nockieboy/gpu/docs/MAX3421E USB HOST INTERFACE.pptx

## MAX3421E USB HOST INTERFACE

Initial setup

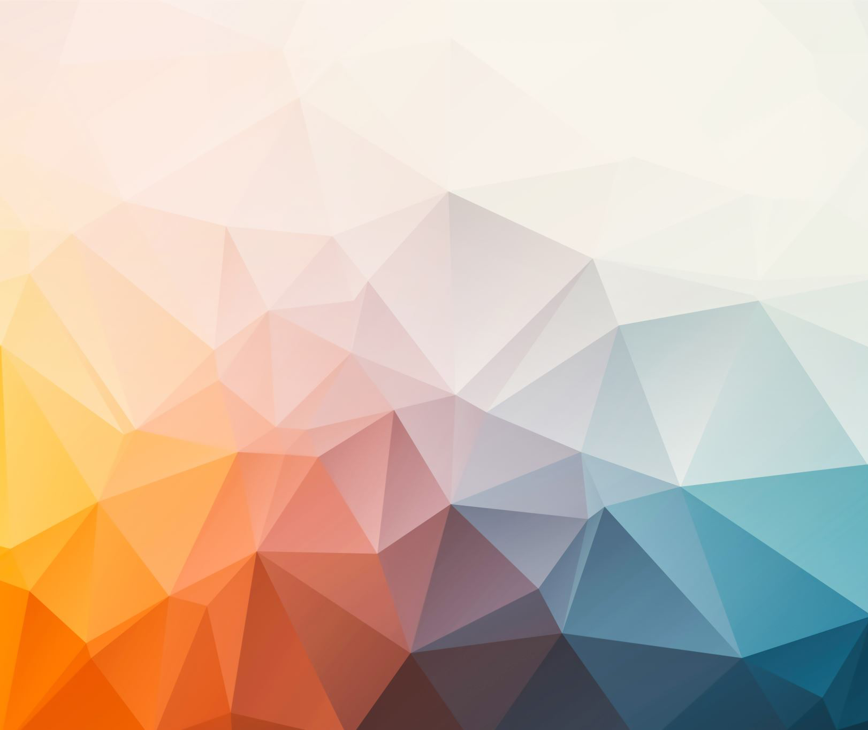
[picture p1: figure]

GPX-OK Initialisation
Set PINCTL:FDUPSPI, POSINT
MAX_reset()
Set IOPINS1:bit 0 off to turn off VBUS
Delay 200ms
Set IOPINS1:bit 1 on to turn on VBUS

Detect Device
Set MODE:DPPULLDN,DMPULLDN,HOST
Set HIRQ:CONDETIRQ
Set HCTL:SAMPLEBUS
Get HRSL & loop until HRSL[7:6] != 0

Set USB Speed
If HRSL[7] then set high speed MODE
SOFKAENAB
If HRSL[6] then set low speed MODE
SPEED, SOFKAENAB

MAX_reset()
Set USBIEN:OSCOKIE
Set USBCTL:CHIPRES
Set USBCTL:0
Delay 100ms
Read USBIRQ
Is OSCOKIRQ set?
Delay 50ms
Return

CTL_Read(value)
Bytes_to_read = value[6] + 256*value[7]
Wrbytes(SUDFIFO,8,value)
Result=Send_Packet(tokSETUP,0)
If (Result) return
Set HCTL:bmRCVTOG1
Result=IN_transfer(0,bytes_to_read)
If (Result) return
IN_nak_count = nak_count
Result=Send_Packet(tokOUTHS,0)
If (Result) return
Return

NO

Pause
Waitframes(200)
(Some devices require this)

waitframes(value)
Set HIRQ:FRAMEIRQ (clear any pending)
Get HIRQ:FRAMEIRQ
Loop until FRAMEIRQ is set
Increment counter
Does counter = value?
Return

Enumerate Device
BUS RESET
GET DEVICE DESCRIPTOR
BUS RESET
SET ADDRESS TO 7(?)
GET DEVICE DESCRIPTOR AT ASSIGNED ADDRESS

NO

## Device enumeration

- BUS RESET SET HCTL:BUSRST, then wait until HCTL:BUSRST goes LOW WaitFrames(200) to allow the device to recover from the bus reset
- GET DEVICE DESCRIPTOR maxPacketSize = 8 SET PERADDR:0 // first request to address 0 Get_Descriptor_Device[6]=8 // wLengthL Get_Descriptor_Device[7]=0 // wLengthH HR = CTLRead(Get_Descriptor_Device) // get device descriptor info into XfrData[] If (4-bit HRSL > 0) return // if HRSL bits report error maxPacketSize = XfrData[7]
- BUS RESET (as top)
- SET ADDRESS TO 7 HR = CTL_Write_ND(Set_Address_to_7) // CTL-Write, no data stage If (4-bit HRSL > 0) return // if HRSL bits report error WaitFrames(30) // Device gets 2 msec recovery time SET PERADDR:7 // Now all transfers go to addr 7
