nockieboy/gpu/docs/SD/SD_Interface.pptx

HOST COMMUNICATION WITH SD INTERFACE
Process/requirements:
- Set DMA memory location
- Write data to DMA memory location / clear DMA memory for RD
- Set sector address in SD interface
- Send command for RD/WR
- Loop if necessary
(Above relates primarily to lines 1346-1395 in CBIOS.ASM)
Interface requirements:
- Ability to send 32-bit commands to SD interface – 1 I/O port
- Ability to send 32-bit data to SD interface – 1 I/O port
If a fixed DMA address is used in DDR3 RAM, the second I/O port is not needed.

## Slide 2

ALL REGISTERS ARE 32-bit:
0x00 – ARGUMENT REGISTER (write to this to trigger command transaction)
0x01 – COMMAND REGISTER (low 16 bits):
15 14 13 12 11 10 9 8 7 6 5 4 3 2 1 0
Writing to the SD interface involves setting the COMMAND REGISTER first, then writing data (to be written, or I guess zeros if a read) to the ARGUMENT REGISTER.

COMMMAND INDEX

XFER SPEC

Chk response
for correct
command
index

Check
response
CRC

Chk response
for busy signal
after command
transaction

CHK CFG

## Slide 3

SD Interface – REGISTER read/writes
COMMAND’s upper two bytes will be zeros, the lower two bytes set by two I/O ports used for the upper and lower 8-bits. Reading these I/O ports will return current values for upper & lower 8-bits.
BRIDGETTE will assemble ARGUMENT as a 32-bit word from a pipelined set of I/O writes to one I/O port, incrementing to next byte in the 32-bit word with each write, from low to high significance.
Reading this I/O port will indicate which byte of the word is to be filled next (current byte pointer). Upon the 3rd (0-based) value being written, BRIDGETTE will construct two 32-bit transactions for the SD interface and transmit them over the Wishbone interface.
Total I/O ports required: 3.
This is only for access to the SD interface’s registers. SD card read/write operations will use the SD buffer in GPU RAM and just have the read/write transaction initiated through writing to the interface registers as outlined above.
