nockieboy/gpu/docs/USB HID Interface.docx

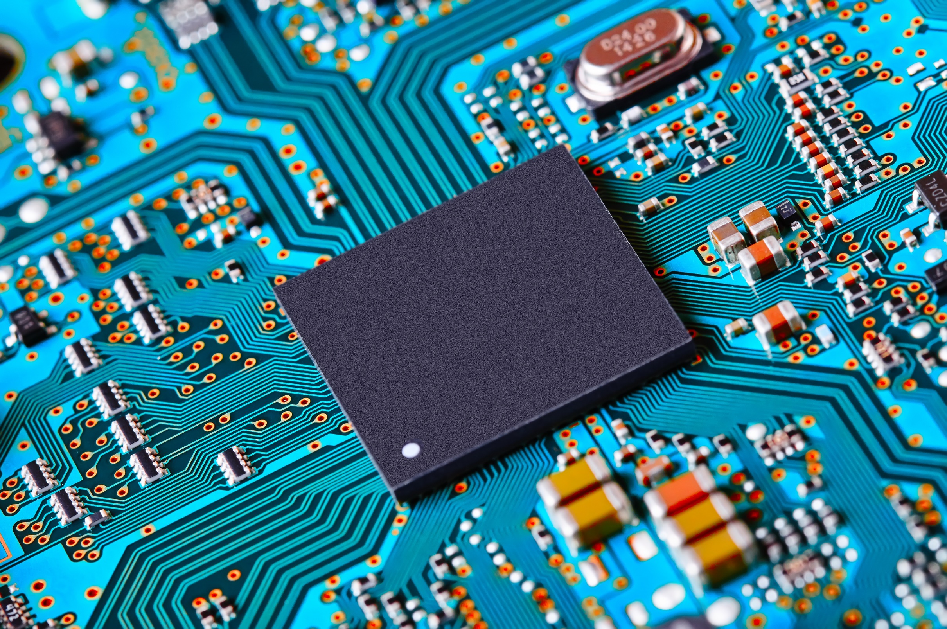
[picture p10: figure]
IT Infrastructure & Electronics Executive Search & Headhunters | Odgers Berndtson

# USB KEYBOARD INTERFACE

USB hid interface for the ucom

10103

Authored by: Jonathan Nock

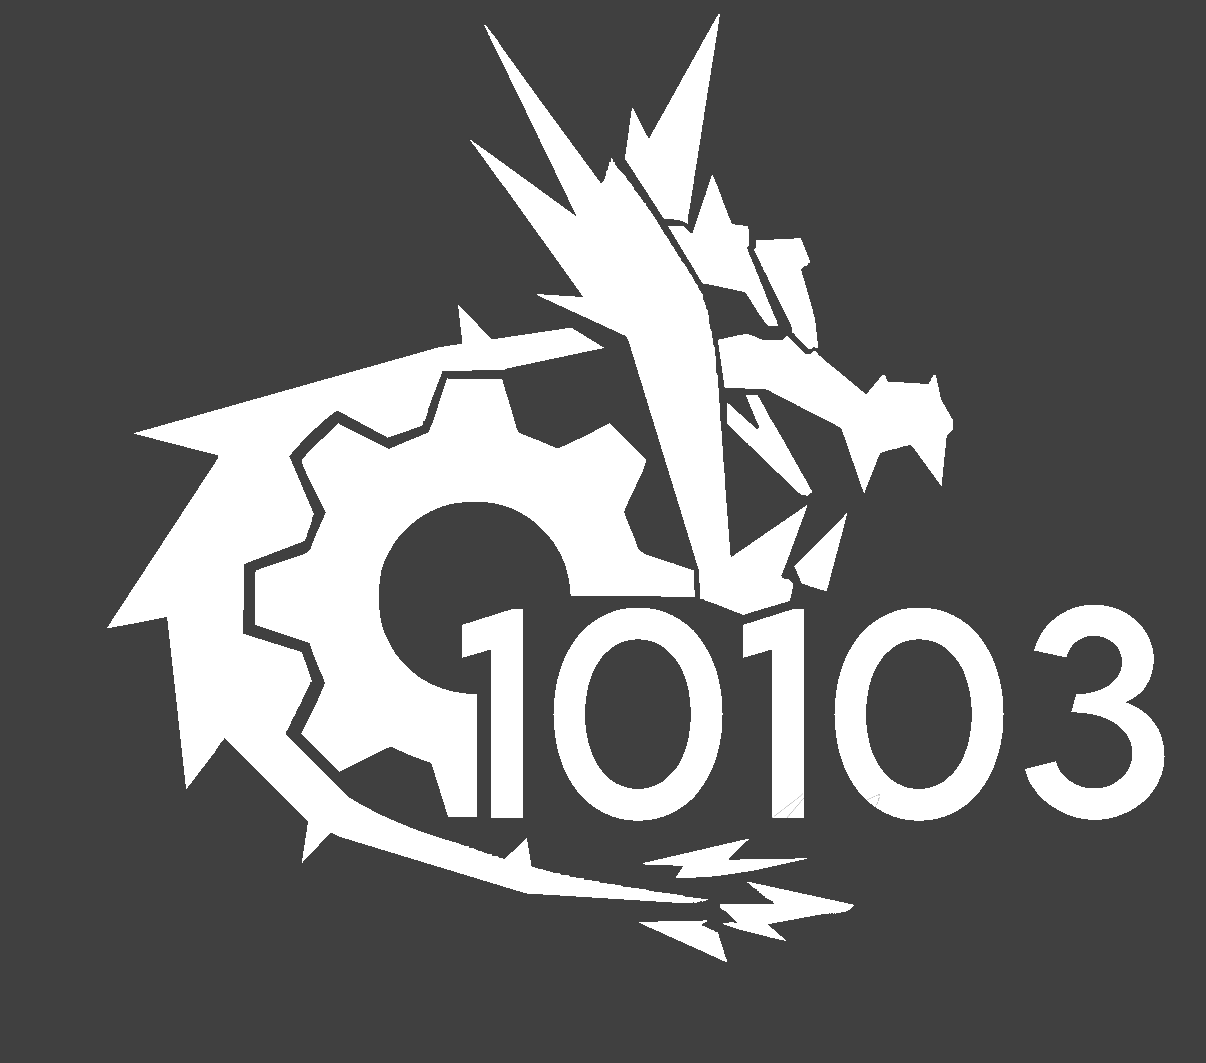
[picture p11: figure]

Notes:
