nockieboy/gpu/docs/GPU_Resolutions.pptx

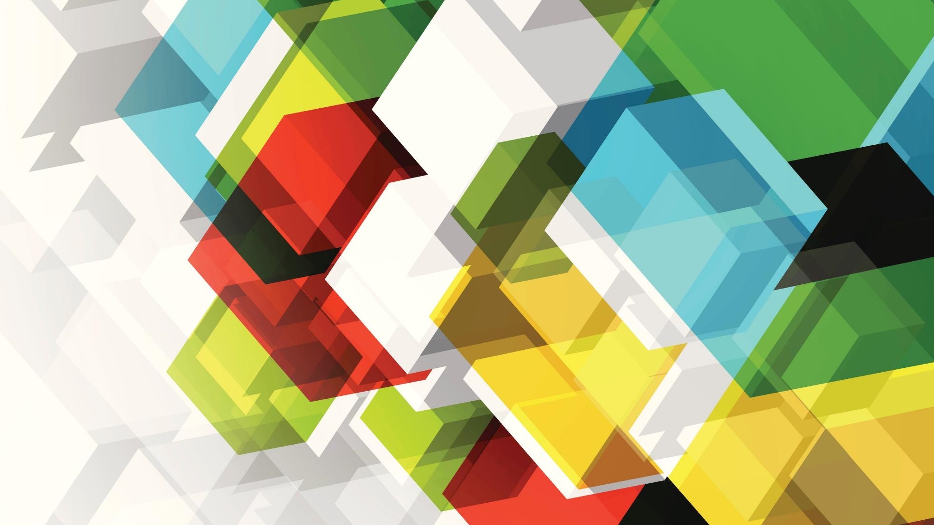
[picture p12: figure]
abstract image

GPU – Resolutions & Memory Requirements

Resolution | Pixels | Bitplanes | Colours | RAM (Kbytes)
320x240 | 76.8K | 1 | 2 | 9.6
320x240 | 76.8K | 2 | 4 | 19.2
320x240 | 76.8K | 4 | 16 | 38.4
320x240 | 76.8K | 8 | 64 | 76.8
320x240 | 76.8K | 16 | 4,096 | 153.6
640x480 | 307.2K | 1 | 2 | 38.4
640x480 | 307.2K | 2 | 4 | 76.8
640x480 | 307.2K | 4 | 16 | 153.6
640x480 | 307.2K | 8 | 256 | 307.2K
640x480 | 307.2K | 16 | 4,096 | 614.4K

Resolution | Mode | Pixels | Bitplanes | Colours | RAM (Kbytes)
320x200 | 0 | 64K | 4 | 16 | 32
320x240 | 1 | 76.8K | 2 | 4 | 19.2
640x400 | 2 | 256K | 1 | 2 | 32

Sit Dolor Amet
