nockieboy/gpu/docs/2D_Functions.pptx

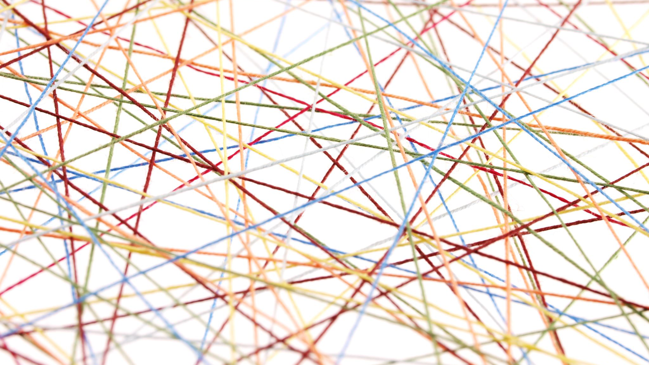
[picture p16: figure]

BRESENHAM LINE DRAWING ALGORITHM

color_val

is_done?
END

INPUTS

x0,y0

Set sign for loop
dx = x1 – x0
dy = y1 – y0
dx < 0 ? sx = -1
else sx = 1
dy > 0 ? sy = 1
else sy = -1
Make dx +ve
Make dy -ve

x0,y0

Init loop vars
magic = 0
errd = dx + dy
x = x0
y = y0
is_done = FALSE

x1,y1

x0,y0,
magic,
errd,
x,
y,
is_done

PLOT x,y,color_val

is_done = (x1 = x1 & y = y1)

dx,dy

If (magic < dx) then
errd += dx
y += sy

If (magic > dy) then
errd += dy
x += sx

x1,y1

magic = errd << 1
