nockieboy/gpu/GPU_TEST_AUDIO/logisim-evolution/boards_model/MAX_V_Console/Assignation_Pin.xlsx

Console | EPM_25_25_C | EPM_25pin Con | Max_V_C
L0 | PIN_36 | FPGAPin_0 | PIN_R13
L1 | PIN_34 | FPGAPin_1 | PIN_T12
L2 | PIN_31 | FPGAPin_2 | PIN_P12
L3 | PIN_29 | FPGAPin_3 | PIN_T11
L4 | PIN_27 | FPGAPin_4 | PIN_P11
L5 | PIN_24 | FPGAPin_5 | PIN_R10
L6 | PIN_21 | FPGAPin_6 | PIN_T9
L7 | PIN_18 | FPGAPin_7 | PIN_P9
S0 | PIN_16 | FPGAPin_8 | PIN_T8
S1 | PIN_12 | FPGAPin_9 | PIN_P8
S2 | PIN_10 | FPGAPin_10 | PIN_T7
S3 | PIN_8 | FPGAPin_11 | PIN_P7
S4 | PIN_5 | FPGAPin_12 | PIN_R6
S5 | PIN_35 | FPGAPin_13 | PIN_P13
S6 | PIN_33 | FPGAPin_14 | PIN_R12
S7 | PIN_30 | FPGAPin_15 | PIN_N12
HEX_0a | PIN_28 | FPGAPin_16 | PIN_R11
HEX_0b | PIN_25 | FPGAPin_17 | PIN_T10
HEX_0c | PIN_22 | FPGAPin_18 | PIN_P10
HEX_0d | PIN_20 | FPGAPin_19 | PIN_R9
HEX_1a | PIN_17 | FPGAPin_20 | PIN_J2
HEX_1b | PIN_15 | FPGAPin_21 | PIN_R8
HEX_1c | PIN_11 | FPGAPin_22 | PIN_B1
HEX_1d | PIN_9 | FPGAPin_23 | PIN_R7
nClk | PIN_4 | FPGAPin_24 | PIN_T6
