nockieboy/gpu/(list of files, cad)

Other CAD files:
GPU_DECA_DDR3_beta_v15/SignalTap.stp
GPU_DECA_DDR3_new/SignalTap.stp
GPU_DECA_DDR3_version_16/z80_analysis.stp
GPU_DECA_DDR3_version_16_bak/yt49_analysis.stp
GPU_DECA_DDR3_version_16_bak/z80_analysis.stp
GPU_DECA_DDR3_version_16_bak/jt49_analysis.stp
GPU_DECA_DDR3_version_16_bak/ym2149_analysis.stp
GPU_DECA_DDR3_version_16_bak/SDI.stp
GPU_DECA_DDR3_version_16_bak/sd_analysis.stp
GPU_DECA_DDR3_version_16_bak/wb_analysis.stp
GPU_DECA_DDR3_version_15/SignalTap.stp
