nockieboy/gpu/docs/uCOM GPU v16 Manual.docx

# µCOM GPU v16 MANUAL

A hardware and software guide to using the µCOM GPU

10103

Authored by: J.Nock

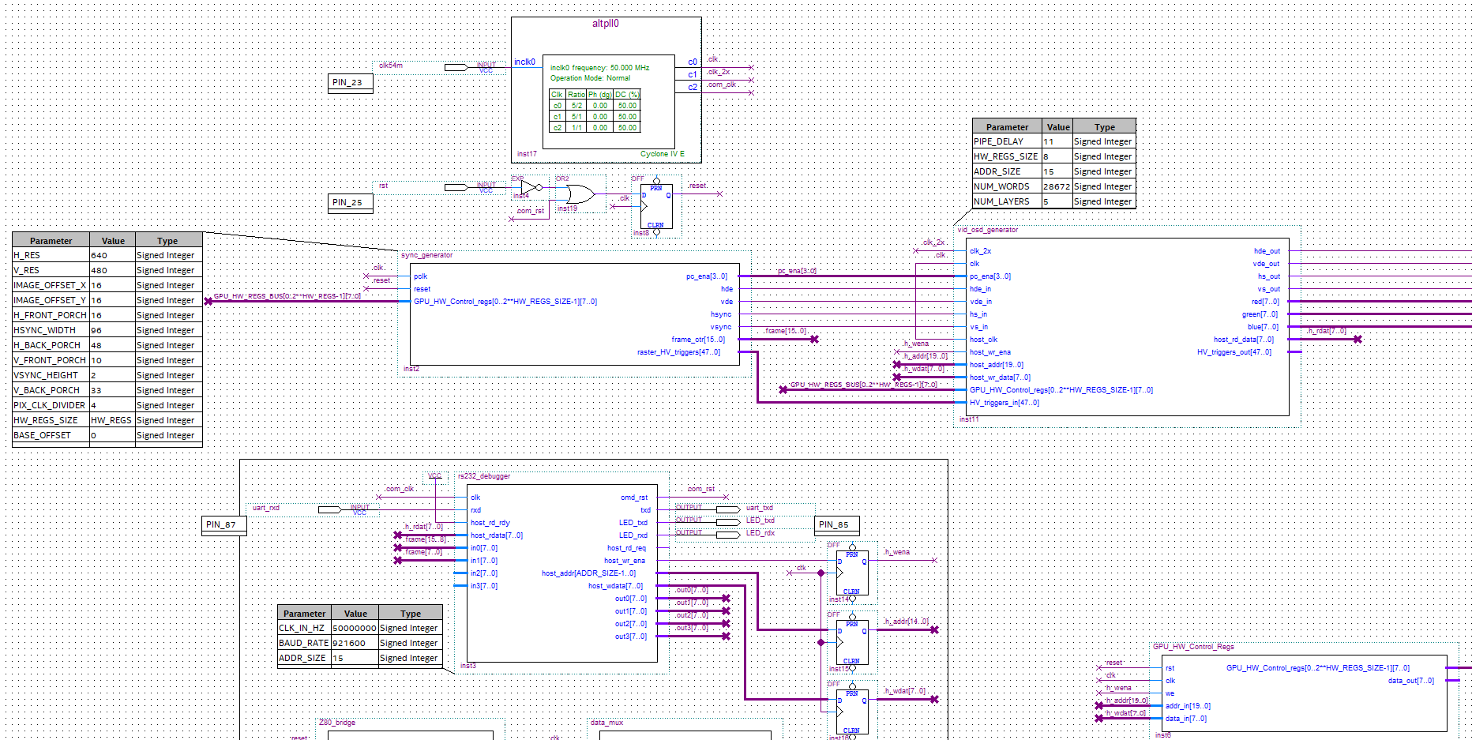
[picture p18: figure]

## Technical Specifications

Depending on the FPGA used in the uCOM GPU card, the following features will be available in varying capacities. Listed below are minimum specifications based on an Intel

Cyclone V 5CEBA2 FPGA (2nd-generation video card):

- 170KB FPGA graphics RAM, plus 1 KB for palettes
- 16MB scratchpad RAM
- Up to 20 graphics layers
- 24-bit audio
- 720x480 resolution in 256 colours at 60 fps (DVI-D/HDMI)
- Full HDMI resolution at 60fps
- 24-bit true-colour output

IMPORTANT NOTE: This is a living document. It is by no means finalised as the FPGA development is still ongoing, so details and information in this document are liable to change without notice.

## Host Memory Map & Registers

The uCOM GPU uses a vacant 512KB slot in the host system’s memory space – see the uCOM’s manual for more information on this. This 512KB window is filled with the GPU’s own RAM – if the GPU has less than 512KB of RAM, accessing memory above the GPU’s upper memory limit will return FF values and be read-only (writes will be ignored).

Only the last 16 bytes of the last page of the (first) 512KB will return anything other than FF, and this will be the BANK_ID as per the uCOM’s memory specifications. This is a pseudo-ROM location, with a value returned from a hardwired value in the HDL of the FPGA.

If the GPU has more than 512KB of RAM, it will be made available to the host using two internal MMU registers which will map any 512KB bank of the GPU’s RAM to the host’s GPU memory ‘window’.

For GPUs with access to scratchpad RAM, this will be presented as paged-RAM within the uCOM’s 512KB memory window, controlled via IO writes/reads to the GPU Memory Controller.

## Memory map for DECA development FPGA

| | | GPU MEMORY MAP
ADDRESS | BANK GPU / HOST | FUNCTION | | NOTES
00F0h | 0 / 40h | HWREG LSWAP Values | | 16 bytes.
0100h | 0 / 40h | HWREG Base Address | | See page 7 for details.
1000h | 0 / 40h | Layer 0 Palette Address | | RGBA palette, 400h / 1,024 bytes long.
1400h | 0 / 40h | Layer 1 PBA | | RGBA palette, 400h / 1,024 bytes long.
1800h | 0 / 40h | Layer 2 PBA | | RGBA palette, 400h / 1,024 bytes long.
1C00h | 0 / 40h | Layer 3 PBA | | RGBA palette, 400h / 1,024 bytes long.
… | 0 / 40h | Layer x PBA | | RGBA palette, 400h / 1,024 bytes long.
4000h | 0 / 41h | Tile Base Address | | Start of font table.
5000h | 0 / 41h | SD card buffer | | Read/Write buffer for SD card interface.
5200h | 0 / 41h | Free space | | 3,584 bytes free.
6000h | 0 / 41h | Start of video memory | | Variable size, mode dependent – see below:
5 A600h | 0 / 56h | Start of free GPU RAM | | For 720x480x8 (480p) Mode 0.
1C 8000h | 3 / 52h | Start of free GPU RAM | | For 1280x720x8 (720p) Mode 1.
20 0400h | 4 / 40h | Start of free GPU RAM | | For 1920x1080x8 (Full HD) Mode 2.

# Hardware Registers (HW_REGS) Map

HWREG_BASE_ADDRESS +
Off | Bits | Value
00 | 32 | Base address for screen memory.
04 | 8 | Screen enable & bpp. Bit 7 = Enable. Bits 2-0 = bpp.
05 | 8 | Alpha adjust = 100% Opaque *8-bit SIGNED value (+127 to -128)
06 | 16 | Bitmap width. In tile mode, # tiles wide. Align to every 4 bytes.
08 | 16 | Bitmap X offset.
0A | 16 | Bitmap Y offset.
0C | 16 | Window X position.
0E | 16 | Window Y position.
10 | 16 | Window width.
12 | 16 | Window height.
14 | 8 | Scale width.
15 | 8 | Scale height.
16 | 16 | Tile/font base address
18 | 8 | Tile Mode – bit 7 = Enable, Bits 2-0 = Tile bpp.
19 | 8 | Tile Width x Height. Bits 5-4 = width, bits 1-0 = height (0,1,2,3 = 4,8,16,32 pixels)
1A | 8 | Global system 24-bit background colour - RED
1B | 8 | Global system 24-bit background colour - GREEN
1C | 8 | Global system 24-bit background colour - BLUE
1F | 8 | Bits 6-4 = VIDEO_MODE, bits 2-0 = CLK_DIVIDER

Window Layer Address Offsets
Window | HWREG_BASE_ADDRESS + offset | Palette Address Offset (PALETTE+)
0 | 000 | 0000h
1 | 020 | 0400h
2 | 040 | 0800h
3 | 060 | 0C00h
4 | 080 | 1000h
5 | 0A0 | 1400h
6 | 0C0 | 1800h
7 | 0E0 | 1C00h
8 | 100 | 2000h
9 | 120 | 2400h
10 | 140 | 2800h
11 | 160 | 2C00h
12 | 180 | 3000h
13 | 1A0 | 3400h
14 | 1C0 | 3800h
15 | 1E0 | 3C00h

HWREG_BASE_ADDR_LSWAP +
Off | Bits | Value
00 | 8 | On PDI_layer 0 output, do not swap the sequential order of the SDI_layers
01 | 8 | On PDI_layer 1 output, do not swap the sequential order of the SDI_layers
02 | 8 | On PDI_layer 2 output, do not swap the sequential order of the SDI_layers
03 | 8 | On PDI_layer 3 output, do not swap the sequential order of the SDI_layers
04 | 8 | On PDI_layer 4 output, do not swap the sequential order of the SDI_layers
05 | 8 | On PDI_layer 5 output, do not swap the sequential order of the SDI_layers
06 | 8 | On PDI_layer 6 output, do not swap the sequential order of the SDI_layers
07 | 8 | On PDI_layer 7 output, do not swap the sequential order of the SDI_layers
08 | 8 | During SDI_layer phase 0, do not swap around any of the PDI_layers
09 | 8 | During SDI_layer phase 1, do not swap around any of the PDI_layers
0A | 8 | During SDI_layer phase 2, do not swap around any of the PDI_layers
0B | 8 | During SDI_layer phase 3, do not swap around any of the PDI_layers
0C | 8 | During SDI_layer phase 4, do not swap around any of the PDI_layers
0D | 8 | During SDI_layer phase 5, do not swap around any of the PDI_layers
0E | 8 | During SDI_layer phase 6, do not swap around any of the PDI_layers
0F | 8 | During SDI_layer phase 7, do not swap around any of the PDI_layers

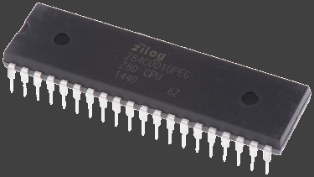
[picture p19: figure]

# GPU IO ports

Bridgette in the GPU exposes some specific IO addresses to the host to facilitate extra hardware functions, listed below. The IO addresses are separate from the GPU RAM address space and are easily customizable in Quartus via the parameter settings in the Z80_bridge module.

IO Addr | Read/Write | Function | Page
222 / DE | Read/Write | FPU Input A – 32-bit value in I/O ports 222-226.
227 / E3 | Read/Write | FPU Input B – 32-bit value in I/O ports 227-231.
232 / E8 | Read/Write | FPU Output Q – 32-bit value in I/O ports 232-236.
237/ ED | Read/Write | FPU Format Switch
238 / EE | Read/Write | PSG LATCH | 10
239 / EF | Write-only | PSG_WRITE | 10
240 / F0 | Read-only | SD_STATUS | 12
241 / F1 | Read/Write | SD_SECTOR | 12
242 / F2 | Write-only | SD_MODE | 12
243 / F3 | Read/Write | SD_ARG_PTR | 12
244 / F4 | Write-only | VIDEO OUTPUT ENABLE (0 = off, >0 = on)
245 / F5 | Read/Write | RNG
246 / F6 | Write-only | GPU GEOFF LBR – Low-Byte Register (0-255) | 16
247 / F7 | Write-only | GPU GEOFF HBR – High-Byte Register (0-255) | 16
248 / F8 | Read-only | GPU FIFO Status (FIFO_Full on bit 0)
249/ F9 | Read/Write | GPU_MMU Low Byte
250 / FA | Read/Write | GPU_MMU High Byte

# PSG MODULE

The GPU also includes a pair of HDL YM2149 (AY-3-891x compatible) cores, written and tuned to provide authentic, highly accurate sound reproduction through the HDMI output to your TV and via line-out to an audio system of your choice.

The PSG cores provide full compatibility with the original YM2149 and AY-3-891x-series 8-bit programmable sound generator chips used in countless arcade games and 8-bit computers of the 1980’s, but with some modern enhancements. Two YM2149s are synthesized on the FPGA, both accessible via the same two IO ports as listed, by addressing their relevant registers.

The PSG module exposes to IO ports – PSG LATCH and PSG WRITE. These IO ports provide access to both of the YM2149 cores by writing to PSG LATCH to select a PSG Register to read/write – the PSG Registers are listed on the next page. Once this is done, a READ to PSG LATCH will read the current value of the selected register. A write to PSG WRITE will write new data to the selected register.

This interface method echoes the AY-3-8912 PSG chip interface on the Amstrad CPC range of computers and provides compatibility with legacy programs designed to play sound/music on those systems.

## PSG Registers

PSG Module Register | | Register Size | PSG A Address | | PSG B Address
Channel A Tone Period | Fine Tune A | 8-bit | 0 | | 16
| Course Tune A | 4-bit | 1 | | 17
Channel B Tone Period | Fine Tune B | 8-bit | 2 | | 18
| Course Tune B | 4-bit | 3 | | 19
Channel C Tone Period | Fine Tune C | 8-bit | 4 | | 20
| Course Tune C | 4-bit | 5 | | 21
Noise Period | Period Control | 5-bit | 6 | | 22
Enable | See datasheet | 8-bit | 7 | | 23
Channel A Amplitude | See datasheet | 5-bit | 8 | | 24
Channel B Amplitude | See datasheet | 5-bit | 9 | | 25
Channel C Amplitude | See datasheet | 5-bit | 10 | | 26
Envelope Period | Fine Tune | 8-bit | 11 | | 27
| Coarse Tune | 8-bit | 12 | | 28
Env Shape/Cycle | Cont/Att/Alt/Hold | 4-bit | 13 | | 29
IO Port A | Unused | -- | 14 | | 30
IO Port B | Unused | -- | 15 | | 31
Left/Mono Channel Mixer Controls | Channel A Volume | 8-bit | 128 | | 131
| Channel B Volume | 8-bit | 129 | | 132
| Channel C Volume | 8-bit | 130 | | 133
| Master Volume | 8-bit | 134
| Invert | 8-bit | 135
| Bass | 8-bit | 136
| Treble | 8-bit | 137
Right/Stereo Channel Mixer Controls | Channel A Volume | 8-bit | 144 | 147
| Channel B Volume | 8-bit | 145 | 148
| Channel C Volume | 8-bit | 146 | 149
| Master Volume | 8-bit | 150
| Invert | 8-bit | 151
| Bass | 8-bit | 152
| Treble | 8-bit | 153

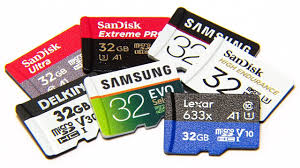
[picture p20: figure]
Explaining SD Cards: 2020 Update - YouTube

# SD CARD INTERFACE

An SD card interface is part of the GPU card, providing a removable permanent storage solution instead of legacy CompactFlash cards or other storage solutions. It is not hot-swappable.

It is accessed via four I/O ports as listed on page 9. The interface uses a 32-bit register for the sector address, fully accessible to 8-bit hosts via four sequential writes to the SD_SECTOR port; each write automatically increments the SD_SECTOR_PTR pointer to the next byte in the SD_SECTOR word. The SD_SECTOR_PTR determines which byte of the 32-bit SD-SECTOR word is immediately accessible via the SD_SECTOR IO address, and should be zeroed before each write to ensure no erroneous sector addresses are passed to the SD interface due to misaligned data. A 2-bit CMD port and 8-bit STATUS register complete the interface.

Reading the SD_STATUS I/O port returns a byte with a number of flags and values as laid out in the table below:

Bit | 7 | 6 | 5 | 4 | 3 | 2 | 1 | 0
Value | RD_RDY | SD Card Type | | WR_Busy | WR_OK | CRC_OK | Timeout | Busy

# GRAPHICS PROCESSING UNIT

The GPU is a powerful hardware module in the FPGA that performs basic graphics functions on behalf of the host system – including:

1. Pixel plotting (X[0], Y[0])
2. Line drawing (X[0], Y[0] to X[1], Y[1])
3. Filled/unfilled rectangle (X[0], Y[0] to X[1], Y[1])
4. Filled/unfilled triangle (X/Y[0], X/Y[1], X/Y[2])
5. Filled/unfilled quadrilaterals (X/Y points [0] to [3])
6. Blitter copy/paste with rotation & scaling

As well as the primary drawing functions, there are several support functions:

- Set 24-bit destination screen memory pointer
- Set 24-bit source screen memory pointer
- Set byte-width for destination raster (in x[n], y[n]) (n = 2 to 3)
- Set byte-width for source raster (in x[n], y[n]) (n = 2 to 3)
- Set maximum bitmap width & height to x[n], y[n] (n = 0 to 3)
- Clear pixel collision counter
- Clear blitter copy pixel collision counter

## PALETTES

The palettes are held in GPU RAM at a location specified in the HDL, defaulting to 0x1000 – which equates to Bank 0x40, offset +0x1000. The palettes are 8-bit RBGA, so four bytes for each palette colour entry (with each channel – red, green, blue and alpha – having values from 0-255).

Each palette is 256x4 bytes/1KB/0x400 bytes in size and there are 16 in total, one for each Layer.

PDI Layer | Offset (Hex) | Address
0 | +0000 | 1000
1 | +0400 | 1400
2 | +0800 | 1800
3 | +0C00 | 1C00
4 | +1000 | 2000
5 | +1400 | 2400
6 | +1800 | 2800
7 | +1C00 | 2C00
8 | +2000 | 3000
9 | +2400 | 3400
10 | +2800 | 3800
11 | +2C00 | 3C00
12 | +3000 | 4000
13 | +3400 | 4400
14 | +3800 | 4800
15 | +3C00 | 4C00

## FONTS

A default font is held in the GPU; however, a system font is also held in the host system’s ROM and is copied to the GPU’s RAM at startup, allowing custom fonts to be used. The font table can reside within a limited area of the GPU’s RAM (it is actually stored in the FPGA’s block RAM, not the DDR3 RAM), with software specifying its location.

## TILE MODE / TILE-ENABLED PDI LAYER

This is a specific screen mode that uses tokens to represent characters, or tiles, on the screen. A token can be a single byte or more depending on the CMD_vid_bpp mode, representing from 255-1,024 possible tiles.

As each token represents a tile that can be 8x8 up to 32x32 pixels, it represents a more efficient use of screen memory than a pure graphics mode.

The token’s value is used as an offset into the tile memory, calculated based on the width/height value set for the tiles, and this is done automatically by the GPU – it is essential that the HW_REGs are set correctly however, otherwise you’ll get graphical artefacts.

## CMD_vid_bpp modes

MODE | TOKEN/BYTE FORMAT | | | | | | | | NOTES
8 bpp | 8’h00 | | | | | | | | 8 bits / 255 possible tiles
| BGC | FGC | | Char/Tile | | | | | BGC & FGC are x16 in this mode
16a bpp | { 4’h0, | 4’h0, | | 8’h00 } | | | | | 16 bits / 256 possible tiles
| FLIP | MIR | | FGC | | Char/Tile | | | FGC is x16 in this mode.
16b bpp | { 1’b0, | 1’b0, | | 4’h0, | | 10’h000 } | | | 16 bits / 1024 possible tiles
| BGC | FGC | FLIP | | MIR | | N/A | Char
32 bpp | { 8’h00, | 8’h00, | 1’b0, | | 1’b0, | | 4’h00, | 10’h000 } | 32 bits / 1024 possible tiles

The contents of a tile set can be 1/2/4/8/16a/32/16b bpp, whilst the tile set itself must be one of the above modes. The tile set can only be as large as the reserved fixed available FPGA block RAM. It is possible to have multiple tile layers when using the 'SDI_LAYERS' feature where each layer may share or have different tile sets so long as there is enough room in the single reserved FPGA block RAM.

## Understanding Layer Order, priority, and swapping control logic.

For now, layer 0 is on top and each higher layer number progressively is below / lower priority. Don't forget that if the bottom layer has transparent pixels right through the top layer, then the BGC set will become the displayed colour.

With 16 layers, parameters are:

PDI_LAYERS = 4

SDI_LAYERS = 4

This means that the layers 0 through 15:

PDI layer 0 -> SDI 0,1,2,3 = Layer 0,1,2,3

PDI layer 1 -> SDI 0,1,2,3 = Layer 4,5,6,7

PDI layer 2 -> SDI 0,1,2,3 = Layer 8,9,10,11

PDI layer 3 -> SDI 0,1,2,3 = Layer 12,13,14,15

Note that to save on Block RAM resources, the TILE/FONT mode & memory is only available for PDI_LAYER 0. This means the tile/font mode is only functional on layers 0, 1, 2 & 3. The available RAM for the font is set to 65536 bytes. This means a 256-character 16x16 pixel font with 8 bpp, i.e., 256 colours per pixel font is possible.

The 'CLK_DIVIDER' must be at least 3 to have all SDI layers 0, 1, 2 & 3 functional.

## TILE/FONT RESERVED MEMORY IN THE FPGA

Two parameters in the HDL determine the amount of memory (and its location) reserved for tile sets. These are TILE_BYTES and TILE_BASE_ADDR. By default, 64KB is reserved at an offset of 0x4000.

This means that when the host or any peripheral writes to 0x4000-0x13FFF, they are actually writing to tile block memory from 0x0000-0xFFFF.

Writing a font beginning at 32’h00004000 means its tile block RAM address begins at 20’h00000. A font beginning at 32’h00005000 actually starts at 20’h01000.

Tile/font sets must start on a 16-byte boundary, as the CMD_win_tile_base address is multiplied by 16, to allow addressing higher than 64KB in block RAM.

## COMMAND/DATA WRITE ORDER

The GPU has a 16-bit interface, driven by dual 8-bit IO writes from the host in little-endian format – the LOW byte is always written first to the GPU_LBR IO port, then the HIGH byte is written to the GPU_HBR IO port, which causes the GPU to act on the received 16-bit data/command. Exact port values may vary from one GPU HDL version and host hardware implementation to another, but more information on specific IO port values can be obtained on page 9.

Data/commands must be written in 16-bit pairs – even if a value of zero is required for a command, the low byte should have zero written to it before writing to the High-Byte Register. This ensures the Low-Byte Register does not insert garbage values into the GPU’s video/geometry engines.

## HARDWARE COMMANDS

### X & Y registers – (80-B0 for X[0-3], C0-F0 for Y[0-3])

There are four 12-bit X and Y registers, X[0-3], Y[0-3]. Their contents are set using the 8-bit Low-Byte Register (LBR) and High-Byte Register (HBR) which combine to create a 16-bit input. As with all data sent to the GPU, the low byte must be written first to the LBR at port 246, followed by the high byte to the HBR at port 247.

NOTE: The command bytes (sent to the High-Byte Register) may also include data in their lower nybble to allow passing 12-bit values with one command.

HIGH BYTE (HBR) | | | | | | | | LOW BYTE (LBR)
High Nybble | | | | Low Nybble | | | | High Nybble | | | | Low Nybble
7 | 6 | 5 | 4 | 3 | 2 | 1 | 0 | 7 | 6 | 5 | 4 | 3 | 2 | 1 | 0
1 | R | n | n | ? | ? | ? | ? | ? | ? | ? | ? | ? | ? | ? | ?

R – HBR bit 6 (register bit 14) – Register Select

This bit determines which register – X or Y – is being written to. 0 = X, 1 = Y.

nn – HBR bits 5 & 4 (register bits 13 & 12)

These bits specify which of the four X/Y registers to write to.

? – bits 0-11 are 12 data bits to be written to the specified register. Room for three nybbles (or three hex digits). Note that 4 bits in the HBR (green boxes) can also be used to include data, e.g., when setting a base memory address.

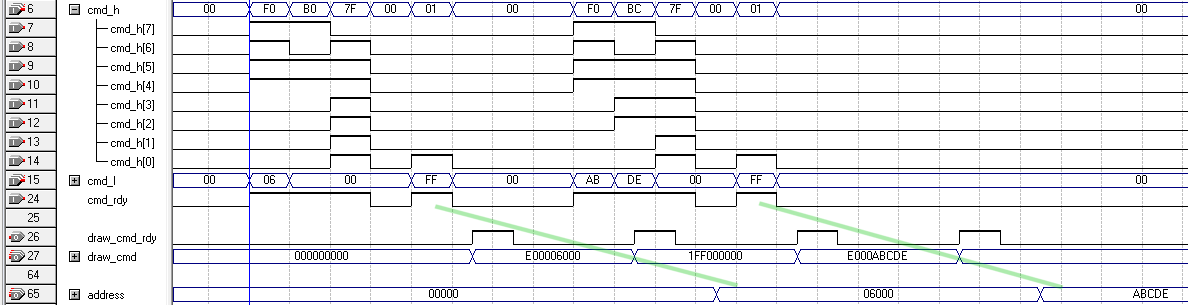
[picture p21: figure]

In the example below, a base address of ABCDE is set by writing 0x0AB to Y[3] with the F0AB command word, and 0xCDE to X[3] with the BCDE command word.

### Set destination screen memory pointer (7C-7F)

The following command sets the destination screen memory pointer to the data in the indicated 12-bit registers. LBR value is ignored.

HIGH BYTE | | | | | | | | LOW BYTE
7 | 6 | 5 | 4 | 3 | 2 | 1 | 0 | 7 | 6 | 5 | 4 | 3 | 2 | 1 | 0
0 | 1 | 1 | 1 | 1 | 1 | n | n | x | x | x | x | x | x | x | x

- nn – specify which of the four X/Y registers to use the data from
- x – don’t care – these bits are ignored

### Set source screen memory pointer (78-7B)

The following command sets the source screen memory pointer to the data in the indicated 12-bit registers. LBR value is ignored.

HIGH BYTE | | | | | | | | LOW BYTE
7 | 6 | 5 | 4 | 3 | 2 | 1 | 0 | 7 | 6 | 5 | 4 | 3 | 2 | 1 | 0
0 | 1 | 1 | 1 | 1 | 0 | n | n | x | x | x | x | x | x | x | x

- nn – specify which of the four X/Y registers to use the data from
- x – don’t care – these bits are ignored

### Set destination raster width – X[2] (73)

Sets the destination raster’s bytes-per-horizontal line to the data in the X[2] register. Y register is ignored. Low byte bits 2-0 specify bits-per-pixel.

HIGH BYTE | | | | | | | | LOW BYTE
7 | 6 | 5 | 4 | 3 | 2 | 1 | 0 | 7 | 6 | 5 | 4 | 3 | 2 | 1 | 0
0 | 1 | 1 | 1 | 0 | 0 | 1 | 1 | x | x | x | x | x | bpp

- x – don’t care – these bits are ignored
- bpp – bits per pixel

### Set source raster width – X[2] (72)

Sets the source raster’s pixels-per-horizontal line to the data in the X[2] register. Y register is ignored. Low byte bits 2-0 specify bits-per-pixel.

HIGH BYTE | | | | | | | | LOW BYTE
7 | 6 | 5 | 4 | 3 | 2 | 1 | 0 | 7 | 6 | 5 | 4 | 3 | 2 | 1 | 0
0 | 1 | 1 | 1 | 0 | 0 | 1 | 0 | x | x | x | x | x | bpp

- x – don’t care – these bits are ignored
- bpp – bits per pixel

### Set destination raster width – X[3] (71)

Sets the source raster’s pixels-per-horizontal line to the data in the X[3] register. Y register is ignored. Low byte bits 2-0 specify bits-per-pixel.

HIGH BYTE | | | | | | | | LOW BYTE
7 | 6 | 5 | 4 | 3 | 2 | 1 | 0 | 7 | 6 | 5 | 4 | 3 | 2 | 1 | 0
0 | 1 | 1 | 1 | 0 | 0 | 0 | 1 | x | x | x | x | x | bpp

- x – don’t care – these bits are ignored
- bpp – bits per pixel

### Set source raster width – Y[3] (70)

Sets the source raster’s bytes-per-horizontal line to the data in the Y[3] register. X register is ignored. Low byte bits 2-0 specify bits-per-pixel.

HIGH BYTE | | | | | | | | LOW BYTE
7 | 6 | 5 | 4 | 3 | 2 | 1 | 0 | 7 | 6 | 5 | 4 | 3 | 2 | 1 | 0
0 | 1 | 1 | 1 | 0 | 0 | 0 | 0 | x | x | x | x | x | bpp

- x – don’t care – these bits are ignored
- bpp – bits per pixel

### Set max width & height of screen – X[0]/Y[0] (5F)

Sets the bitmap dimensions to the data in the 0-index registers (X[0], Y[0]). LBR value is ignored.

HIGH BYTE | | | | | | | | LOW BYTE
7 | 6 | 5 | 4 | 3 | 2 | 1 | 0 | 7 | 6 | 5 | 4 | 3 | 2 | 1 | 0
0 | 1 | 0 | 1 | 1 | 1 | 1 | 1 | x | x | x | x | x | x | x | x

x – don’t care – these bits are ignored.

### Set max width & height of screen – X[1]/Y[1] (5E)

Sets the bitmap dimensions to the data in the 1-index registers (X[1], Y[1]). LBR value is ignored.

HIGH BYTE | | | | | | | | LOW BYTE
7 | 6 | 5 | 4 | 3 | 2 | 1 | 0 | 7 | 6 | 5 | 4 | 3 | 2 | 1 | 0
0 | 1 | 0 | 1 | 1 | 1 | 1 | 0 | x | x | x | x | x | x | x | x

x – don’t care – these bits are ignored.

### Set max width & height of screen – X[2]/Y[2] (5D)

Sets the bitmap dimensions to the data in the 0-index registers (X[0], Y[0]). LBR value is ignored.

HIGH BYTE | | | | | | | | LOW BYTE
7 | 6 | 5 | 4 | 3 | 2 | 1 | 0 | 7 | 6 | 5 | 4 | 3 | 2 | 1 | 0
0 | 1 | 0 | 1 | 1 | 1 | 0 | 1 | x | x | x | x | x | x | x | x

x – don’t care – these bits are ignored.

### Set max width & height of screen – X[3]/Y[3] (5C)

Sets the bitmap dimensions to the data in the 3-index registers (X[3], Y[3]). LBR value is ignored.

HIGH BYTE | | | | | | | | LOW BYTE
7 | 6 | 5 | 4 | 3 | 2 | 1 | 0 | 7 | 6 | 5 | 4 | 3 | 2 | 1 | 0
0 | 1 | 0 | 1 | 1 | 1 | 0 | 0 | x | x | x | x | x | x | x | x

x – don’t care – these bits are ignored.

### Clear pixel collision counter (5B)

Clears the pixel collision counter and sets all three transparent mask colours to one 8-bit colour in the source function data.

HIGH BYTE | | | | | | | | LOW BYTE
7 | 6 | 5 | 4 | 3 | 2 | 1 | 0 | 7 | 6 | 5 | 4 | 3 | 2 | 1 | 0
0 | 1 | 0 | 1 | 1 | 0 | 1 | 1 | ? | ? | ? | ? | ? | ? | ? | ?

? – sets the mask colour.

### Clear blitter copy pixel collision counter (5A)

Clears the blitter copy pixel collision counter and sets all three transparent mask colours to one 8-bit colour in the source function data.

HIGH BYTE | | | | | | | | LOW BYTE
7 | 6 | 5 | 4 | 3 | 2 | 1 | 0 | 7 | 6 | 5 | 4 | 3 | 2 | 1 | 0
0 | 1 | 0 | 1 | 1 | 0 | 1 | 1 | ? | ? | ? | ? | ? | ? | ? | ?

? – sets the mask colour.

# Graphics Commands

Following is a summary of the graphics commands that can be sent to the GPU using the hardware commands listed previously via IO calls, or whatever interface your system uses. All commands are 16-bit, with the low byte sent first.

# | Command | High Byte | Low Byte | Notes

1 | Draw Pixel | 01 | Colour | Draws a pixel at X/Y[0].
2 | Draw Line | 02 | Colour | Draws a line from X/Y[0] to X/Y[1].
3 | Draw Triangle | 03 | Colour | Draws a triangle with points X/Y[0], [1] and [2].
4 | Draw Rectangle | 04 | Colour | Draws a rectangle, top-left corner at X/Y[0], bottom-right corner at X/Y[1].
5 | Draw Quad | 05 | Colour | Draws a quad, corners specified using all four X/Y registers.
6 | Draw Arc | 06 | Colour | Draws an arc (quarter of an ellipse based on quadrant # set in next command). Uses X/Y[0] for centre, X/Y[1] to set X & Y radii. To draw a complete ellipse or circle, this must be executed four times, once for each quadrant.
7 | Quadrant Select | 07 | 0x00-0x03 | Set the ellipse quadrant to draw. This must be set before Draw Arc is executed. To draw a complete ellipse or circle, this must be executed four times, once for each quadrant.
7 | VWAIT | 07 | 0x8#-0xB# (# = 1-F) | 0x8# .. 0x8# => Wait for hw_position*1 to pass by # frames. 0x9# .. 0x9# => Wait for hw_position*2 to pass by # frames. 0xA# .. 0xA# => Wait for hw_position*4 to pass by # frames. 0xB# .. 0xB# => Wait for hw_position*8 to pass by # frames.
…
11 | Filled Triangle | 0B | Colour | Draws filled triangle, points at X/Y[0], [1] and [2].
12 | Filled Rectangle | 0C | Colour | Draws filled rectangle, top-left corner at X/Y[0], bottom-right corner at X/Y[1].
13 | Filled Quad¹ | 0B 0D | Colour Colour | Drawing a quad utilises the Filled Triangle command and the alternative Filled Triangle command that uses points from registers 0, 2 and 3. Point order must be clockwise.
14 | Filled Arc | 0E | Colour | As Draw Arc, except filled.
15 | Set hw_position | 0F | hw_position | Used with VWAIT. Default 0.

1 – This hybrid command requires two sets of 16-bit commands to be sent to the IO port

## VWAIT – 0x07

HIGH BYTE | | | | | | | | LOW BYTE
7 | 6 | 5 | 4 | 3 | 2 | 1 | 0 | 7 | 6 | 5 | 4 | 3 | 2 | 1 | 0
0 | 0 | 0 | 0 | 0 | 1 | 1 | 1 | 1 | 0 | Multiplier | | Multiplicand

The VWAIT command tells the GPU to wait a specified time (using a multiple of the hw_position value) before executing the next instruction. VWAIT shares the same command High Byte as Quadrant Select; Low Byte values 0x00-0x03 are strictly reserved for Quadrant Select, valid range for VWAIT’s Low Byte is 0x81-0xBF.

The multiplier is set by bits 5 and 4 in the Low Byte of the command to x1, x2, x4 or x8 – with the multiplicand being the least-significant nybble (valid range: 0x01-0x0F).

Multiplier | Multiplicand
0x8 | 0x81-0x8F | Wait for (hw_position x 1) to pass by # frames.
0x9 | 0x91-0x9F | Wait for (hw_position x 2) to pass by # frames.
0xA | 0xA1-0xAF | Wait for (hw_position x 4) to pass by # frames.
0xB | 0xB1-0xBF | Wait for (hw_position x 8) to pass by # frames.

## SET HW_POSITION – 0x0F

HIGH BYTE | | | | | | | | LOW BYTE
7 | 6 | 5 | 4 | 3 | 2 | 1 | 0 | 7 | 6 | 5 | 4 | 3 | 2 | 1 | 0
1 | 1 | 1 | 1 | 1 | 1 | 1 | 1 | hw_position

Sets the hw_position value used with the VWAIT command.

hw_position defaults to zero, unless set to another value using this command. A value of zero means the vertical wait position is one line after the display frame has ended, giving the maximum time before the next frame begins to draw.

To request a delay before executing the next command, the multiplicand set with the VWAIT command needs to be 1 or higher to wait multiple frames. A hw_position of 100 and using VWAIT with a Low Byte value of 0xA1 means the pause position will be located 400 line/h-syncs after the end of the display frame.

Values of hw_position larger than the available lines in the frame will cause VWAIT to abort after a 2-frame pause.

# Blitter

The GPU has a fully functional blitter to massively speed up sprite operations (block copy & paste). All draw commands will blit. If you use command '0x01' (plot pixel), the paste will begin at coordinates X/Y[0], or be center-shifted depending on set width & height when ‘Center Paste’ is enabled (see page 29). If you use the line command '0x02', the blitter will paste a new copy of the source image for every single pixel in the source line coordinates X/Y[0] - X/Y[1], using the source image like a brush.

### Blitter Copy Width & Height – X[2]/Y[2] & X[3]/Y[3] (74-75)

Sets the bitmap dimensions to copy – width is set by the X register contents, height by Y. Bit 0 in the High Byte specifies which register set to use (2/3). Each dimension has 1 added (e.g. X[2] = 0 would give a width of 1). Low byte is ignored.

HIGH BYTE | | | | | | | | LOW BYTE
7 | 6 | 5 | 4 | 3 | 2 | 1 | 0 | 7 | 6 | 5 | 4 | 3 | 2 | 1 | 0
0 | 1 | 1 | 1 | 0 | 1 | 0 | n | x | x | x | x | x | x | x | x

- n – specifies which register set (low = X/Y[2], high = X/Y[3])
- x – don’t care – these bits are ignored

### Blitter Source Image Offset – X[2]/Y[2] & X[3]/Y[3] (76-77)

Sets the source image (copy/read) offset. Bit 0 in the High Byte specifies which register set to use (2/3). Low byte is ignored.

HIGH BYTE | | | | | | | | LOW BYTE
7 | 6 | 5 | 4 | 3 | 2 | 1 | 0 | 7 | 6 | 5 | 4 | 3 | 2 | 1 | 0
0 | 1 | 1 | 1 | 0 | 1 | 1 | n | x | x | x | x | x | x | x | x

- n – specifies which register set (low = X/Y[2], high = X/Y[3])
- x – don’t care – these bits are ignored

### Blitter Copy Source Pointer – X/Y[0-3] (78-7B)

Sets the blitter memory source pointer – using the 12-bit Y (MSW) and X (LSW) register contents. Bits 0-1 in the High Byte specifies which register set to use (0-3). Low byte in the command word specifies the source screen mode, or bits per pixel.

HIGH BYTE | | | | | | | | LOW BYTE
7 | 6 | 5 | 4 | 3 | 2 | 1 | 0 | 7 | 6 | 5 | 4 | 3 | 2 | 1 | 0
0 | 1 | 1 | 1 | 0 | 1 | n | n | Screen_mode (bpp) x x x x x x x

- nn – specifies which register set (X/Y[0-3])

### Blitter Copy Destination Pointer – X/Y[0-3] (7C-7F)

Sets the blitter memory destination pointer – using the 12-bit Y (MSW) and X (LSW) register contents. Bits 0-1 in the High Byte specifies which register set to use (0-3). Low byte in the command word specifies the destination screen mode, or bits per pixel.

HIGH BYTE | | | | | | | | LOW BYTE
7 | 6 | 5 | 4 | 3 | 2 | 1 | 0 | 7 | 6 | 5 | 4 | 3 | 2 | 1 | 0
0 | 1 | 1 | 1 | 0 | 1 | n | n | Screen_mode (bpp) x x x x x x x

- nn – specifies which register set (X/Y[0-3])

### Source/Destination X/Y Scaling (09)

Sets the blitter’s scaling function, enabling up- and down-scaling of bitmaps during copy/pasting or disabling scaling altogether.

HIGH BYTE | | | | | | | | LOW BYTE
7 | 6 | 5 | 4 | 3 | 2 | 1 | 0 | 7 | 6 | 5 | 4 | 3 | 2 | 1 | 0
0 | 0 | 0 | 0 | 1 | 0 | 0 | 1 | x | x | x | x | x | x | f | f

- f – specifies scaling option (see table below)
- x – don’t care – these bits are ignored

Bits 0 & 1 of the Low Byte specify the scaling features as per the table below:

Bit | Function | Details
0 | Up-scaling | HIGH – Enables blitter up-scaling of the source image, specified by registers X[0] and Y[0] for width & height accordingly.
1 | Down-scaling | HIGH – Enables blitter down-scaling of the pasted image, specified by registers X[1] and Y[1] for width & height accordingly.

How to calculate a zoom

Valid scale factor settings range from 1-4096. Values outside this range will default the setting back to 4096.

To enlarge the source bitmap, set the down-scaling to 4096 (1:1, or no down-scaling) in the appropriate X/Y[1] registers. Then set the source up-scaling using this ratio: 4096:(set X/Y[0])

For example, if you want your image to be 1:1, then use a down-scale setting of 4096 and an up- scale setting of 4096. If you want your image to be double size, 2:1, then use an up- scale setting of 2048. If you want your image to be 2.32992:1, then use an up- scale setting of 879.

To shrink the destination bitmap, set the up-scale value to 4096. Then set the down- scale value using this ratio: (set X/Y[1]): 4096

If you want your pasted bitmap to be 1:1, then set the down-scale setting to 4096.
If you want your image to be half size, e.g., 1:2, then use a down-scale setting of 2048.
If you want your image to be 0.707:1, or, 1:1.41421, then use a down sample setting of 2896 (this value is relevant to 45-degree rotations on blitted bitmaps).

You may mix different X&Y scale figures including a zoom on one axis and a shrink on the other. Note that the H&V center paste will not work properly with any zoom setting other than 1:1. This is because to obtain the proper center offset based on the source width and height, we need to calculate the reciprocal of the source scale setting to determine the size of the final image which can give us the center offset of that image. A reciprocal is long division and there is no more space in the current FPGA.

### Copy Colour Transform (08)

Sets a colour transformation on the blitter copy command. This causes the blitter to XOR read pixels with the Low Byte of this command.

HIGH BYTE | | | | | | | | LOW BYTE
7 | 6 | 5 | 4 | 3 | 2 | 1 | 0 | 7 | 6 | 5 | 4 | 3 | 2 | 1 | 0
0 | 0 | 0 | 0 | 1 | 0 | 0 | 0 | m | m | m | m | m | m | m | m

- m – 8-bit colour mask value

INPUT | | OUTPUT
A | B | A XOR B
0 | 0 | 0
0 | 1 | 1
1 | 0 | 1
1 | 1 | 0

When using the mask feature the transparent colour is '0x00'. XORing the read pixels with a custom number here other than '0x00' will change the read colour which will simultaneously change what colour will become transparent when a paste/write pixel is done with mask enable.

The chosen drawing colour, in the Low Byte when the drawing command is sent to the GPU, will perform a second XORing of the first XORed pixel copy, then allow you to change the colour once again before the pixel is written.

So, if the source image is monochrome 1-bit color and the destination screen is 4-bit 16 colours, using a number like 0x04 to XOR the read values, will make the output colour 0x04 and 0x05 instead of 0x00 and 0x01.

Be careful not to choose a XOR number larger than the available colours on the destination screen, otherwise garbage will bleed into adjacent pixels.

### Blitter Function – (00)

Enables the blitter and sets its function according to bits 0-2 of the Low Byte (values 0-7):

HIGH BYTE | | | | | | | | LOW BYTE
7 | 6 | 5 | 4 | 3 | 2 | 1 | 0 | 7 | 6 | 5 | 4 | 3 | 2 | 1 | 0
0 | 0 | 0 | 0 | 0 | 0 | 0 | 0 | x | x | x | x | x | f | f | f

- f – sets required function – see table below
- x – don’t care – these bits are ignored

Bit | Function | Details
0 | Blitter | HIGH – Enables blitter, copying source to output coordinates. LOW – Blitter disabled, normal pixel write commands.
1 | Paste Mask | HIGH – Pastes pixels with transparency mask. LOW – Paste pixels even if the source has the selected transparent colour.
2 | Centre Paste | HIGH – Offset the paste up and to the left by half of blit_width/height LOW – Use the paste coordinates as the top-left.

# Appendix A – Character Codepage

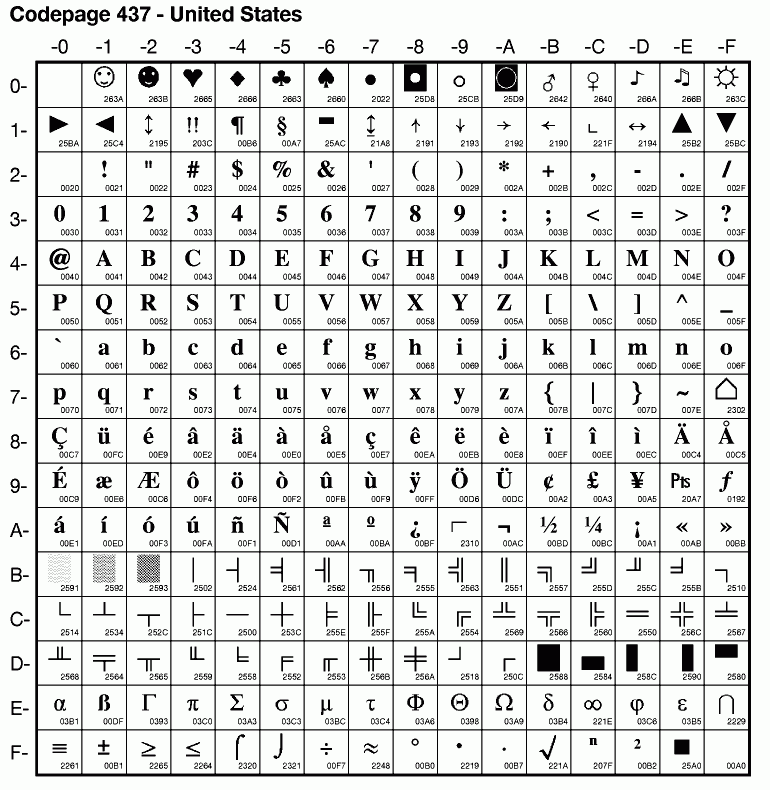
[picture p22: figure]
