nockieboy/gpu/GPU_TEST_AUDIO/logisim-evolution/src/main/resources/doc/de/img-guide/feature-1-label.png

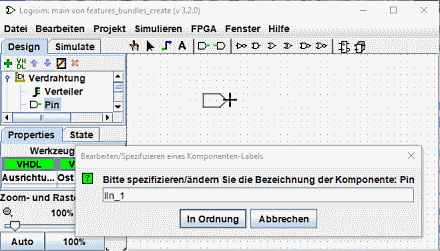
GPU_TEST_AUDIO/logisim-evolution/src/main/resources/doc/de/img-guide/feature-1-label.png
