nockieboy/gpu/GPU_TEST_AUDIO/logisim-evolution/src/main/resources/doc/de/img-guide/feature-2-bundles-create.png

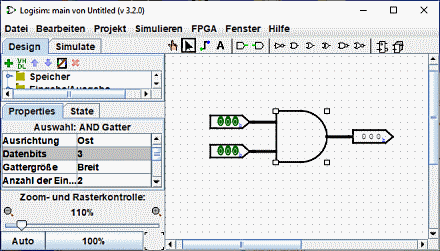
GPU_TEST_AUDIO/logisim-evolution/src/main/resources/doc/de/img-guide/feature-2-bundles-create.png
