nockieboy/gpu/GPU_TEST_AUDIO/logisim-evolution/src/main/resources/doc/de/img-guide/gui-4-and-narrow.png

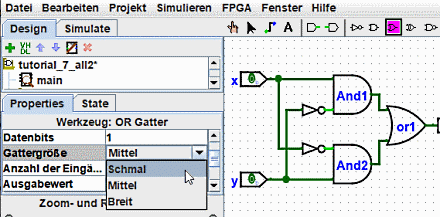
GPU_TEST_AUDIO/logisim-evolution/src/main/resources/doc/de/img-guide/gui-4-and-narrow.png
