nockieboy/gpu/GPU_TEST_AUDIO/logisim-evolution/src/main/resources/doc/de/img-guide/opts-simulate.png

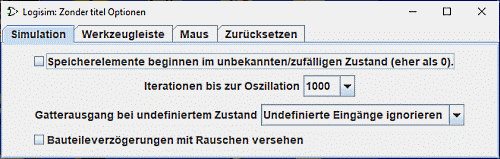
GPU_TEST_AUDIO/logisim-evolution/src/main/resources/doc/de/img-guide/opts-simulate.png
