nockieboy/gpu/GPU_TEST_AUDIO/logisim-evolution/src/main/resources/doc/de/img-guide/prop-oscillate-error.png

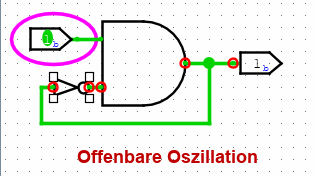
GPU_TEST_AUDIO/logisim-evolution/src/main/resources/doc/de/img-guide/prop-oscillate-error.png
