nockieboy/gpu/GPU_TEST_AUDIO/logisim-evolution/src/main/resources/doc/el/img-guide/gui-4-and-narrow.png

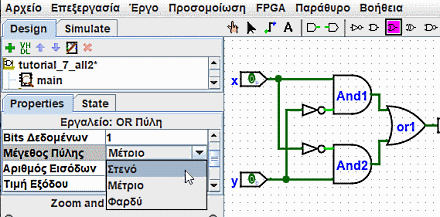
GPU_TEST_AUDIO/logisim-evolution/src/main/resources/doc/el/img-guide/gui-4-and-narrow.png
