nockieboy/gpu/GPU_TEST_AUDIO/logisim-evolution/src/main/resources/doc/el/img-guide/hdl-ip-questa.png

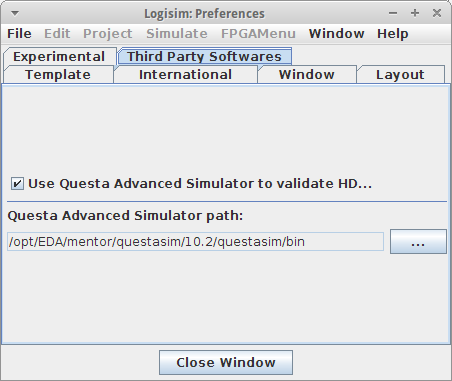
GPU_TEST_AUDIO/logisim-evolution/src/main/resources/doc/el/img-guide/hdl-ip-questa.png
