nockieboy/gpu/GPU_TEST_AUDIO/logisim-evolution/src/main/resources/doc/el/img-guide/prefs-intl.png

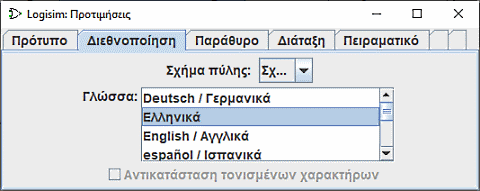
GPU_TEST_AUDIO/logisim-evolution/src/main/resources/doc/el/img-guide/prefs-intl.png
