nockieboy/gpu/GPU_TEST_AUDIO/logisim-evolution/src/main/resources/doc/el/img-guide/subcirc-2-done.png

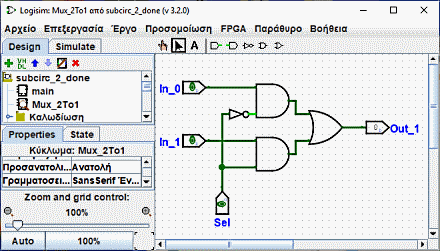
GPU_TEST_AUDIO/logisim-evolution/src/main/resources/doc/el/img-guide/subcirc-2-done.png
