nockieboy/gpu/GPU_TEST_AUDIO/logisim-evolution/src/main/resources/doc/el/img-guide/subcirc-3-add.png

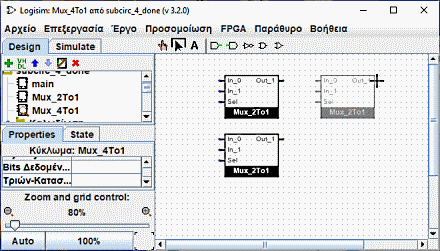
GPU_TEST_AUDIO/logisim-evolution/src/main/resources/doc/el/img-guide/subcirc-3-add.png
