nockieboy/gpu/GPU_TEST_AUDIO/logisim-evolution/src/main/resources/doc/el/img-guide/subcirc-7-custom-layout.png

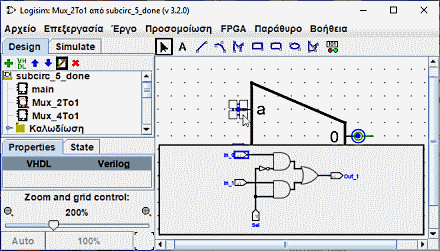
GPU_TEST_AUDIO/logisim-evolution/src/main/resources/doc/el/img-guide/subcirc-7-custom-layout.png
