nockieboy/gpu/GPU_TEST_AUDIO/logisim-evolution/src/main/resources/doc/el/img-guide/tutorial-3-comps.png

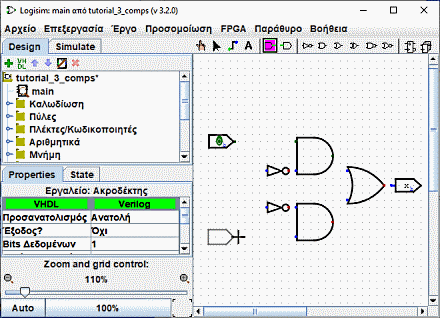
GPU_TEST_AUDIO/logisim-evolution/src/main/resources/doc/el/img-guide/tutorial-3-comps.png
