nockieboy/gpu/GPU_TEST_AUDIO/logisim-evolution/src/main/resources/doc/el/img-guide/tutorial-7-all2.png

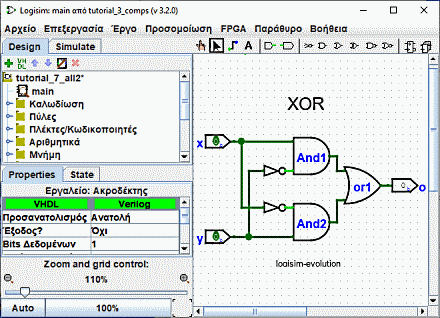
GPU_TEST_AUDIO/logisim-evolution/src/main/resources/doc/el/img-guide/tutorial-7-all2.png
