nockieboy/gpu/GPU_TEST_AUDIO/logisim-evolution/src/main/resources/doc/en/img-guide/analyze-minimized.png

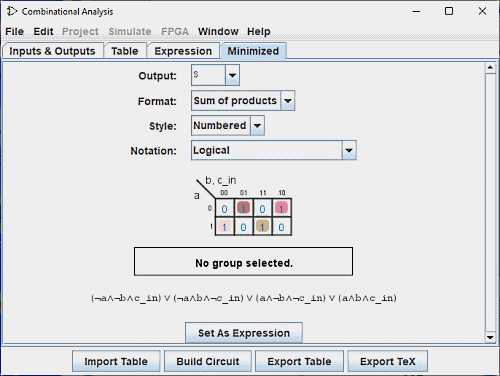
GPU_TEST_AUDIO/logisim-evolution/src/main/resources/doc/en/img-guide/analyze-minimized.png
