nockieboy/gpu/GPU_TEST_AUDIO/logisim-evolution/src/main/resources/doc/en/img-guide/hdl-ip-sim-log.png

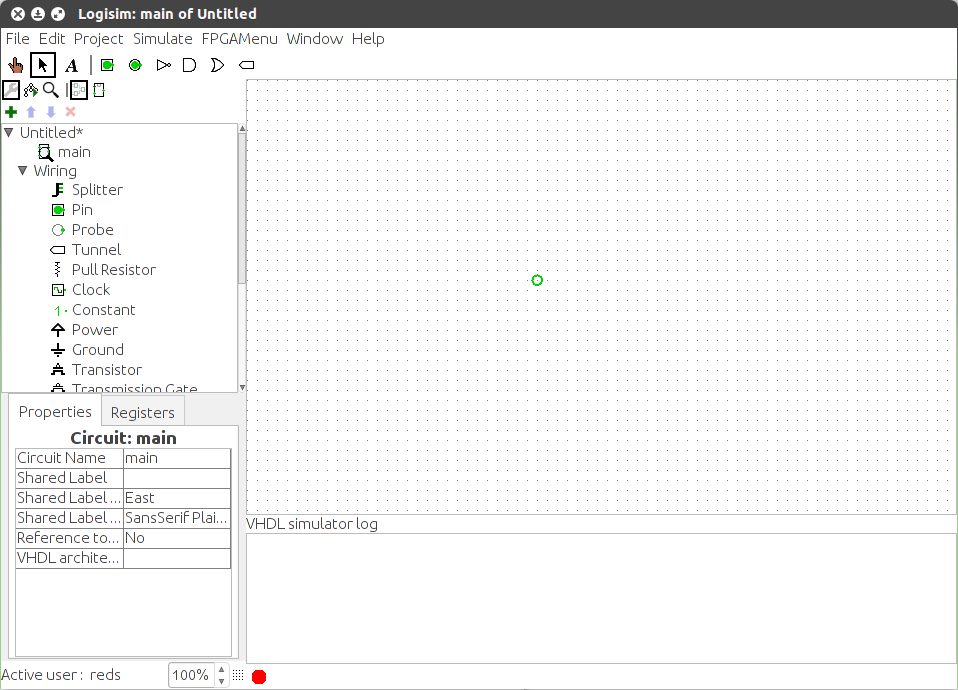
GPU_TEST_AUDIO/logisim-evolution/src/main/resources/doc/en/img-guide/hdl-ip-sim-log.png
