nockieboy/gpu/GPU_TEST_AUDIO/logisim-evolution/src/main/resources/doc/en/img-guide/menu-3-exporttab.png

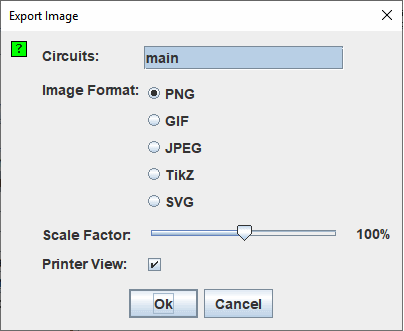
GPU_TEST_AUDIO/logisim-evolution/src/main/resources/doc/en/img-guide/menu-3-exporttab.png
