nockieboy/gpu/GPU_TEST_AUDIO/logisim-evolution/src/main/resources/doc/en/img-guide/opts-toolbar.png

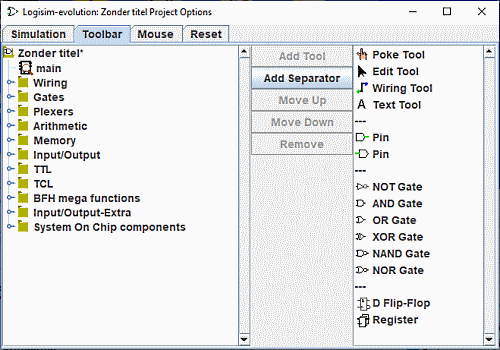
GPU_TEST_AUDIO/logisim-evolution/src/main/resources/doc/en/img-guide/opts-toolbar.png
