nockieboy/gpu/GPU_TEST_AUDIO/logisim-evolution/src/main/resources/doc/en/img-guide/prefs-layout.png

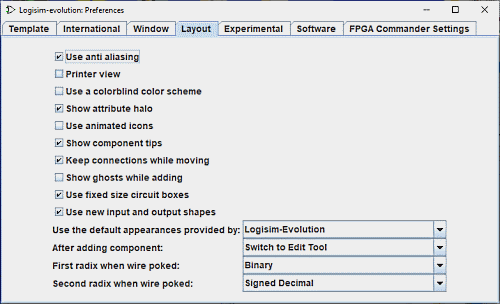
GPU_TEST_AUDIO/logisim-evolution/src/main/resources/doc/en/img-guide/prefs-layout.png
