nockieboy/gpu/GPU_TEST_AUDIO/logisim-evolution/src/main/resources/doc/en/img-guide/prop-oscillate-error.png

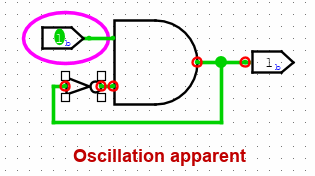
GPU_TEST_AUDIO/logisim-evolution/src/main/resources/doc/en/img-guide/prop-oscillate-error.png
