nockieboy/gpu/GPU_TEST_AUDIO/logisim-evolution/src/main/resources/doc/en/img-guide/subcirc-6-custom-layout.png

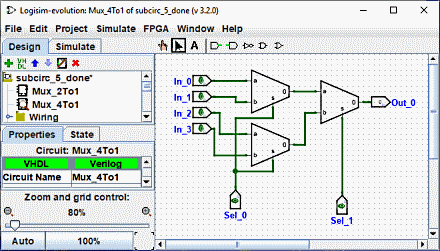
GPU_TEST_AUDIO/logisim-evolution/src/main/resources/doc/en/img-guide/subcirc-6-custom-layout.png
