nockieboy/gpu/GPU_TEST_AUDIO/logisim-evolution/src/main/resources/doc/en/img-guide/tutorial-1-ands.png

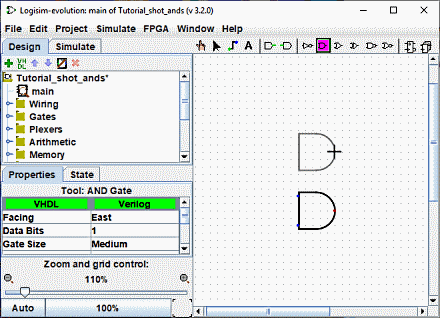
GPU_TEST_AUDIO/logisim-evolution/src/main/resources/doc/en/img-guide/tutorial-1-ands.png
