nockieboy/gpu/GPU_TEST_AUDIO/logisim-evolution/src/main/resources/doc/en/img-guide/tutorial-4-wires.png

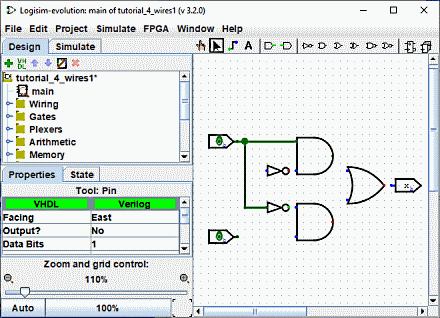
GPU_TEST_AUDIO/logisim-evolution/src/main/resources/doc/en/img-guide/tutorial-4-wires.png
