nockieboy/gpu/GPU_TEST_AUDIO/logisim-evolution/src/main/resources/doc/en/img-guide/tutorial-6-all.png

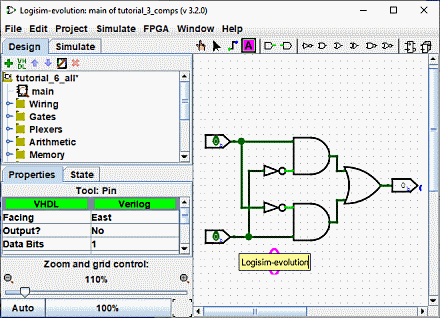
GPU_TEST_AUDIO/logisim-evolution/src/main/resources/doc/en/img-guide/tutorial-6-all.png
