nockieboy/gpu/GPU_TEST_AUDIO/logisim-evolution/src/main/resources/doc/en/img-guide/tutorial-shot-labeled.png

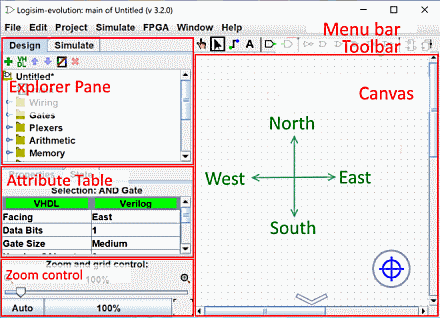
GPU_TEST_AUDIO/logisim-evolution/src/main/resources/doc/en/img-guide/tutorial-shot-labeled.png
