nockieboy/gpu/GPU_TEST_AUDIO/logisim-evolution/src/main/resources/doc/es/img-guide/gui-3-pin-attrib.png

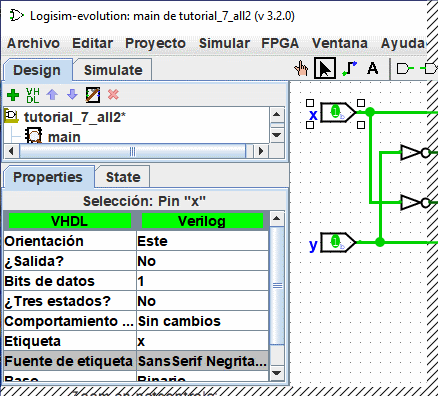
GPU_TEST_AUDIO/logisim-evolution/src/main/resources/doc/es/img-guide/gui-3-pin-attrib.png
