nockieboy/gpu/GPU_TEST_AUDIO/logisim-evolution/src/main/resources/doc/es/img-guide/opts-mouse.png

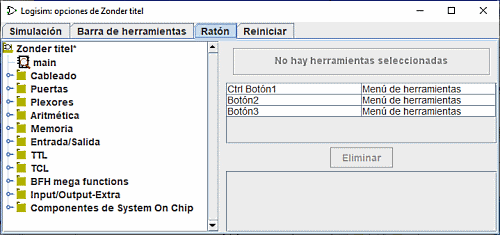
GPU_TEST_AUDIO/logisim-evolution/src/main/resources/doc/es/img-guide/opts-mouse.png
