nockieboy/gpu/GPU_TEST_AUDIO/logisim-evolution/src/main/resources/doc/es/img-guide/prop-oscillate-before.png

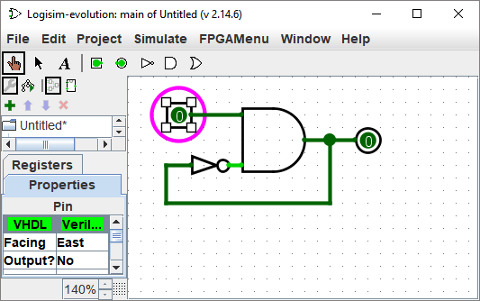
GPU_TEST_AUDIO/logisim-evolution/src/main/resources/doc/es/img-guide/prop-oscillate-before.png
