nockieboy/gpu/GPU_TEST_AUDIO/logisim-evolution/src/main/resources/doc/es/img-guide/subcirc-8-delve.png

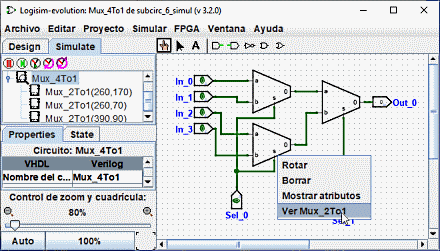
GPU_TEST_AUDIO/logisim-evolution/src/main/resources/doc/es/img-guide/subcirc-8-delve.png
