nockieboy/gpu/GPU_TEST_AUDIO/logisim-evolution/src/main/resources/doc/fr/img-guide/analyze-inout.png

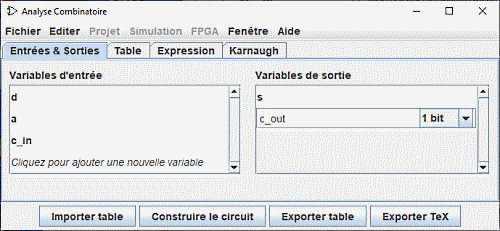
GPU_TEST_AUDIO/logisim-evolution/src/main/resources/doc/fr/img-guide/analyze-inout.png
