nockieboy/gpu/GPU_TEST_AUDIO/logisim-evolution/src/main/resources/doc/fr/img-guide/gui-1-nand-select.png

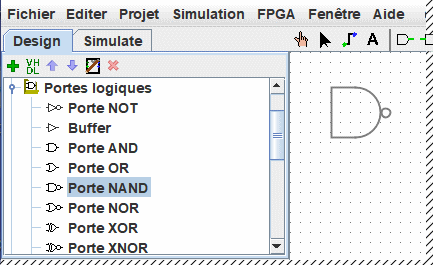
GPU_TEST_AUDIO/logisim-evolution/src/main/resources/doc/fr/img-guide/gui-1-nand-select.png
