nockieboy/gpu/GPU_TEST_AUDIO/logisim-evolution/src/main/resources/doc/fr/img-guide/gui-3-pin-attrib.png

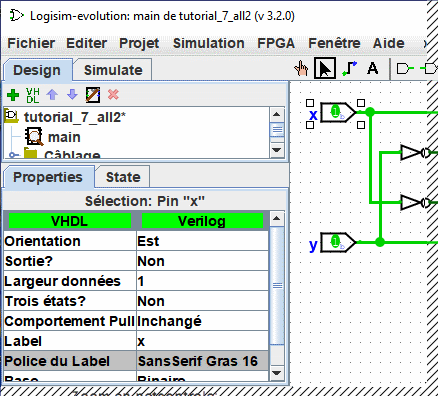
GPU_TEST_AUDIO/logisim-evolution/src/main/resources/doc/fr/img-guide/gui-3-pin-attrib.png
