nockieboy/gpu/GPU_TEST_AUDIO/logisim-evolution/src/main/resources/doc/fr/img-guide/hdl-ip-editor.png

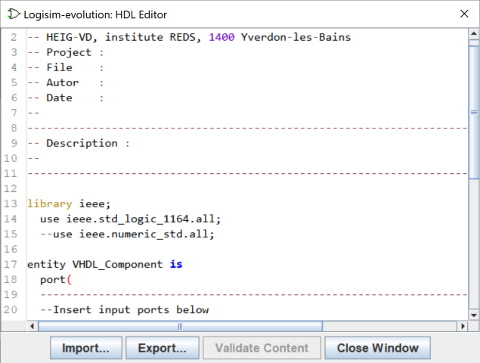
GPU_TEST_AUDIO/logisim-evolution/src/main/resources/doc/fr/img-guide/hdl-ip-editor.png
