nockieboy/gpu/GPU_TEST_AUDIO/logisim-evolution/src/main/resources/doc/fr/img-guide/mem-filepanel.png

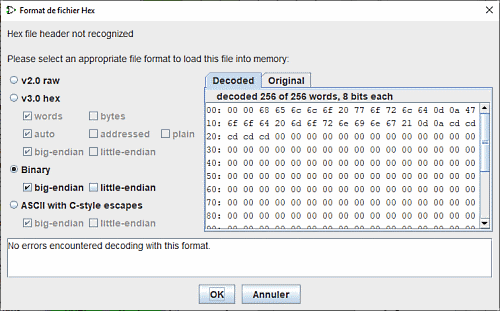
GPU_TEST_AUDIO/logisim-evolution/src/main/resources/doc/fr/img-guide/mem-filepanel.png
