nockieboy/gpu/GPU_TEST_AUDIO/logisim-evolution/src/main/resources/doc/fr/img-guide/opts-simulate.png

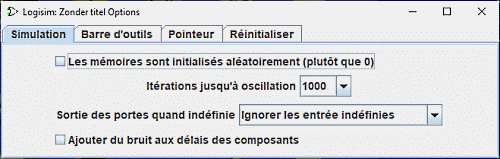
GPU_TEST_AUDIO/logisim-evolution/src/main/resources/doc/fr/img-guide/opts-simulate.png
