nockieboy/gpu/GPU_TEST_AUDIO/logisim-evolution/src/main/resources/doc/fr/img-guide/project-stat.png

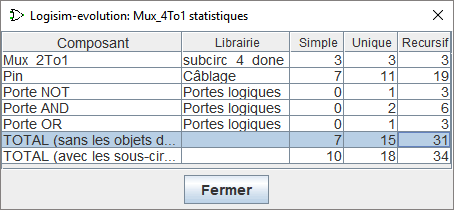
GPU_TEST_AUDIO/logisim-evolution/src/main/resources/doc/fr/img-guide/project-stat.png
