nockieboy/gpu/GPU_TEST_AUDIO/logisim-evolution/src/main/resources/doc/fr/img-guide/subcirc-1-add.png

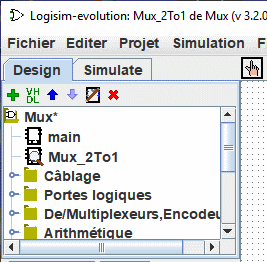
GPU_TEST_AUDIO/logisim-evolution/src/main/resources/doc/fr/img-guide/subcirc-1-add.png
