nockieboy/gpu/GPU_TEST_AUDIO/logisim-evolution/src/main/resources/doc/fr/img-guide/subcirc-5-custom-appear.png

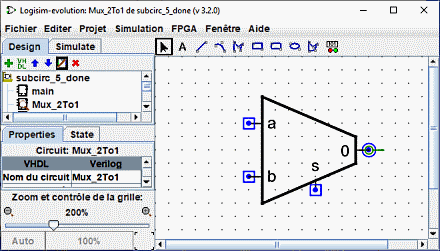
GPU_TEST_AUDIO/logisim-evolution/src/main/resources/doc/fr/img-guide/subcirc-5-custom-appear.png
