nockieboy/gpu/GPU_TEST_AUDIO/logisim-evolution/src/main/resources/doc/fr/img-guide/tutorial-1-ands.png

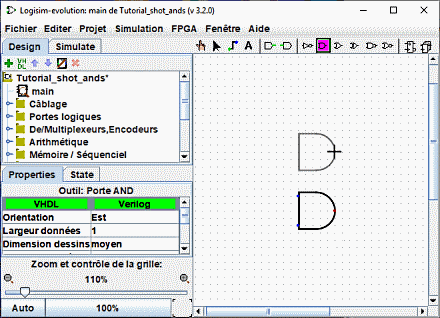
GPU_TEST_AUDIO/logisim-evolution/src/main/resources/doc/fr/img-guide/tutorial-1-ands.png
