nockieboy/gpu/GPU_TEST_AUDIO/logisim-evolution/src/main/resources/doc/fr/img-guide/tutorial-xor-circ.png

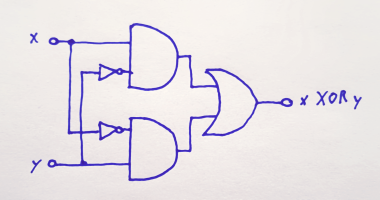
GPU_TEST_AUDIO/logisim-evolution/src/main/resources/doc/fr/img-guide/tutorial-xor-circ.png
