nockieboy/gpu/GPU_TEST_AUDIO/logisim-evolution/src/main/resources/doc/img-guide/analyze-numline2.png

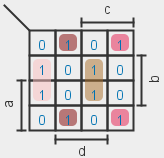
GPU_TEST_AUDIO/logisim-evolution/src/main/resources/doc/img-guide/analyze-numline2.png
