nockieboy/gpu/GPU_TEST_AUDIO/logisim-evolution/src/main/resources/doc/img-guide/bundles-splitter-circ.png

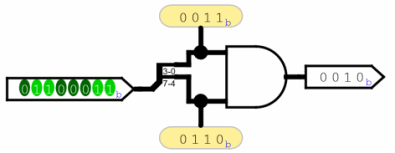
GPU_TEST_AUDIO/logisim-evolution/src/main/resources/doc/img-guide/bundles-splitter-circ.png
