nockieboy/gpu/GPU_TEST_AUDIO/logisim-evolution/src/main/resources/doc/img-guide/cables.png

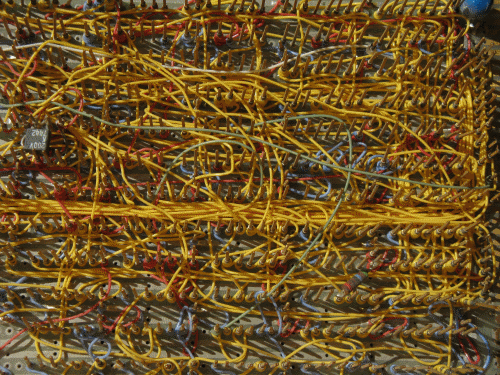
GPU_TEST_AUDIO/logisim-evolution/src/main/resources/doc/img-guide/cables.png
