nockieboy/gpu/GPU_TEST_AUDIO/logisim-evolution/src/main/resources/doc/img-guide/hdl-ip-tb.png

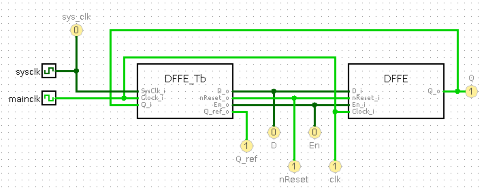
GPU_TEST_AUDIO/logisim-evolution/src/main/resources/doc/img-guide/hdl-ip-tb.png
