nockieboy/gpu/GPU_TEST_AUDIO/logisim-evolution/src/main/resources/doc/img-guide/membyteplainbe.png

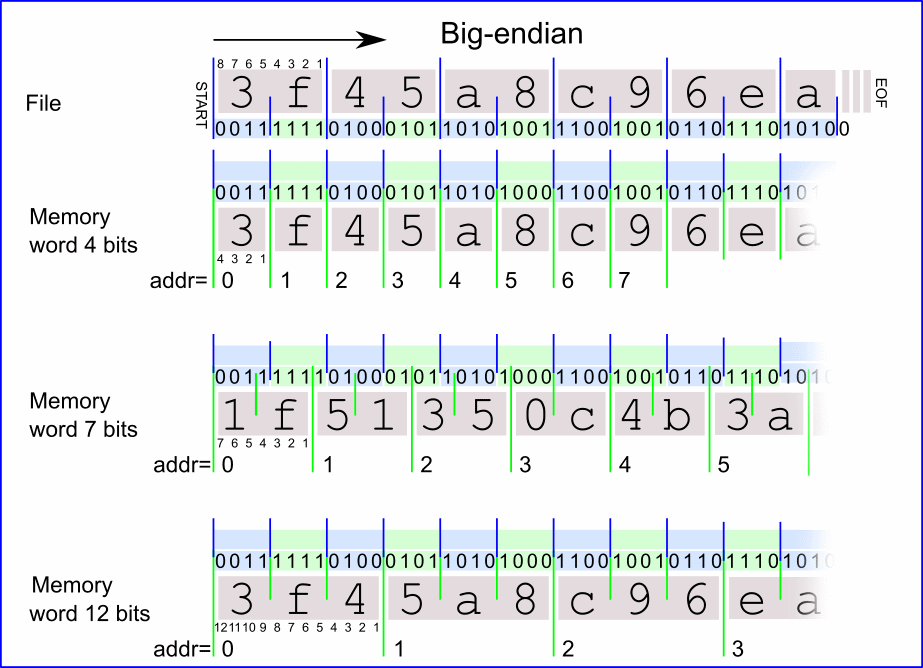
GPU_TEST_AUDIO/logisim-evolution/src/main/resources/doc/img-guide/membyteplainbe.png
