nockieboy/gpu/GPU_TEST_AUDIO/logisim-evolution/src/main/resources/doc/img-guide/memory.png

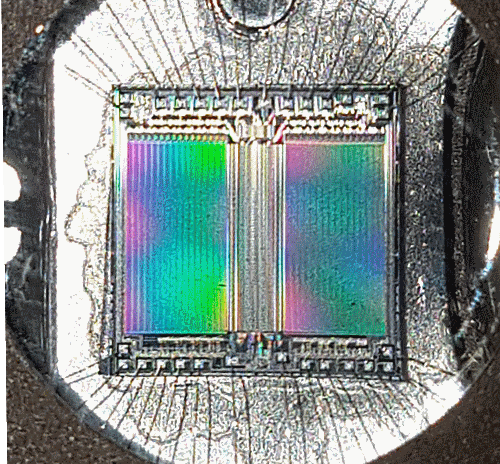
GPU_TEST_AUDIO/logisim-evolution/src/main/resources/doc/img-guide/memory.png
