nockieboy/gpu/GPU_TEST_AUDIO/logisim-evolution/src/main/resources/doc/img-guide/memraw1.png

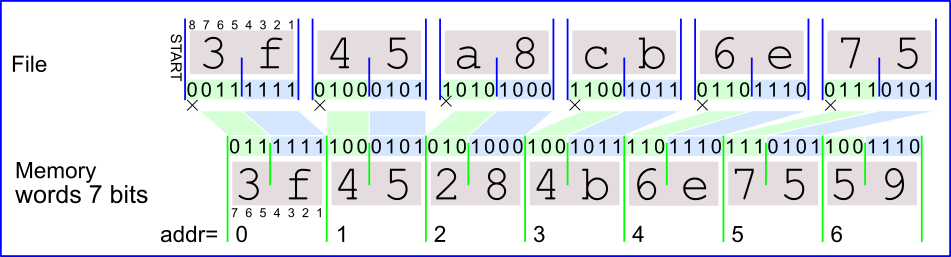
GPU_TEST_AUDIO/logisim-evolution/src/main/resources/doc/img-guide/memraw1.png
