nockieboy/gpu/GPU_TEST_AUDIO/logisim-evolution/src/main/resources/doc/img-guide/pokememadr.png

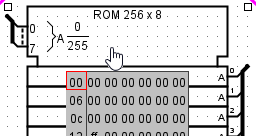
GPU_TEST_AUDIO/logisim-evolution/src/main/resources/doc/img-guide/pokememadr.png
