nockieboy/gpu/GPU_TEST_AUDIO/logisim-evolution/src/main/resources/doc/img-guide/subcirc-delve.png

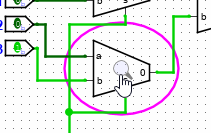
GPU_TEST_AUDIO/logisim-evolution/src/main/resources/doc/img-guide/subcirc-delve.png
