nockieboy/gpu/GPU_TEST_AUDIO/logisim-evolution/src/main/resources/doc/img-guide/subcirc-hierarchy.png

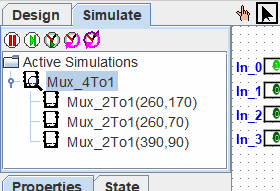
GPU_TEST_AUDIO/logisim-evolution/src/main/resources/doc/img-guide/subcirc-hierarchy.png
