nockieboy/gpu/GPU_TEST_AUDIO/logisim-evolution/src/main/resources/doc/img-guide/subcirc.png

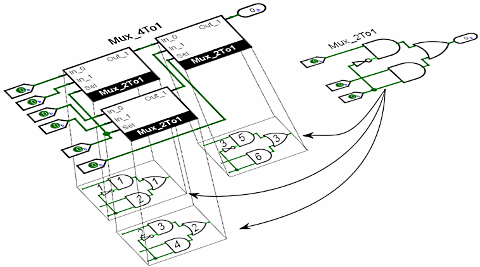
GPU_TEST_AUDIO/logisim-evolution/src/main/resources/doc/img-guide/subcirc.png
