nockieboy/gpu/GPU_TEST_AUDIO/logisim-evolution/src/main/resources/doc/img-guide/tutorial-step3.gif

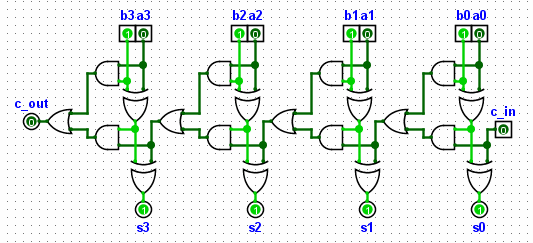
GPU_TEST_AUDIO/logisim-evolution/src/main/resources/doc/img-guide/tutorial-step3.gif
