nockieboy/gpu/GPU_TEST_AUDIO/logisim-evolution/src/main/resources/doc/it/img-guide/analyze-inout.png

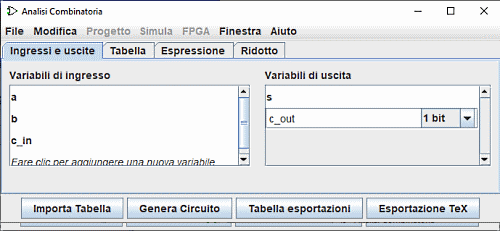
GPU_TEST_AUDIO/logisim-evolution/src/main/resources/doc/it/img-guide/analyze-inout.png
