nockieboy/gpu/GPU_TEST_AUDIO/logisim-evolution/src/main/resources/doc/it/img-guide/gui-2-remlib.png

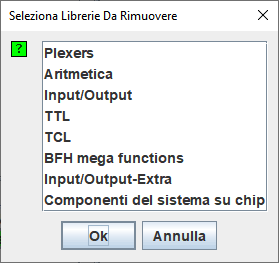
GPU_TEST_AUDIO/logisim-evolution/src/main/resources/doc/it/img-guide/gui-2-remlib.png
