nockieboy/gpu/GPU_TEST_AUDIO/logisim-evolution/src/main/resources/doc/it/img-guide/tutorial-5-wires2.png

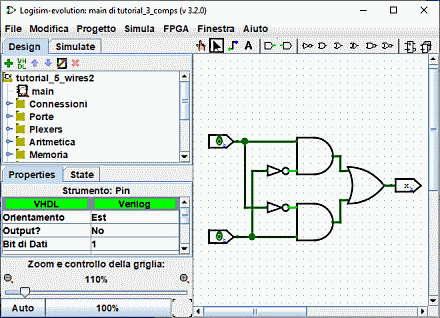
GPU_TEST_AUDIO/logisim-evolution/src/main/resources/doc/it/img-guide/tutorial-5-wires2.png
