nockieboy/gpu/GPU_TEST_AUDIO/logisim-evolution/src/main/resources/doc/nl/img-guide/analyze-inout.png

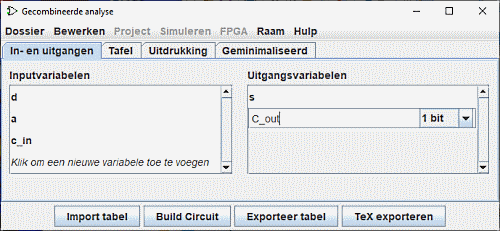
GPU_TEST_AUDIO/logisim-evolution/src/main/resources/doc/nl/img-guide/analyze-inout.png
