nockieboy/gpu/GPU_TEST_AUDIO/logisim-evolution/src/main/resources/doc/nl/img-guide/feature-3-bundles-error.png

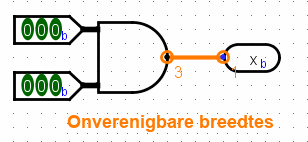
GPU_TEST_AUDIO/logisim-evolution/src/main/resources/doc/nl/img-guide/feature-3-bundles-error.png
