nockieboy/gpu/GPU_TEST_AUDIO/logisim-evolution/src/main/resources/doc/nl/img-guide/gui-5-and-replace.png

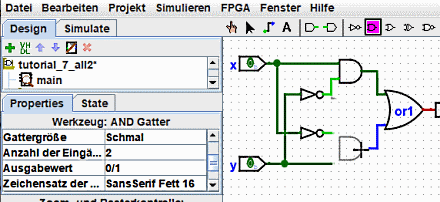
GPU_TEST_AUDIO/logisim-evolution/src/main/resources/doc/nl/img-guide/gui-5-and-replace.png
