nockieboy/gpu/GPU_TEST_AUDIO/logisim-evolution/src/main/resources/doc/nl/img-guide/prop-oscillate-error.png

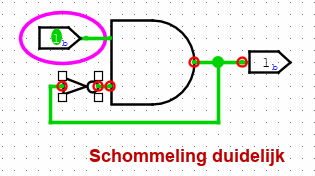
GPU_TEST_AUDIO/logisim-evolution/src/main/resources/doc/nl/img-guide/prop-oscillate-error.png
