nockieboy/gpu/GPU_TEST_AUDIO/logisim-evolution/src/main/resources/doc/nl/img-guide/subcirc-4-done.png

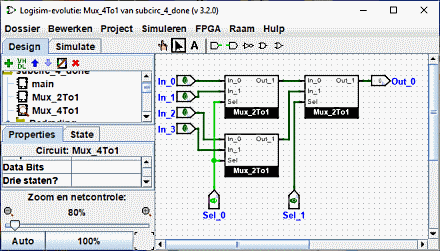
GPU_TEST_AUDIO/logisim-evolution/src/main/resources/doc/nl/img-guide/subcirc-4-done.png
