nockieboy/gpu/GPU_TEST_AUDIO/logisim-evolution/src/main/resources/doc/nl/img-guide/tutorial-shot-labeled.png

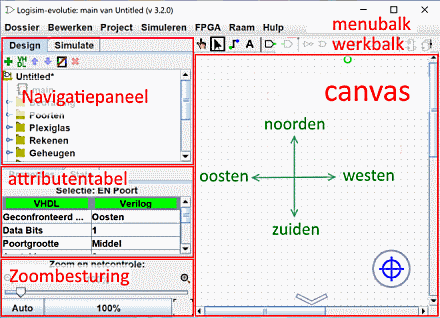
GPU_TEST_AUDIO/logisim-evolution/src/main/resources/doc/nl/img-guide/tutorial-shot-labeled.png
