nockieboy/gpu/GPU_TEST_AUDIO/logisim-evolution/src/main/resources/doc/pt/img-guide/mem-hex.png

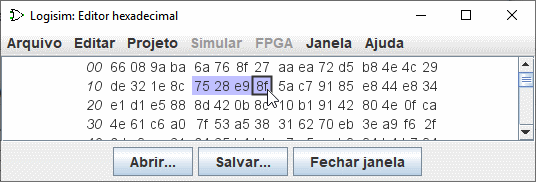
GPU_TEST_AUDIO/logisim-evolution/src/main/resources/doc/pt/img-guide/mem-hex.png
