nockieboy/gpu/GPU_TEST_AUDIO/logisim-evolution/src/main/resources/doc/pt/img-guide/menu-4-printertab.png

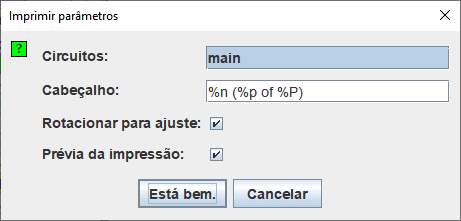
GPU_TEST_AUDIO/logisim-evolution/src/main/resources/doc/pt/img-guide/menu-4-printertab.png
