nockieboy/gpu/GPU_TEST_AUDIO/logisim-evolution/src/main/resources/doc/pt/img-guide/tutorial-2-gates.png

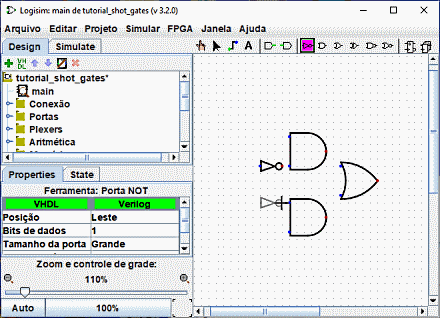
GPU_TEST_AUDIO/logisim-evolution/src/main/resources/doc/pt/img-guide/tutorial-2-gates.png
