nockieboy/gpu/GPU_TEST_AUDIO/logisim-evolution/src/main/resources/doc/ru/img-guide/analyze-build.png

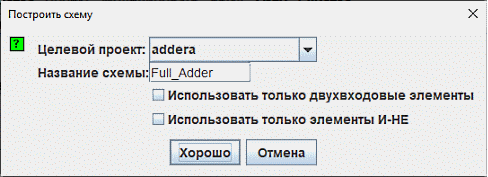
GPU_TEST_AUDIO/logisim-evolution/src/main/resources/doc/ru/img-guide/analyze-build.png
