nockieboy/gpu/GPU_TEST_AUDIO/logisim-evolution/src/main/resources/doc/ru/img-guide/subcirc-1-add.png

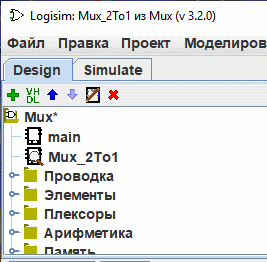
GPU_TEST_AUDIO/logisim-evolution/src/main/resources/doc/ru/img-guide/subcirc-1-add.png
