nockieboy/gpu/GPU_TEST_AUDIO/logisim-evolution/src/main/resources/doc/ru/img-guide/subcirc-5-custom-appear.png

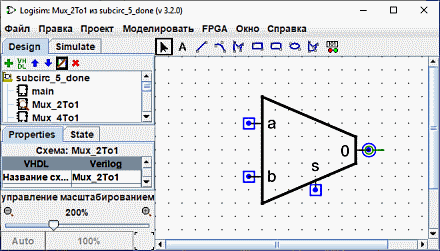
GPU_TEST_AUDIO/logisim-evolution/src/main/resources/doc/ru/img-guide/subcirc-5-custom-appear.png
