nockieboy/gpu/GPU_TEST_AUDIO/logisim-evolution/src/main/resources/doc/ru/img-guide/tutorial-0-blank.png

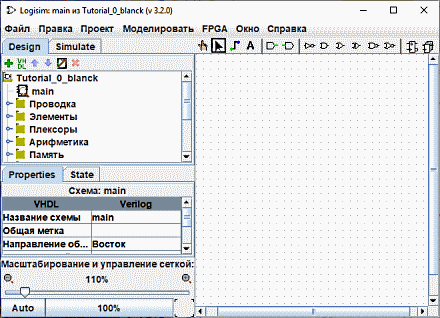
GPU_TEST_AUDIO/logisim-evolution/src/main/resources/doc/ru/img-guide/tutorial-0-blank.png
