nockieboy/gpu/test/HDMI_MAX10_DEMO/HDMI_TX.htm

# DECA MAX10 Board Configuration

## Pin Assignments:

- CLOCK
- KEY
- LED
- CapSense Button
- Audio
- Flash
- G-Sensor
- HDMI-TX
- Light Sensor
- Ethernet
- Power Monitor
- Humidity and Temperature Sensor
- MicroSD Card
- SW
- Board Temperature Sensor
- USB

## Pin Assignment Table:

CLOCK
Name | Location | Direction | Standard
ADC_CLK_10 | M9 | input | 2.5 V
MAX10_CLK1_50 | M8 | input | 2.5 V
MAX10_CLK2_50 | P11 | input | 3.3-V LVTTL

KEY
Name | Location | Direction | Standard
KEY[0] | H21 | input | 1.5 V Schmitt Trigger
KEY[1] | H22 | input | 1.5 V Schmitt Trigger

LED
Name | Location | Direction | Standard
LED[0] | C7 | output | 1.2 V
LED[1] | C8 | output | 1.2 V
LED[2] | A6 | output | 1.2 V
LED[3] | B7 | output | 1.2 V
LED[4] | C4 | output | 1.2 V
LED[5] | A5 | output | 1.2 V
LED[6] | B4 | output | 1.2 V
LED[7] | C5 | output | 1.2 V

CapSense Button
Name | Location | Direction | Standard
CAP_SENSE_I2C_SCL | AB2 | inout | 3.3-V LVTTL
CAP_SENSE_I2C_SDA | AB3 | inout | 3.3-V LVTTL

Audio
Name | Location | Direction | Standard
AUDIO_BCLK | R14 | inout | 1.5 V
AUDIO_DIN_MFP1 | P15 | output | 1.5 V
AUDIO_DOUT_MFP2 | P18 | input | 1.5 V
AUDIO_GPIO_MFP5 | M22 | inout | 1.5 V
AUDIO_MCLK | P14 | output | 1.5 V
AUDIO_MISO_MFP4 | N21 | input | 1.5 V
AUDIO_RESET_n | M21 | inout | 1.5 V
AUDIO_SCLK_MFP3 | P19 | output | 1.5 V
AUDIO_SCL_SS_n | P20 | output | 1.5 V
AUDIO_SDA_MOSI | P21 | output | 1.5 V
AUDIO_SPI_SELECT | N22 | output | 1.5 V
AUDIO_WCLK | R15 | inout | 1.5 V

Flash
Name | Location | Direction | Standard
FLASH_DATA[0] | P12 | inout | 3.3-V LVTTL
FLASH_DATA[1] | V4 | inout | 3.3-V LVTTL
FLASH_DATA[2] | V5 | inout | 3.3-V LVTTL
FLASH_DATA[3] | P10 | inout | 3.3-V LVTTL
FLASH_DCLK | R12 | output | 3.3-V LVTTL
FLASH_NCSO | R10 | output | 3.3-V LVTTL
FLASH_RESET_n | W10 | output | 3.3-V LVTTL

G-Sensor
Name | Location | Direction | Standard
GSENSOR_PD | AB5 | output | 3.3-V LVTTL
GSENSOR_ST | AA5 | output | 3.3-V LVTTL

HDMI-TX
Name | Location | Direction | Standard
HDMI_I2C_SCL | C10 | inout | 1.8 V
HDMI_I2C_SDA | B15 | inout | 1.8 V
HDMI_I2S[0] | A9 | inout | 1.8 V
HDMI_I2S[1] | A11 | inout | 1.8 V
HDMI_I2S[2] | A8 | inout | 1.8 V
HDMI_I2S[3] | B8 | inout | 1.8 V
HDMI_LRCLK | A10 | inout | 1.8 V
HDMI_MCLK | A7 | inout | 1.8 V
HDMI_SCLK | D12 | inout | 1.8 V
HDMI_TX_CLK | D6 | output | 1.2 V
HDMI_TX_D[0] | C18 | output | 1.8 V
HDMI_TX_D[1] | D17 | output | 1.8 V
HDMI_TX_D[2] | C17 | output | 1.8 V
HDMI_TX_D[3] | C19 | output | 1.8 V
HDMI_TX_D[4] | D14 | output | 1.8 V
HDMI_TX_D[5] | B19 | output | 1.8 V
HDMI_TX_D[6] | D13 | output | 1.8 V
HDMI_TX_D[7] | A19 | output | 1.8 V
HDMI_TX_D[8] | C14 | output | 1.8 V
HDMI_TX_D[9] | A17 | output | 1.8 V
HDMI_TX_D[10] | B16 | output | 1.8 V
HDMI_TX_D[11] | C15 | output | 1.8 V
HDMI_TX_D[12] | A14 | output | 1.8 V
HDMI_TX_D[13] | A15 | output | 1.8 V
HDMI_TX_D[14] | A12 | output | 1.8 V
HDMI_TX_D[15] | A16 | output | 1.8 V
HDMI_TX_D[16] | A13 | output | 1.8 V
HDMI_TX_D[17] | C16 | output | 1.8 V
HDMI_TX_D[18] | C12 | output | 1.8 V
HDMI_TX_D[19] | B17 | output | 1.8 V
HDMI_TX_D[20] | B12 | output | 1.8 V
HDMI_TX_D[21] | B14 | output | 1.8 V
HDMI_TX_D[22] | A18 | output | 1.8 V
HDMI_TX_D[23] | C13 | output | 1.8 V
HDMI_TX_DE | C9 | output | 1.8 V
HDMI_TX_HS | B11 | output | 1.8 V
HDMI_TX_INT | B10 | input | 1.8 V
HDMI_TX_VS | C11 | output | 1.8 V

Light Sensor
Name | Location | Direction | Standard
LIGHT_I2C_SCL | Y8 | output | 3.3-V LVTTL
LIGHT_I2C_SDA | AA8 | inout | 3.3-V LVTTL
LIGHT_INT | AA9 | inout | 3.3-V LVTTL

Ethernet
Name | Location | Direction | Standard
NET_COL | R4 | input | 2.5 V
NET_CRS | P5 | input | 2.5 V
NET_MDC | R5 | output | 2.5 V
NET_MDIO | N8 | inout | 2.5 V
NET_PCF_EN | V9 | output | 3.3-V LVTTL
NET_RESET_n | R3 | output | 2.5 V
NET_RXD[0] | P8 | input | 2.5 V
NET_RXD[1] | R7 | input | 2.5 V
NET_RXD[2] | U4 | input | 2.5 V
NET_RXD[3] | U5 | input | 2.5 V
NET_RX_CLK | T6 | output | 2.5 V
NET_RX_DV | P4 | input | 2.5 V
NET_RX_ER | V1 | input | 2.5 V
NET_TXD[0] | U2 | output | 2.5 V
NET_TXD[1] | W1 | output | 2.5 V
NET_TXD[2] | N9 | output | 2.5 V
NET_TXD[3] | W2 | output | 2.5 V
NET_TX_CLK | T5 | input | 2.5 V
NET_TX_EN | P3 | output | 2.5 V

Power Monitor
Name | Location | Direction | Standard
PMONITOR_ALERT | Y4 | input | 3.3-V LVTTL
PMONITOR_I2C_SCL | Y3 | output | 3.3-V LVTTL
PMONITOR_I2C_SDA | Y1 | inout | 3.3-V LVTTL

Humidity and Temperature Sensor
Name | Location | Direction | Standard
RH_TEMP_DRDY_n | AB9 | input | 3.3-V LVTTL
RH_TEMP_I2C_SCL | Y10 | output | 3.3-V LVTTL
RH_TEMP_I2C_SDA | AA10 | inout | 3.3-V LVTTL

MicroSD Card
Name | Location | Direction | Standard
SD_CLK | T20 | output | 1.5 V
SD_CMD | T21 | inout | 1.5 V
SD_CMD_DIR | U22 | output | 1.5 V
SD_D0_DIR | T22 | output | 1.5 V
SD_D123_DIR | U21 | inout | 1.5 V
SD_DAT[0] | R18 | inout | 1.5 V
SD_DAT[1] | T18 | inout | 1.5 V
SD_DAT[2] | T19 | inout | 1.5 V
SD_DAT[3] | R20 | inout | 1.5 V
SD_FB_CLK | R22 | input | 1.5 V
SD_SEL | P13 | output | 3.3-V LVTTL

SW
Name | Location | Direction | Standard
SW[0] | J21 | input | 1.5 V Schmitt Trigger
SW[1] | J22 | input | 1.5 V Schmitt Trigger

Board Temperature Sensor
Name | Location | Direction | Standard
TEMP_CS_n | AB4 | output | 3.3-V LVTTL
TEMP_SC | AA1 | output | 3.3-V LVTTL
TEMP_SIO | Y2 | inout | 3.3-V LVTTL

USB
Name | Location | Direction | Standard
USB_CLKIN | H11 | input | 1.2 V
USB_CS | J11 | output | 1.8 V
USB_DATA[0] | E12 | inout | 1.8 V
USB_DATA[1] | E13 | inout | 1.8 V
USB_DATA[2] | H13 | inout | 1.8 V
USB_DATA[3] | E14 | inout | 1.8 V
USB_DATA[4] | H14 | inout | 1.8 V
USB_DATA[5] | D15 | inout | 1.8 V
USB_DATA[6] | E15 | inout | 1.8 V
USB_DATA[7] | F15 | inout | 1.8 V
USB_DIR | J13 | input | 1.8 V
USB_FAULT_n | D8 | input | 1.2 V
USB_NXT | H12 | input | 1.8 V
USB_RESET_n | E16 | output | 1.8 V
USB_STP | J12 | output | 1.8 V
