nockieboy/gpu/test/Data_mux_geo/lpm_ram_dp0_waveforms.html

## Sample behavioral waveforms for design file "lpm_ram_dp0.tdf"

The following waveforms show the behavior of altsyncram megafunction for the chosen set of parameters in design "lpm_ram_dp0.tdf". For the purpose of this simulation, the contents of the memory at the start of the sample waveforms is assumed to be ( FFF0, FFF1, FFF2, FFF3, ...). The design "lpm_ram_dp0.tdf" has

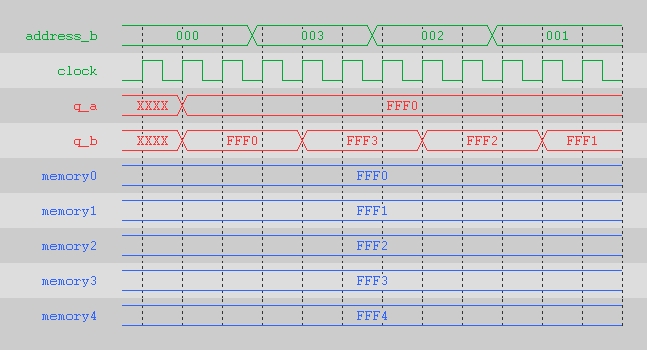
[picture p187: test/Data_mux_geo/lpm_ram_dp0_wave0.jpg]


Fig. 1 : Wave showing read operation.

The above waveform shows the behavior of the design under normal read conditions. The read happens at the rising edge of the enabled clock cycle. The output from the RAM is undefined until after the first rising edge of the read clock. The clock enable on the output registers are disabled.
