nockieboy/gpu/test/GPU_GEOMETRY_Testbench/GEO_tb_command_results.txt

Log file requested in 'GEO_tb_Blitter.txt' at line#  85.

Line#  86, Wait Idle ON. .
Line#  89, Clear GEOFF bitmap to color   0.
Line#  92, Sending a reset to the entire system.
Line#  93, PIXIE Enabled. .
Line# 101, LOAD_GPU_RAM font_vga_8x16.bin.
Line# 102, SET_PAGET Srce addr(h00000000) width(    8) depth( 1)
           TX CMD > $e000  =  (224) - (  0) = (11100000 00000000).
           TX CMD > $a000  =  (160) - (  0) = (10100000 00000000).
           TX CMD > $f000  =  (240) - (  0) = (11110000 00000000).
           TX CMD > $b008  =  (176) - (  8) = (10110000 00001000).
           TX CMD > $7a00  =  (122) - (  0) = (01111010 00000000).
           TX CMD > $7000  =  (112) - (  0) = (01110000 00000000).

Line# 105, SET_PAGET Dest addr(h00005000) width(  680) depth( 8)
           TX CMD > $e000  =  (224) - (  0) = (11100000 00000000).
           TX CMD > $a050  =  (160) - ( 80) = (10100000 01010000).
           TX CMD > $f000  =  (240) - (  0) = (11110000 00000000).
           TX CMD > $b2a8  =  (178) - (168) = (10110010 10101000).
           TX CMD > $7e07  =  (126) - (  7) = (01111110 00000111).
           TX CMD > $7107  =  (113) - (  7) = (01110001 00000111).

Line# 106, Max(  680,  460).
           TX CMD > $b2a8  =  (178) - (168) = (10110010 10101000).
           TX CMD > $f1cc  =  (241) - (204) = (11110001 11001100).
           TX CMD > $5c00  =  ( 92) - (  0) = (01011100 00000000).

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

Line# 147, BLIT config ena 1,msk 0,hc 0,mir 0,vc 0,flp 0,r90 0,r45 0.
           TX CMD > $0001  =  (  0) - (  1) = (00000000 00000001).

Line# 148, BLIT t-color   0.
           TX CMD > $0800  =  (  8) - (  0) = (00001000 00000000).

Line# 150, BLIT source pos(   0,  16), size( 680, 444).
           TX CMD > $a000  =  (160) - (  0) = (10100000 00000000).
           TX CMD > $e010  =  (224) - ( 16) = (11100000 00010000).
           TX CMD > $b2a8  =  (178) - (168) = (10110010 10101000).
           TX CMD > $f1bc  =  (241) - (188) = (11110001 10111100).
           TX CMD > $7600  =  (118) - (  0) = (01110110 00000000).
           TX CMD > $7500  =  (117) - (  0) = (01110101 00000000).

Line# 151, Draw Pixel    (    0,    0),   0.
           TX CMD > $8000  =  (128) - (  0) = (10000000 00000000).
           TX CMD > $c000  =  (192) - (  0) = (11000000 00000000).
           TX CMD > $0100  =  (  1) - (  0) = (00000001 00000000).

Line# 154, Save_PIXIE_BMP dest ( 680, 460), Color.
Line# 157, BLIT config ena 0,msk 0,hc 0,mir 0,vc 0,flp 0,r90 0,r45 0.
           TX CMD > $0000  =  (  0) - (  0) = (00000000 00000000).

Line# 158, Draw Box      (    0,  444)-(  679,  459),   0, filled. 
           TX CMD > $8000  =  (128) - (  0) = (10000000 00000000).
           TX CMD > $c1bc  =  (193) - (188) = (11000001 10111100).
           TX CMD > $92a7  =  (146) - (167) = (10010010 10100111).
           TX CMD > $d1cb  =  (209) - (203) = (11010001 11001011).
           TX CMD > $0c00  =  ( 12) - (  0) = (00001100 00000000).

Line# 161, Save_PIXIE_BMP dest ( 680, 460), Color.
Line# 165, @END command at line number  165.

End of command source ASCII file 'GEO_tb_Blitter.txt'.
 165 lines processed.
