nockieboy/gpu/test/Ellipse_Generator_Testbench_V2/ellipse_generated_results.txt

Log file requested in 'ellipse_commands_in.txt' at line#  39.

Line#  42, Clearing bitmap to color   0.
Line#  45, Sending a reset to the ellipse module.
Line#  48, Run ellipse filled(0), Quadrant(0), POSITION(    0,    0), RADIUS(   15,   15), color(255).
(    0,   15) = 255.
(    1,   15) = 255.
(    2,   15) = 255.
(    3,   15) = 255.
(    4,   14) = 255.
(    5,   14) = 255.
(    6,   14) = 255.
(    7,   13) = 255.
(    8,   13) = 255.
(    9,   12) = 255.
(   10,   11) = 255.
(   15,    0) = 255.
(   15,    1) = 255.
(   15,    2) = 255.
(   15,    3) = 255.
(   14,    4) = 255.
(   14,    5) = 255.
(   14,    6) = 255.
(   13,    7) = 255.
(   13,    8) = 255.
(   12,    9) = 255.
(   11,   10) = 255.

Line#  49, Run ellipse filled(0), Quadrant(0), POSITION(    0,    0), RADIUS(   25,   25), color(127).
(    0,   25) = 127.
(    1,   25) = 127.
(    2,   25) = 127.
(    3,   25) = 127.
(    4,   25) = 127.
(    5,   24) = 127.
(    6,   24) = 127.
(    7,   24) = 127.
(    8,   24) = 127.
(    9,   23) = 127.
(   10,   23) = 127.
(   11,   22) = 127.
(   12,   22) = 127.
(   13,   21) = 127.
(   14,   21) = 127.
(   15,   20) = 127.
(   16,   19) = 127.
(   17,   18) = 127.
(   25,    0) = 127.
(   25,    1) = 127.
(   25,    2) = 127.
(   25,    3) = 127.
(   25,    4) = 127.
(   24,    5) = 127.
(   24,    6) = 127.
(   24,    7) = 127.
(   24,    8) = 127.
(   23,    9) = 127.
(   23,   10) = 127.
(   22,   11) = 127.
(   22,   12) = 127.
(   21,   13) = 127.
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
(  576,  775) = 220.
(  577,  775) = 220.
(  578,  775) = 220.
(  579,  774) = 220.
(  580,  774) = 220.
(  581,  774) = 220.
(  582,  774) = 220.
(  583,  774) = 220.
(  584,  774) = 220.
(  585,  774) = 220.
(  586,  774) = 220.
(  587,  774) = 220.
(  588,  774) = 220.
(  589,  774) = 220.
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

Run ellipse filled(0), Quadrant(1), POSITION(  550,  550), RADIUS(  425,  225), color(220).
(  550,  775) = 220.
(  549,  775) = 220.
(  548,  775) = 220.
(  547,  775) = 220.
(  546,  775) = 220.
(  545,  775) = 220.
(  544,  775) = 220.
(  543,  775) = 220.
(  542,  775) = 220.
(  541,  775) = 220.
(  540,  775) = 220.
(  539,  775) = 220.
(  538,  775) = 220.
(  537,  775) = 220.
(  536,  775) = 220.
(  535,  775) = 220.
(  534,  775) = 220.
(  533,  775) = 220.
(  532,  775) = 220.
(  531,  775) = 220.
(  530,  775) = 220.
(  529,  775) = 220.
(  528,  775) = 220.
(  527,  775) = 220.
(  526,  775) = 220.
(  525,  775) = 220.
(  524,  775) = 220.
(  523,  775) = 220.
(  522,  775) = 220.
(  521,  774) = 220.
(  520,  774) = 220.
(  519,  774) = 220.
(  518,  774) = 220.
(  517,  774) = 220.
(  516,  774) = 220.
(  515,  774) = 220.
(  514,  774) = 220.
(  513,  774) = 220.
(  512,  774) = 220.
(  511,  774) = 220.
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
