nockieboy/gpu/test/Geo_ellipse/ellipse_generated_results.txt

Generating Ellipse, filled> 0, Quadrant> 0, Center>(    0,    0), Radius(   15,   15).
    0,   15
    1,   15
    2,   15
    3,   15
    4,   14
    5,   14
    6,   14
    7,   13
    8,   13
    9,   12
   10,   11
   15,    0
   15,    1
   15,    2
   15,    3
   14,    4
   14,    5
   14,    6
   13,    7
   13,    8
   12,    9
   11,   10
Generating Ellipse, filled> 0, Quadrant> 0, Center>(    0,    0), Radius(   25,   25).
    0,   25
    1,   25
    2,   25
    3,   25
    4,   25
    5,   24
    6,   24
    7,   24
    8,   24
    9,   23
   10,   23
   11,   22
   12,   22
   13,   21
   14,   21
   15,   20
   16,   19
   17,   18
   25,    0
   25,    1
   25,    2
   25,    3
   25,    4
   24,    5
   24,    6
   24,    7
   24,    8
   23,    9
   23,   10
   22,   11
   22,   12
   21,   13
   21,   14
   20,   15
   19,   16
   18,   17
Generating Ellipse, filled> 1, Quadrant> 1, Center>(    0,    0), Radius(   10,   10).
    0,   10
   -1,   10
   -2,   10
   -3,   10
   -2,   10
   -1,   10
    0,   10
    0,   10
   -4,    9
   -5,    9
   -4,    9
   -3,    9
   -2,    9
   -1,    9
    0,    9
    0,    9
   -6,    8
   -5,    8
   -4,    8
   -3,    8
   -2,    8
   -1,    8
    0,    8
    0,    8
   -7,    7
   -6,    7
   -5,    7
   -4,    7
   -3,    7
   -2,    7
   -1,    7
    0,    7
    0,    7
  -10,    0
   -9,    0
   -8,    0
   -7,    0
   -6,    0
   -5,    0
   -4,    0
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
Finished.
