nockieboy/gpu/GPU_TEST_AUDIO/logisim-evolution/boards_model/MAX_V/80P_FPGA_PINS.ods

Sheet: 80P
connecteur | FPGA | xml pin | Exemple : FPGAPin_2="PIN_A4" | FPGAPin_ | § | $
1 | x
2 | A4 | 0 | FPGAPin_0§A4$
3 | B4 | 1 | FPGAPin_1§B4$
4 | A5 | 2 | FPGAPin_2§A5$
5 | B5 | 3 | FPGAPin_3§B5$
6 | A6 | 4 | FPGAPin_4§A6$
7 | B6 | 5 | FPGAPin_5§B6$
8 | C7 | 6 | FPGAPin_6§C7$
9 | A8 | 7 | FPGAPin_7§A8$
10 | A9 | 8 | FPGAPin_8§A9$
11 | B9 | 9 | FPGAPin_9§B9$
12 | B10 | 10 | FPGAPin_10§B10$
13 | C10 | 11 | FPGAPin_11§C10$
14 | C11 | 12 | FPGAPin_12§C11$
15 | D11 | 13 | FPGAPin_13§D11$
16 | C12 | 14 | FPGAPin_14§C12$
17 | D12 | 15 | FPGAPin_15§D12$
18 | C13 | 16 | FPGAPin_16§C13$
19 | B14 | 17 | FPGAPin_17§B14$
20 | C15 | 18 | FPGAPin_18§C15$
21 | B16 | 19 | FPGAPin_19§B16$
22 | D14 | 20 | FPGAPin_20§D14$
23 | D13 | 21 | FPGAPin_21§D13$
24 | E14 | 22 | FPGAPin_22§E14$
25 | E13 | 23 | FPGAPin_23§E13$
26 | F14 | 24 | FPGAPin_24§F14$
27 | F13 | 25 | FPGAPin_25§F13$
28 | G14 | 26 | FPGAPin_26§G14$
29 | H16 | 27 | FPGAPin_27§H16$
30 | H12 | 28 | FPGAPin_28§H12$
31 | J16 | 29 | FPGAPin_29§J16$
32 | J12 | 30 | FPGAPin_30§J12$
33 | K16 | 31 | FPGAPin_31§K16$
34 | L16 | 32 | FPGAPin_32§L16$
35 | L15 | 33 | FPGAPin_33§L15$
36 | M16 | 34 | FPGAPin_34§M16$
37 | M15 | 35 | FPGAPin_35§M15$
38 | N16 | 36 | FPGAPin_36§N16$
39 | N15 | 37 | FPGAPin_37§N15$
40 | N13 | 38 | FPGAPin_38§N13$
41 | A2 | 39 | FPGAPin_39§A2$
42 | B3 | 40 | FPGAPin_40§B3$
43 | C4 | 41 | FPGAPin_41§C4$
44 | D4 | 42 | FPGAPin_42§D4$
45 | C5 | 43 | FPGAPin_43§C5$
46 | D5 | 44 | FPGAPin_44§D5$
47 | C6 | 45 | FPGAPin_45§C6$
48 | A7 | 46 | FPGAPin_46§A7$
49 | B8 | 47 | FPGAPin_47§B8$
50 | C8 | 48 | FPGAPin_48§C8$
51 | C9 | 49 | FPGAPin_49§C9$
52 | A10 | 50 | FPGAPin_50§A10$
53 | A11 | 51 | FPGAPin_51§A11$
54 | B11 | 52 | FPGAPin_52§B11$
55 | A12 | 53 | FPGAPin_53§A12$
56 | B12 | 54 | FPGAPin_54§B12$
57 | A13 | 55 | FPGAPin_55§A13$
58 | B13 | 56 | FPGAPin_56§B13$
59 | C14 | 57 | FPGAPin_57§C14$
60 | A15 | 58 | FPGAPin_58§A15$
61 | D16 | 59 | FPGAPin_59§D16$
62 | D15 | 60 | FPGAPin_60§D15$
63 | E16 | 61 | FPGAPin_61§E16$
64 | E15 | 62 | FPGAPin_62§E15$
65 | F16 | 63 | FPGAPin_63§F16$
66 | F15 | 64 | FPGAPin_64§F15$
67 | G16 | 65 | FPGAPin_65§G16$
68 | G15 | 66 | FPGAPin_66§G15$
69 | H15 | 67 | FPGAPin_67§H15$
70 | H14 | 68 | FPGAPin_68§H14$
71 | J15 | 69 | FPGAPin_69§J15$
72 | J14 | 70 | FPGAPin_70§J14$
73 | K15 | 71 | FPGAPin_71§K15$
74 | K14 | 72 | FPGAPin_72§K14$
75 | L14 | 73 | FPGAPin_73§L14$
76 | L13 | 74 | FPGAPin_74§L13$
77 | M14 | 75 | FPGAPin_75§M14$
78 | M13 | 76 | FPGAPin_76§M13$
79 | N14 | 77 | FPGAPin_77§N14$
80 | x

Sheet: mezz
fpga pin | mezz2
PIN_P6 | [11]
PIN_T2 | [12]
PIN_T5 | [13]
PIN_R3 | [14]
PIN_R5 | [15]
PIN_P4 | [16]
PIN_P5 | [17]
PIN_R4 | [18]
PIN_N5 | [19]
PIN_T4 | [20]
fpga pin | mezz1
PIN_P15 | [5]
PIN_T13 | [6]
PIN_R16 | [7]
PIN_P14 | [8]
PIN_T15 | [9]
PIN_R14 | [10]

Sheet: 25P
subd 25 pin | fpga pin
1 | PIN_R13
2 | PIN_T12
3 | PIN_P12
4 | PIN_T11
5 | PIN_P11
6 | PIN_R10
7 | PIN_T9
8 | PIN_P9
9 | PIN_T8
10 | PIN_P8
11 | PIN_T7
12 | PIN_P7
13 | PIN_R6
14 | PIN_P13
15 | PIN_R12
16 | PIN_N12
17 | PIN_R11
18 | PIN_T10
19 | PIN_P10
20 | PIN_R9
21 | PIN_J2
22 | PIN_R8
23 | PIN_B1
24 | PIN_R7
25 | PIN_T6
