nockieboy/gpu/GPU_TEST_AUDIO/logisim-evolution/boards_model/Reptar_SP6/port80p.ods

pin port80 | pin FPGA | xml pin | Exemple : FPGAPin_2="PIN_A4" | FPGAPin_ | § | $
1
2 | Y21 | 0 | FPGAPin_0§Y21$
3 | AB21 | 1 | FPGAPin_1§AB21$
4 | AA14 | 2 | FPGAPin_2§AA14$
5 | AG25 | 3 | FPGAPin_3§AG25$
6 | AF23 | 4 | FPGAPin_4§AF23$
7 | AF21 | 5 | FPGAPin_5§AF21$
8 | AC16 | 6 | FPGAPin_6§AC16$
9 | AD18 | 7 | FPGAPin_7§AD18$
10 | AA17 | 8 | FPGAPin_8§AA17$
11 | AB19 | 9 | FPGAPin_9§AB19$
12 | AB16 | 10 | FPGAPin_10§AB16$
13 | AF13 | 11 | FPGAPin_11§AF13$
14 | AE12 | 12 | FPGAPin_12§AE12$
15 | AC12 | 13 | FPGAPin_13§AC12$
16 | AB17 | 14 | FPGAPin_14§AB17$
17 | W19 | 15 | FPGAPin_15§W19$
18 | Y19 | 16 | FPGAPin_16§Y19$
19 | AE10 | 17 | FPGAPin_17§AE10$
20 | AC22 | 18 | FPGAPin_18§AC22$
21 | AC14 | 19 | FPGAPin_19§AC14$
22 | AF25 | 20 | FPGAPin_20§AF25$
23 | AE23 | 21 | FPGAPin_21§AE23$
24 | AE21 | 22 | FPGAPin_22§AE21$
25 | AE19 | 23 | FPGAPin_23§AE19$
26 | AE17 | 24 | FPGAPin_24§AE17$
27 | AA15 | 25 | FPGAPin_25§AA15$
28 | AB14 | 26 | FPGAPin_26§AB14$
29 | AD15 | 27 | FPGAPin_27§AD15$
30 | AE13 | 28 | FPGAPin_28§AE13$
31 | AD11 | 29 | FPGAPin_29§AD11$
32 | AF9 | 30 | FPGAPin_30§AF9$
33 | AH8 | 31 | FPGAPin_31§AH8$
34 | AG7 | 32 | FPGAPin_32§AG7$
35 | AE8 | 33 | FPGAPin_33§AE8$
36 | Y12 | 34 | FPGAPin_34§Y12$
37 | W12 | 35 | FPGAPin_35§W12$
38 | W14 | 36 | FPGAPin_36§W14$
39 | Y14 | 37 | FPGAPin_37§Y14$
40 | Y15 | 38 | FPGAPin_38§Y15$
41 | Y16 | 39 | FPGAPin_39§Y16$
42 | Y20 | 40 | FPGAPin_40§Y20$
43 | AA21 | 41 | FPGAPin_41§AA21$
44 | Y13 | 42 | FPGAPin_42§Y13$
45 | AA19 | 43 | FPGAPin_43§AA19$
46 | AF24 | 44 | FPGAPin_44§AF24$
47 | AD22 | 45 | FPGAPin_45§AD22$
48 | AD20 | 46 | FPGAPin_46§AD20$
49 | AF19 | 47 | FPGAPin_47§AF19$
50 | AD17 | 48 | FPGAPin_48§AD17$
51 | AK17 | 49 | FPGAPin_49§AK17$
52 | AJ17 | 50 | FPGAPin_50§AJ17$
53 | AK15 | 51 | FPGAPin_51§AK15$
54 | AF15 | 52 | FPGAPin_52§AF15$
55 | AJ15 | 53 | FPGAPin_53§AJ15$
56 | AD16 | 54 | FPGAPin_54§AD16$
57 | AC15 | 55 | FPGAPin_55§AC15$
58 | W20 | 56 | FPGAPin_56§W20$
59 | AA22 | 57 | FPGAPin_57§AA22$
60 | AC21 | 58 | FPGAPin_58§AC21$
61 | AC24 | 59 | FPGAPin_59§AC24$
62 | AD24 | 60 | FPGAPin_60§AD24$
63 | AE24 | 61 | FPGAPin_61§AE24$
64 | AE22 | 62 | FPGAPin_62§AE22$
65 | AE20 | 63 | FPGAPin_63§AE20$
66 | AE18 | 64 | FPGAPin_64§AE18$
67 | AF17 | 65 | FPGAPin_65§AF17$
68 | AB11 | 66 | FPGAPin_66§AB11$
69 | AB12 | 67 | FPGAPin_67§AB12$
70 | AE15 | 68 | FPGAPin_68§AE15$
71 | AD12 | 69 | FPGAPin_69§AD12$
72 | AD10 | 70 | FPGAPin_70§AD10$
73 | AE9 | 71 | FPGAPin_71§AE9$
74 | AG8 | 72 | FPGAPin_72§AG8$
75 | AF7 | 73 | FPGAPin_73§AF7$
76 | AD8 | 74 | FPGAPin_74§AD8$
77 | AC11 | 75 | FPGAPin_75§AC11$
78 | AB10 | 76 | FPGAPin_76§AB10$
79 | AB9 | 77 | FPGAPin_77§AB9$
80
