nockieboy/gpu/GPU_TEST_AUDIO/logisim-evolution/src/main/resources/doc/el/img-guide/vector-result.png

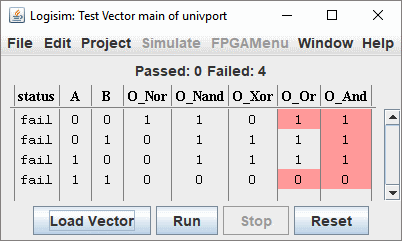
GPU_TEST_AUDIO/logisim-evolution/src/main/resources/doc/el/img-guide/vector-result.png
