nockieboy/gpu/GPU_TEST_AUDIO/logisim-evolution/src/main/resources/doc/en/testhtml/test600.png

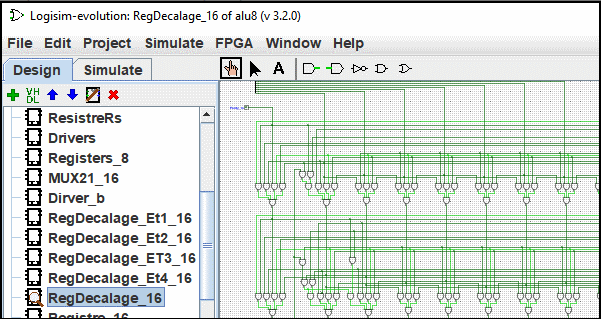
GPU_TEST_AUDIO/logisim-evolution/src/main/resources/doc/en/testhtml/test600.png
