nockieboy/gpu/GPU_TEST_AUDIO/logisim-evolution/src/main/resources/doc/es/img-guide/tutorial-8-test.png

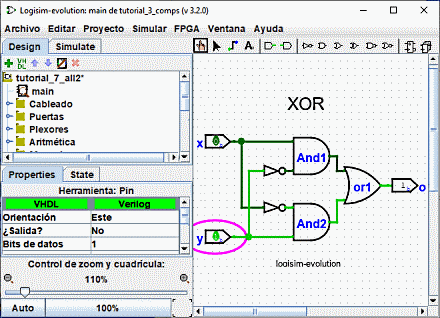
GPU_TEST_AUDIO/logisim-evolution/src/main/resources/doc/es/img-guide/tutorial-8-test.png
