nockieboy/gpu/GPU_TEST_AUDIO/logisim-evolution/src/main/resources/doc/img-guide/printtab-result.png

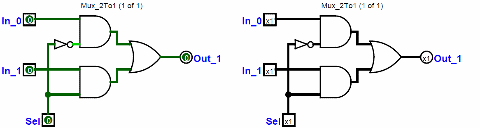
GPU_TEST_AUDIO/logisim-evolution/src/main/resources/doc/img-guide/printtab-result.png
