nockieboy/gpu/GPU_TEST_AUDIO/logisim-evolution/src/main/resources/doc/img-guide/vector-test.png

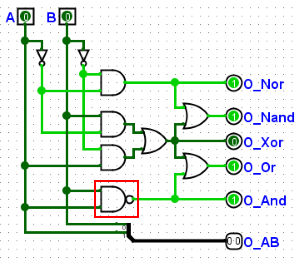
GPU_TEST_AUDIO/logisim-evolution/src/main/resources/doc/img-guide/vector-test.png
