nockieboy/gpu/GPU_TEST_AUDIO/logisim-evolution/src/main/resources/doc/img-libs/gates-basic.png

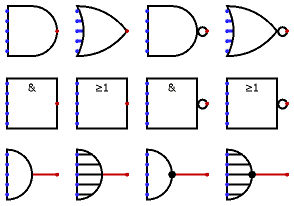
GPU_TEST_AUDIO/logisim-evolution/src/main/resources/doc/img-libs/gates-basic.png
