nockieboy/gpu/GPU_TEST_AUDIO/logisim-evolution/src/main/resources/doc/img-libs/ramdemo.png

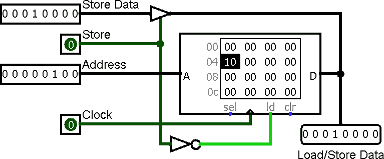
GPU_TEST_AUDIO/logisim-evolution/src/main/resources/doc/img-libs/ramdemo.png
