nockieboy/gpu/test/MAX3421E Tester/images/sim_output.png

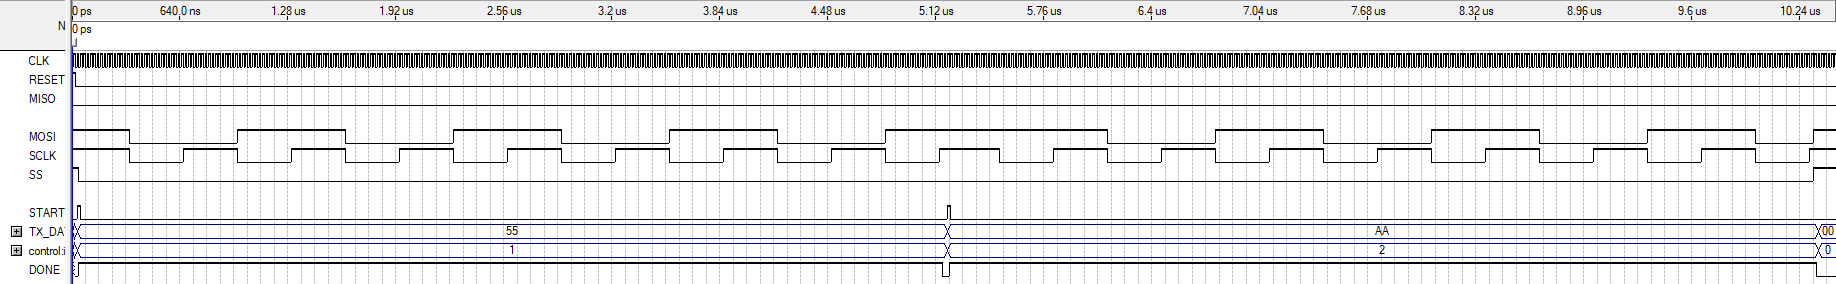
test/MAX3421E Tester/images/sim_output.png
