nockieboy/gpu/test/uCOM_DEBUGGER/Connections.xlsx

GPU Project Pin | DECA IO | Header Pin | GPIO#_D## | Notes | CHECKED
BUFFER CONTROLS
EA_DIR | 8 | 26 | GPIO0_D23 | Default HIGH value for A>B direction
EA_OE | 8 | 25 | GPIO0_D22
HI_DIR | 8 | 36 | GPIO0_D33 | Default HIGH value for A>B direction
HI_OE | 8 | 35 | GPIO0_D32
LO_DIR | 8 | 46 | GPIO0_D43 | Default HIGH value for A>B direction
LO_OE | 8 | 45 | GPIO0_D42
DIR_245 | 9 | 31 | GPIO1_D20 | Default LOW value for A<B direction
OE_245 | 9 | 30 | GPIO1_D19
MISC
IEO |  |  |  | Not used
RESET_PIN |  |  |  | Not used
STATUS_LED
ADDRESS LINES
Z80_ADDR[21] | 8 | 17 | GPIO0_D14
Z80_ADDR[20] | 8 | 18 | GPIO0_D15
Z80_ADDR[19] | 8 | 19 | GPIO0_D16
Z80_ADDR[18] | 8 | 20 | GPIO0_D17
Z80_ADDR[17] | 8 | 21 | GPIO0_D18
Z80_ADDR[16] | 8 | 22 | GPIO0_D19
Z80_ADDR[15] | 8 | 23 | GPIO0_D20
Z80_ADDR[14] | 8 | 24 | GPIO0_D21
LO_A15 | 8 | 26 | GPIO0_D24 | These lines are used by the MMU, which is separate from
LO_A14 | 8 | 27 | GPIO0_D25 | the GPU at the moment and are not needed at this time.
Z80_ADDR[13] | 8 | 29 | GPIO0_D26
Z80_ADDR[12] | 8 | 30 | GPIO0_D27
Z80_ADDR[11] | 8 | 31 | GPIO0_D28
Z80_ADDR[10] | 8 | 32 | GPIO0_D29
Z80_ADDR[9] | 8 | 33 | GPIO0_D30
Z80_ADDR[8] | 8 | 34 | GPIO0_D31
Z80_ADDR[7] | 8 | 37 | GPIO0_D34
Z80_ADDR[6] | 8 | 38 | GPIO0_D35
Z80_ADDR[5] | 8 | 39 | GPIO0_D36
Z80_ADDR[4] | 8 | 40 | GPIO0_D37
Z80_ADDR[3] | 8 | 41 | GPIO0_D38
Z80_ADDR[2] | 8 | 42 | GPIO0_D39
Z80_ADDR[1] | 8 | 43 | GPIO0_D40
Z80_ADDR[0] | 8 | 44 | GPIO0_D41
DATA LINES
Z80_data[7] | 9 | 22 | GPIO1_D11
Z80_data[6] | 9 | 23 | GPIO1_D12
Z80_data[5] | 9 | 24 | GPIO1_D13
Z80_data[4] | 9 | 25 | GPIO1_D14
Z80_data[3] | 9 | 26 | GPIO1_D15
Z80_data[2] | 9 | 27 | GPIO1_D16
Z80_data[1] | 9 | 28 | GPIO1_D17
Z80_data[0] | 9 | 29 | GPIO1_D18
CONTROL BUS INPUTS
Z80_INT_RQ | 9 |  |  | Not used
Z80_CLK | 9 | 14 | GPIO1_D3
Z80_RD | 9 | 15 | GPIO1_D4
Z80_WR | 9 | 16 | GPIO1_D5
Z80_MREQ | 9 | 17 | GPIO1_D6
Z80_IORQ | 9 | 18 | GPIO1_D7
Z80_M1 | 9 | 19 | GPIO1_D8
Z80_BUSACK | 9 |  | GPIO1_D9
Z80_RST | 9 | 21 | GPIO1_D10
CONTROL BUS OUTPUTS (specific to DECA interface)
WAIT | 8 | 11 | GPIO0_D8
WR | 8 | 12 | GPIO0_D9
M_REQ | 8 | 13 | GPIO0_D10
RD | 8 | 14 | GPIO0_D11
BUS_REQ | 8 | 15 | GPIO0_D12
IO_REQ | 8 | 16 | GPIO0_D13
SYS_RESET_n |  |  | GPIO0_D4
SDA | 8 | 3 | GPIO0_D0
SCL | 8 | 4 | GPIO0_D1
