nockieboy/gpu/docs/Schematic_uCOM_GPU_5CEBA2_2020-10-20_14-45-52_v1.pdf

A | A
B | B
C | C
D | D

### TITLE:

Cyclone V GPU | REV: 1.0
Date: | 2020-10-20

### Sheet: 1/1 Drawn By: nockieboy

### Company: 10103

# CYCLONE V GPU SCHEMATICS

# INDEX

# DVI OUTPUT

# VGA OUTPUT

# 5V TO 3.3V BUS CONVERSION

# CLOCK & FPGA CONFIGURATION

# FPGA CONNECTIONS

# GPU BOARD PERIPHERALS

# POWER SUPPLIES

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
# PAGE CONTENT

# 9. DECOUPLING

# 24-bit DVI VIDEO OUTPUT

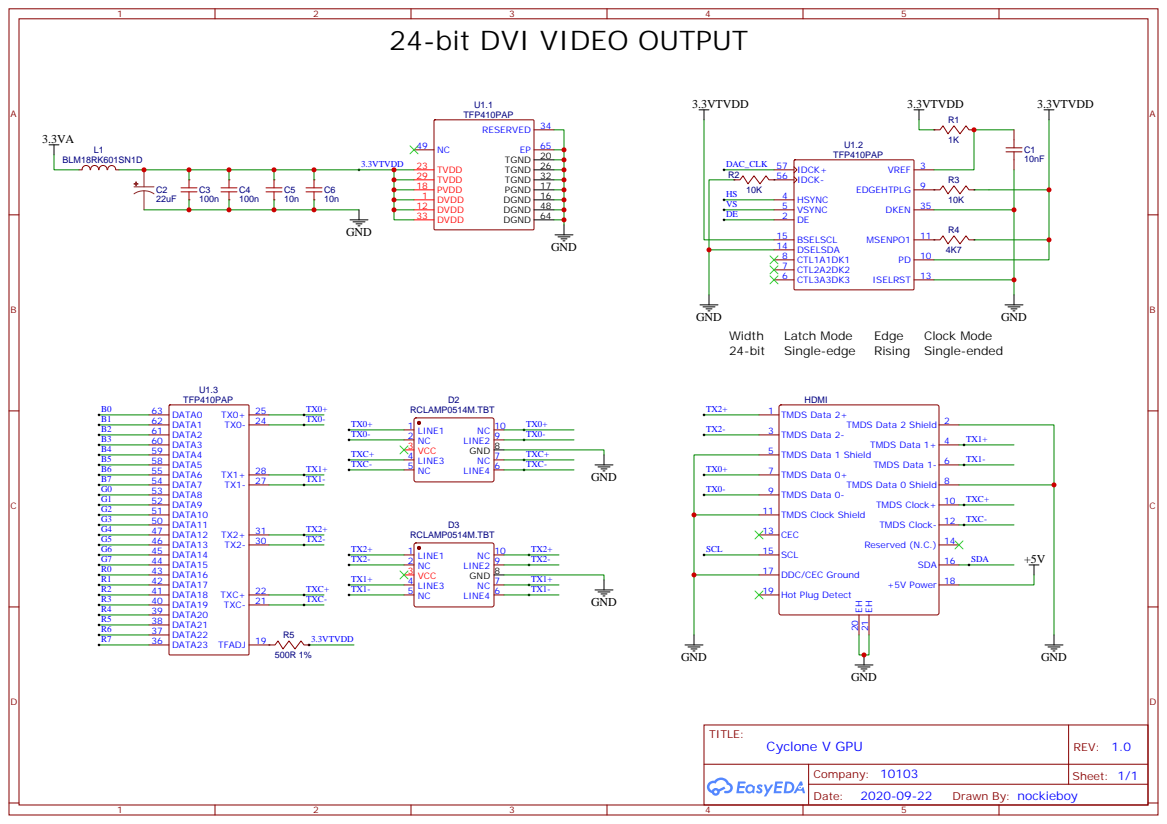
[picture p203: page 2]

# 24-bit VGA VIDEO OUTPUT

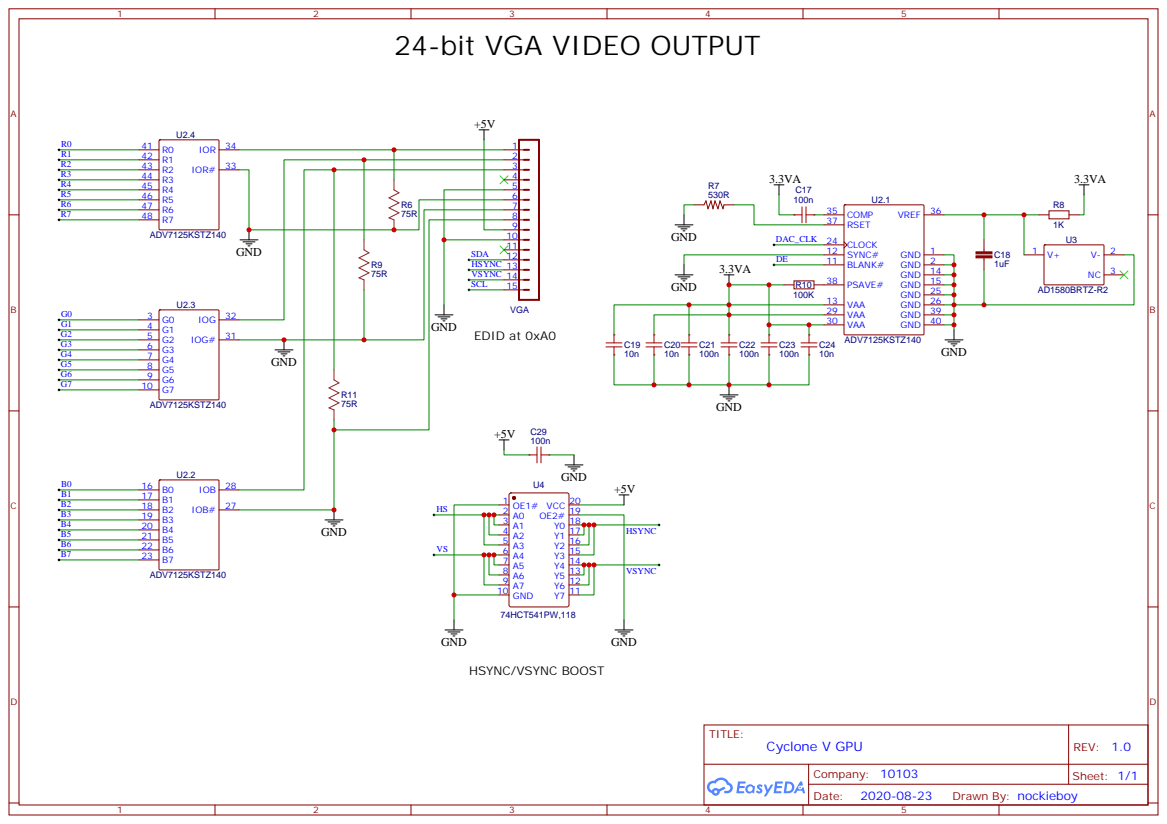
[picture p204: page 3]

## FPGA<>Z80

## Z80>FPGA

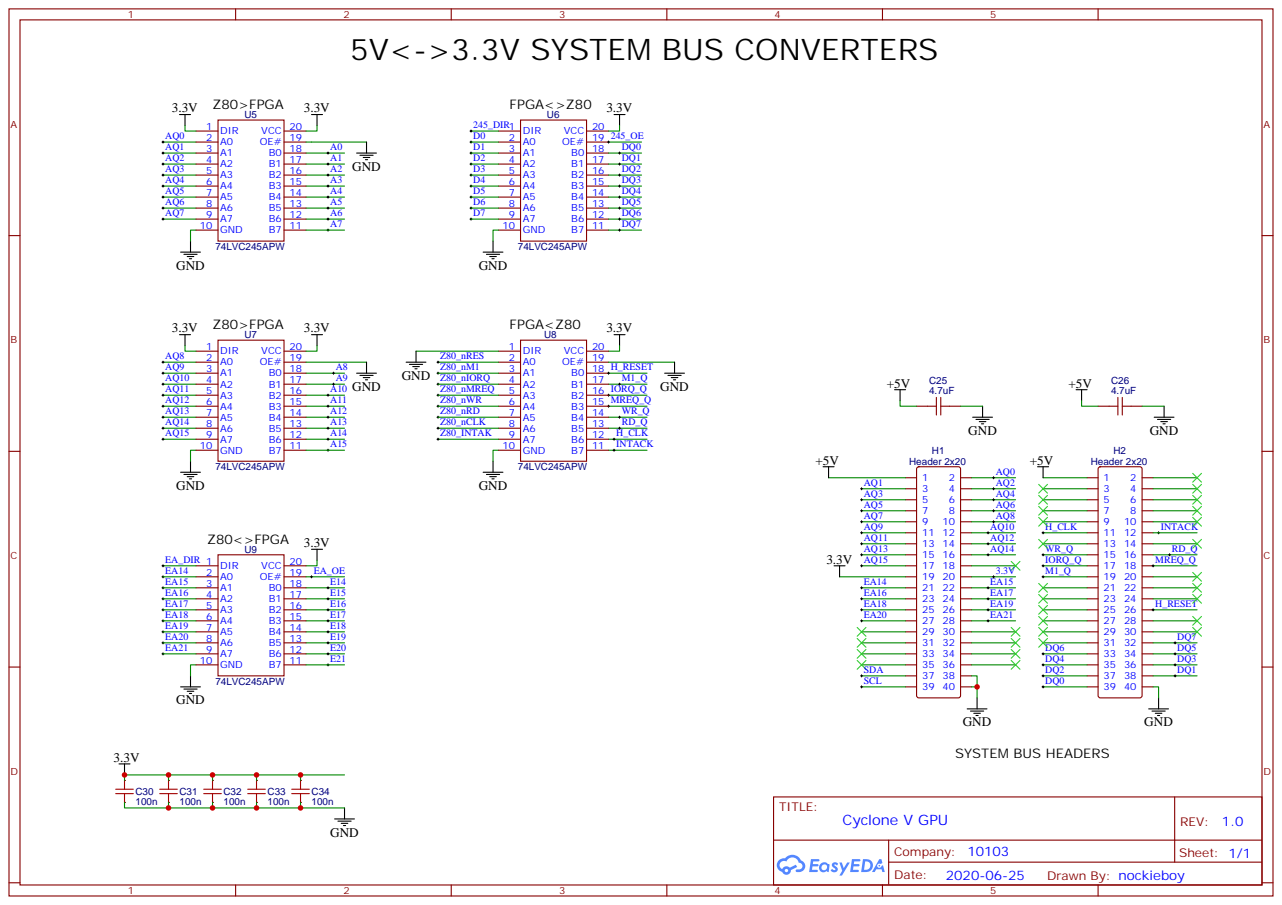
[picture p205: page 4]

# CLOCK & FPGA CONFIGURATION

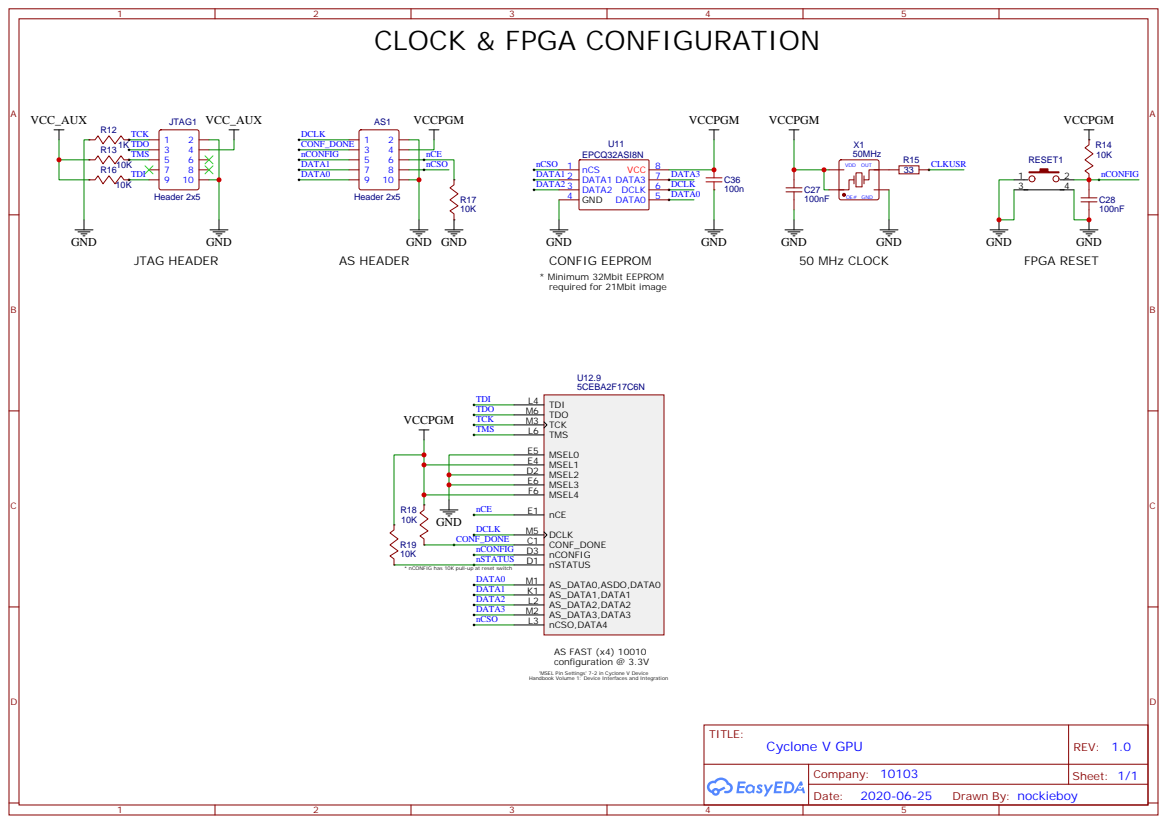
[picture p206: page 5]

* nCONFIG has 10K pull-up at reset switch

'MSEL Pin Settings' 7-2 in Cyclone V Device
Handbook Volume 1: Device Interfaces and Integration

NOTE: Cyclone V A2 and A4 versions are pin-compatible and interchangeable on this PCB design.

# Cyclone V FPGA

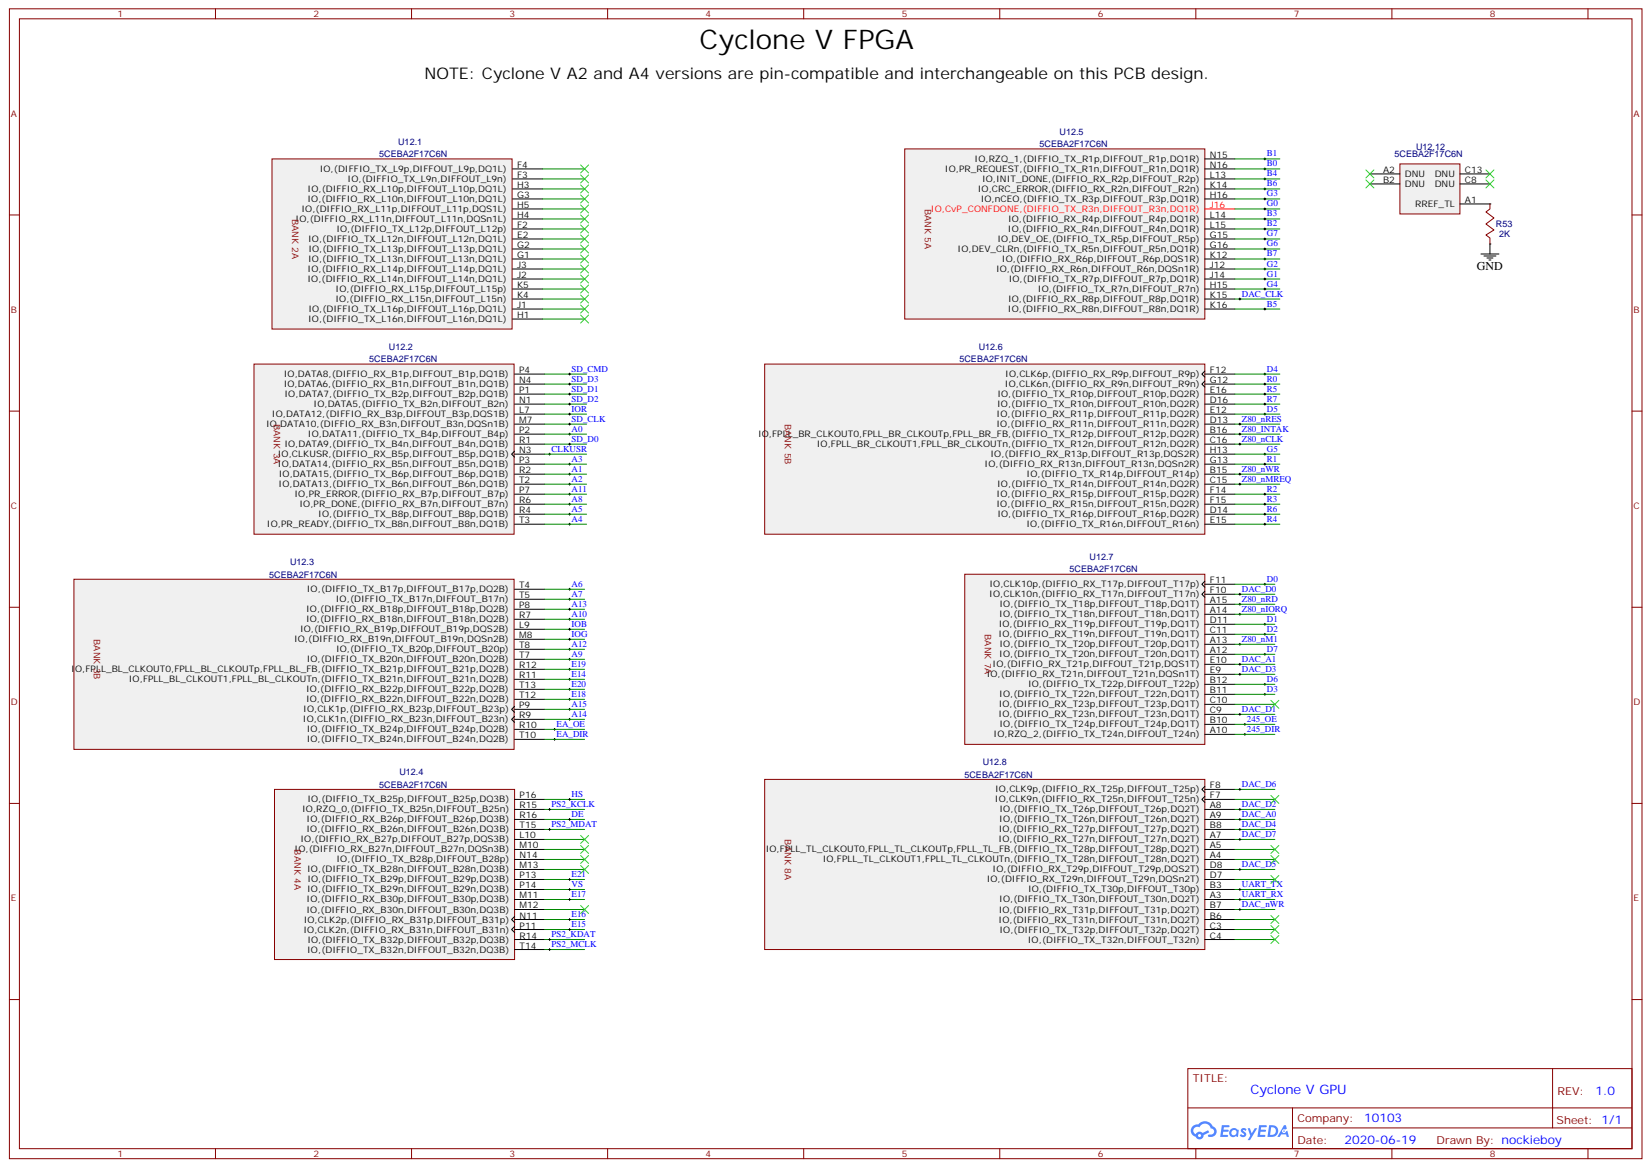
[picture p207: page 6]

# PERIPHERALS

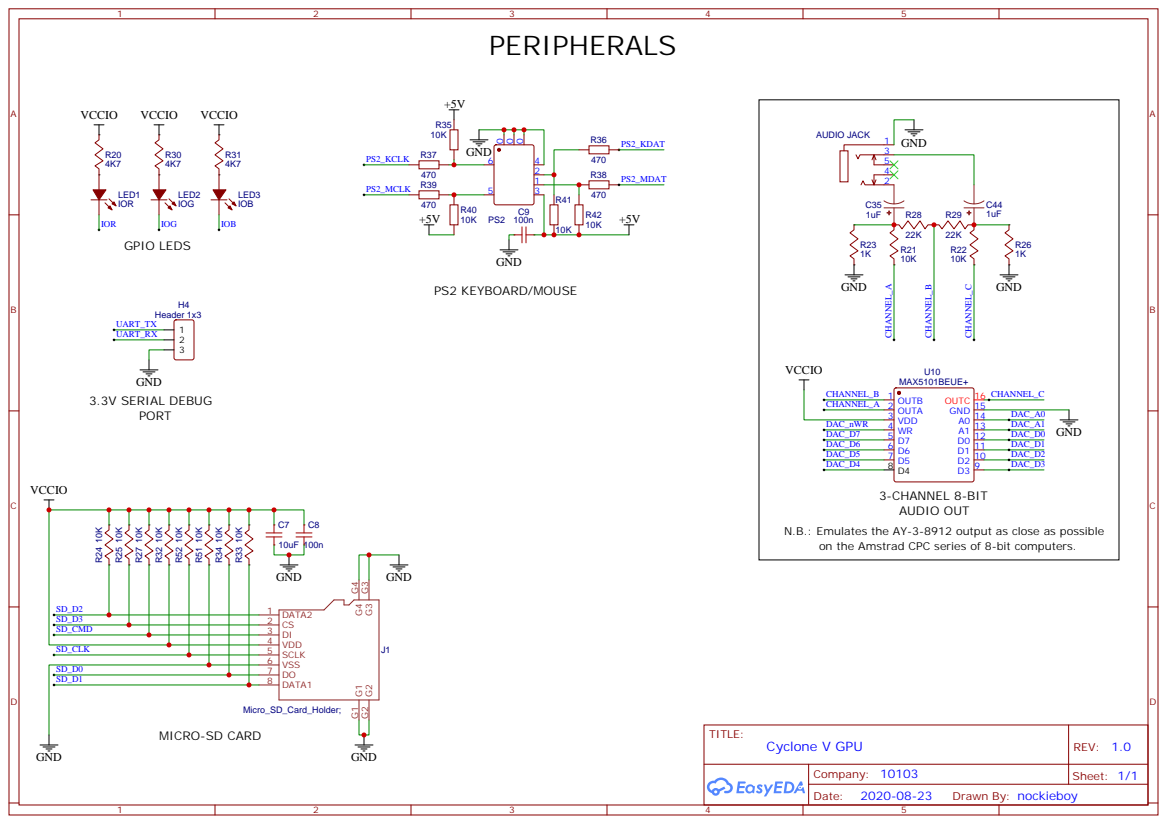
[picture p208: page 7]

N.B.: Emulates the AY-3-8912 output as close as possible
on the Amstrad CPC series of 8-bit computers.

## VIDEO DAC SUPPLY

VCC L8 VCC K11 VCC K9 VCC K7 VCC J10 VCC J8 VCC J6 VCC H11 VCC H9 VCC H7 VCC G10 VCC G8 VCC G6

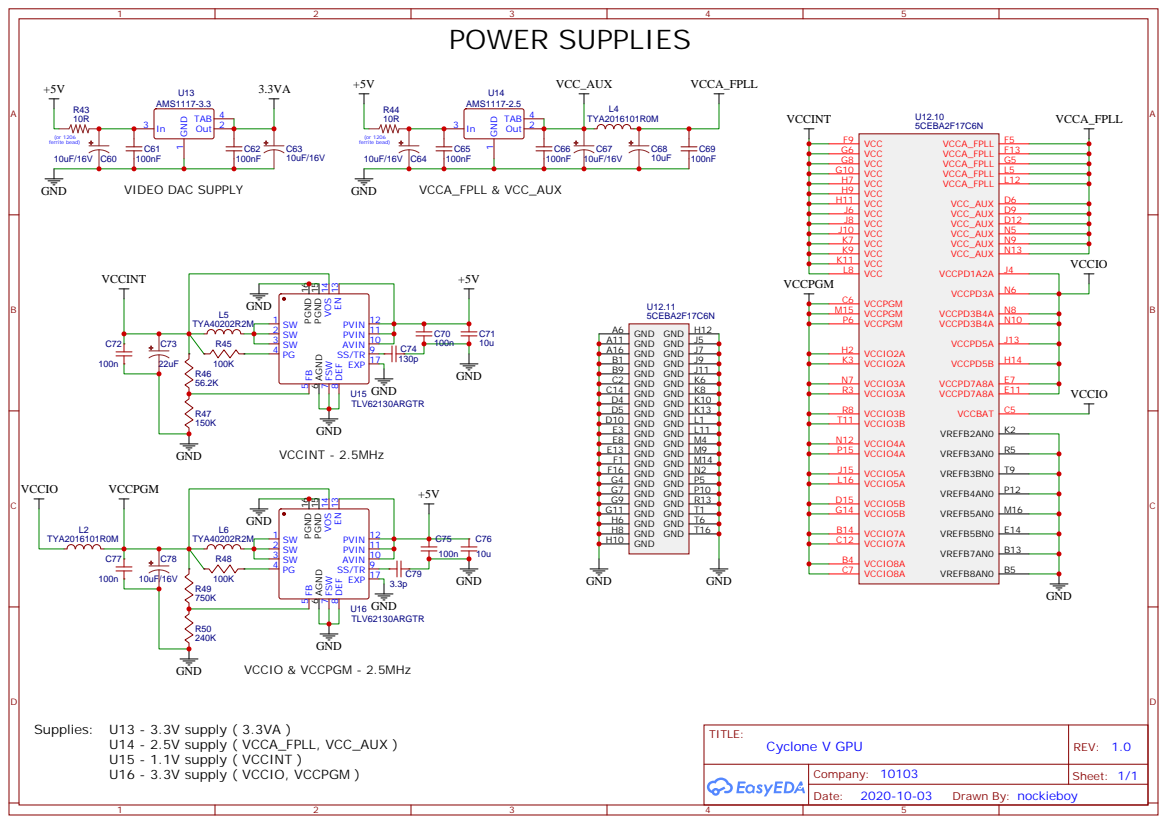
[picture p209: page 8]

VCCPGM
GND T16 GND T6 GND T1 GND R13 GND P10 GND P5 GND N2 GND M14 GND M9 GND M4 GND L11 GND L1 GND K13 GND K10 GND K8 GND K6 GND J11 GND J9 GND J7 GND J5

5CEBA2F17C6N
GND H12
GND H10 GND H8 GND H6 GND G11 GND G9 GND G7 GND G4 GND F16 GND F1 GND E13 GND E8 GND E3 GND D10 GND D5

GND C2 GND B9 GND B1 GND A16 GND A11 GND A6

## Note: Place capacitors near FPGA pins

# FPGA DECOUPLING

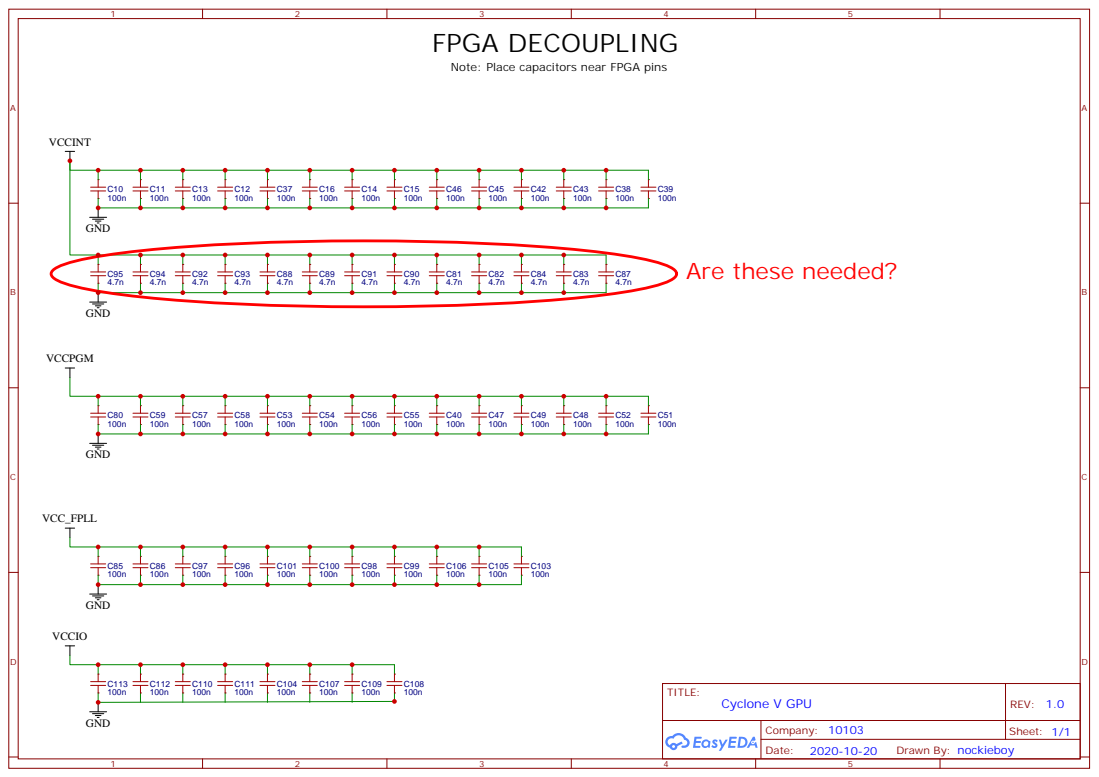
[picture p210: page 9]
