nockieboy/gpu/docs/Schematic_uCOM_GPU_5CEBA2_2020-10-31_13-05-11_v1.4.pdf

A | A
B | B
C | C
D | D

### TITLE:

Cyclone V GPU | REV: 1.4
Date: | 2020-10-20

### Sheet: 1/1 Drawn By: nockieboy

### Company: 10103

# CYCLONE V GPU SCHEMATICS

# INDEX

# DVI OUTPUT

# VGA OUTPUT

# 5V TO 3.3V BUS CONVERSION

# CLOCK & FPGA CONFIGURATION

# FPGA CONNECTIONS

# GPU BOARD PERIPHERALS

# POWER SUPPLIES

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
# PAGE CONTENT

# 9. DECOUPLING

# REVISIONS

1.0 - Initial draft

1.1 - Replaced MAX5101 DAC with PCM5101A. Replaced wire-wound chokes with fixed inductors.

1.2 - Added decoupling and supply isolation for TFP410.

# 10. FPGA EXTERNAL MEMORY

1.3 - Removed decoupling and supply isolation for TFP410. Added external memory.

1.4 - 10u caps and 100k pull-downs added to audio DAC output. Fixed micro-SD pullups. Corrected DDR-RAM clock pins. Variable-voltage added to U19.

# 24-bit DVI VIDEO OUTPUT

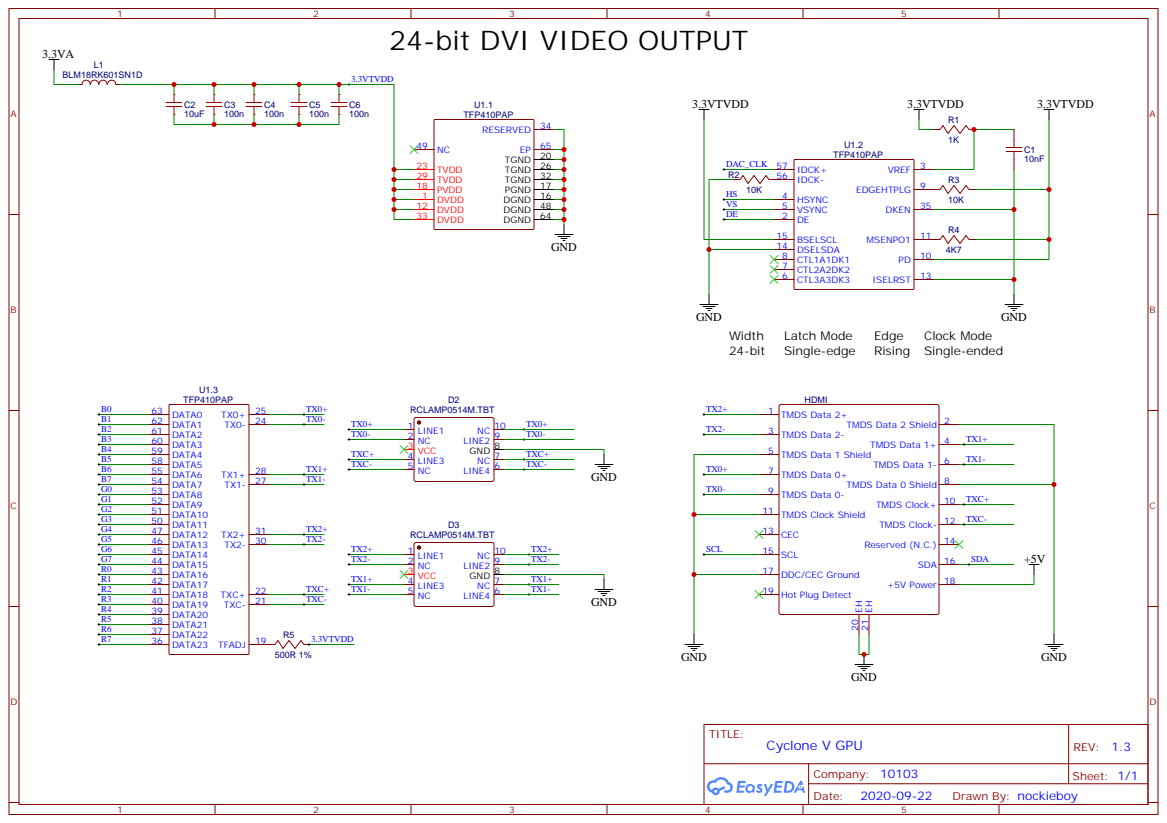
[picture p225: page 2]

# 24-bit VGA VIDEO OUTPUT


## FPGA<>Z80

## Z80>FPGA


# CLOCK & FPGA CONFIGURATION


* nCONFIG has 10K pull-up at reset switch

'MSEL Pin Settings' 7-2 in Cyclone V Device
Handbook Volume 1: Device Interfaces and Integration

NOTE: Cyclone V A2 and A4 versions are pin-compatible and interchangeable on this PCB design.

# Cyclone V FPGA

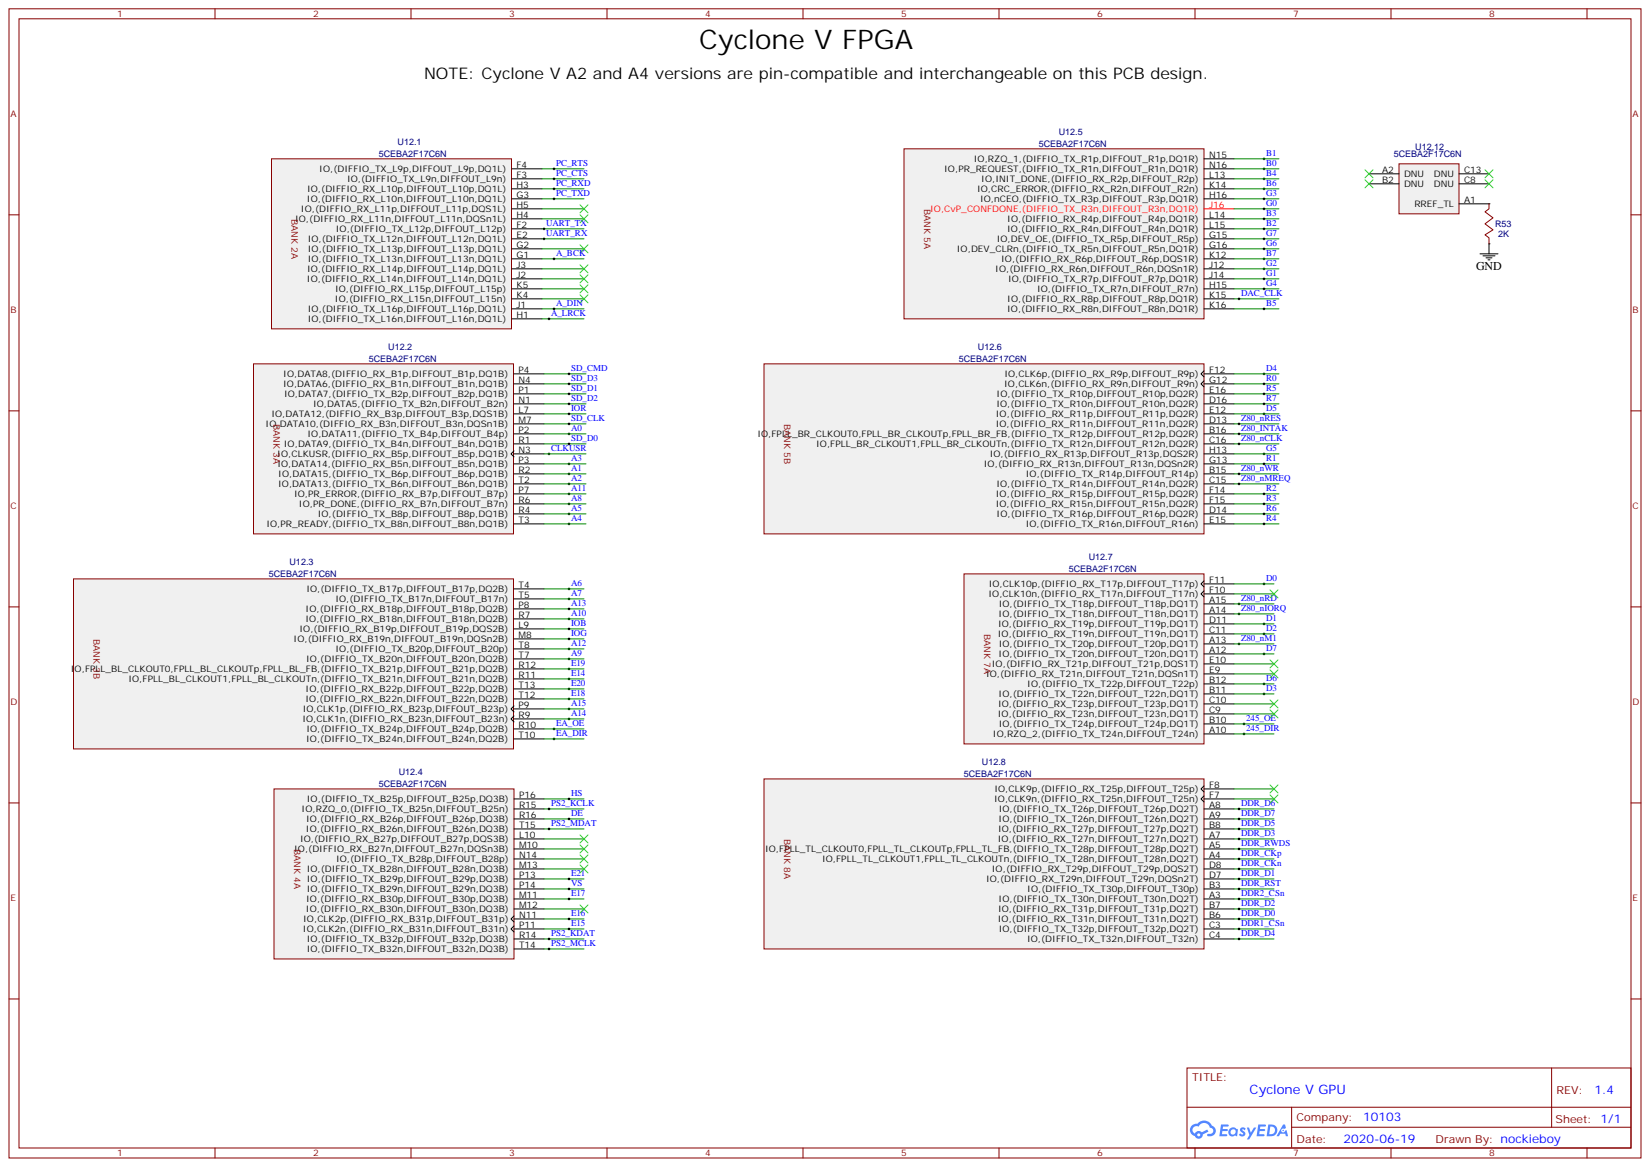
[picture p226: page 6]

# PERIPHERALS

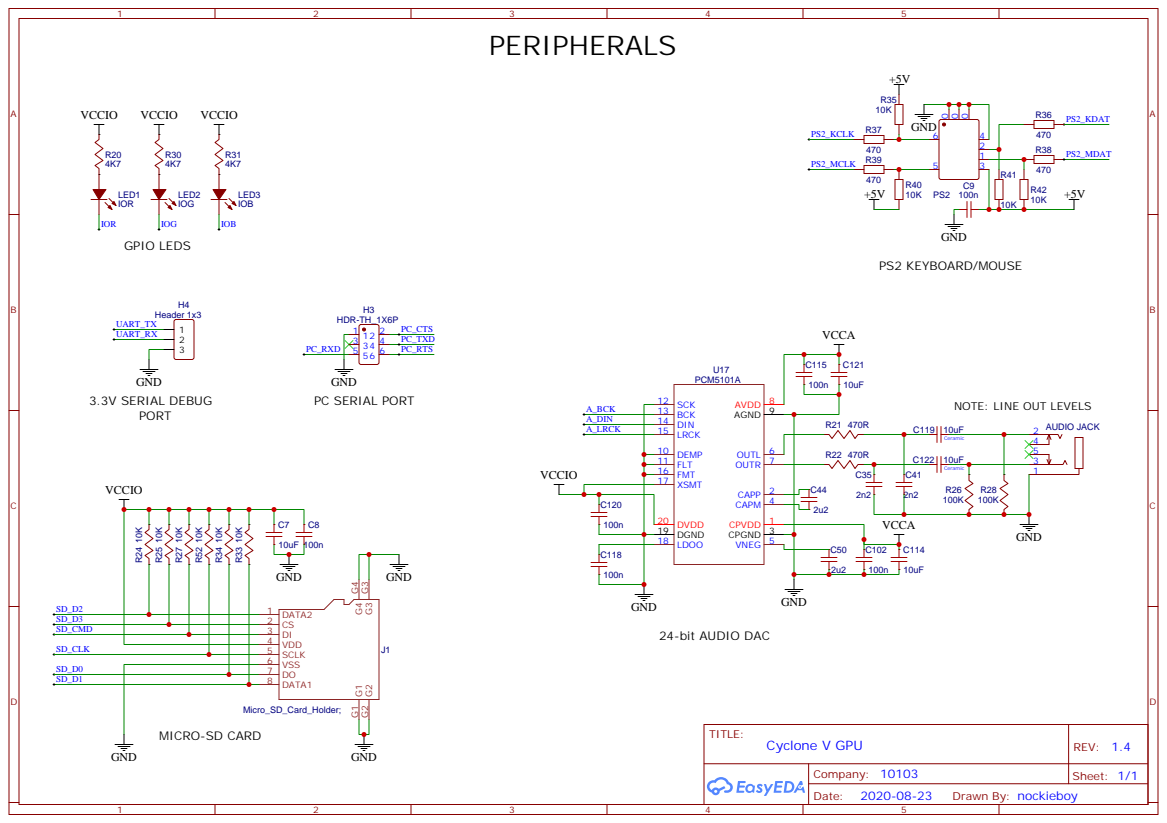
[picture p227: page 7]

NOTE: LINE OUT LEVELS

## VIDEO DAC SUPPLY

VCC L8 VCC K11 VCC K9 VCC K7 VCC J10 VCC J8 VCC J6 VCC H11 VCC H9 VCC H7 VCC G10 VCC G8 VCC G6

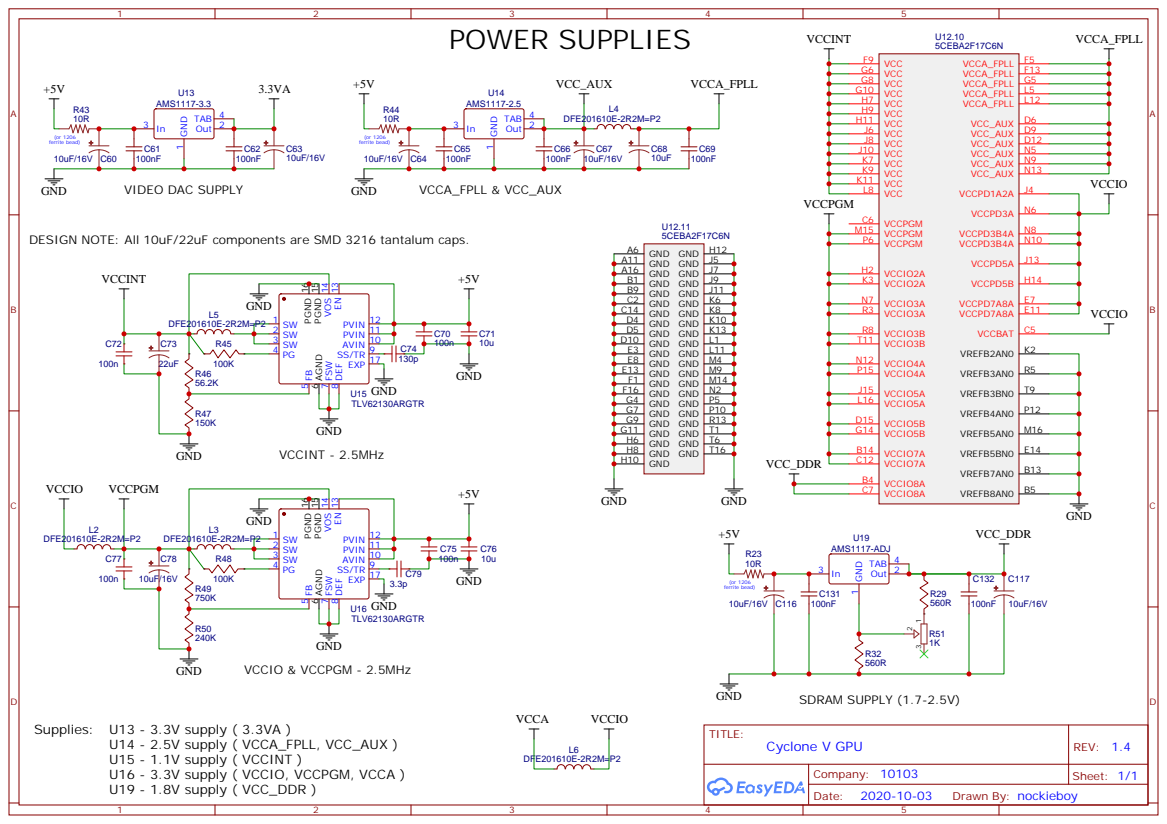
[picture p228: page 8]

VCCPGM
GND T16 GND T6 GND T1 GND R13 GND P10 GND P5 GND N2 GND M14 GND M9 GND M4 GND L11 GND L1 GND K13 GND K10 GND K8 GND K6 GND J11 GND J9 GND J7 GND J5
GND H10 GND H8 GND H6 GND G11 GND G9 GND G7 GND G4 GND F16 GND F1 GND E13 GND E8 GND E3 GND D10 GND D5

DESIGN NOTE: All 10uF/22uF components are SMD 3216 tantalum caps.

GND C2 GND B9 GND B1 GND A16 GND A11 GND A6

## Note: Place capacitors near FPGA pins

# FPGA DECOUPLING


# FPGA EXTERNAL MEMORY

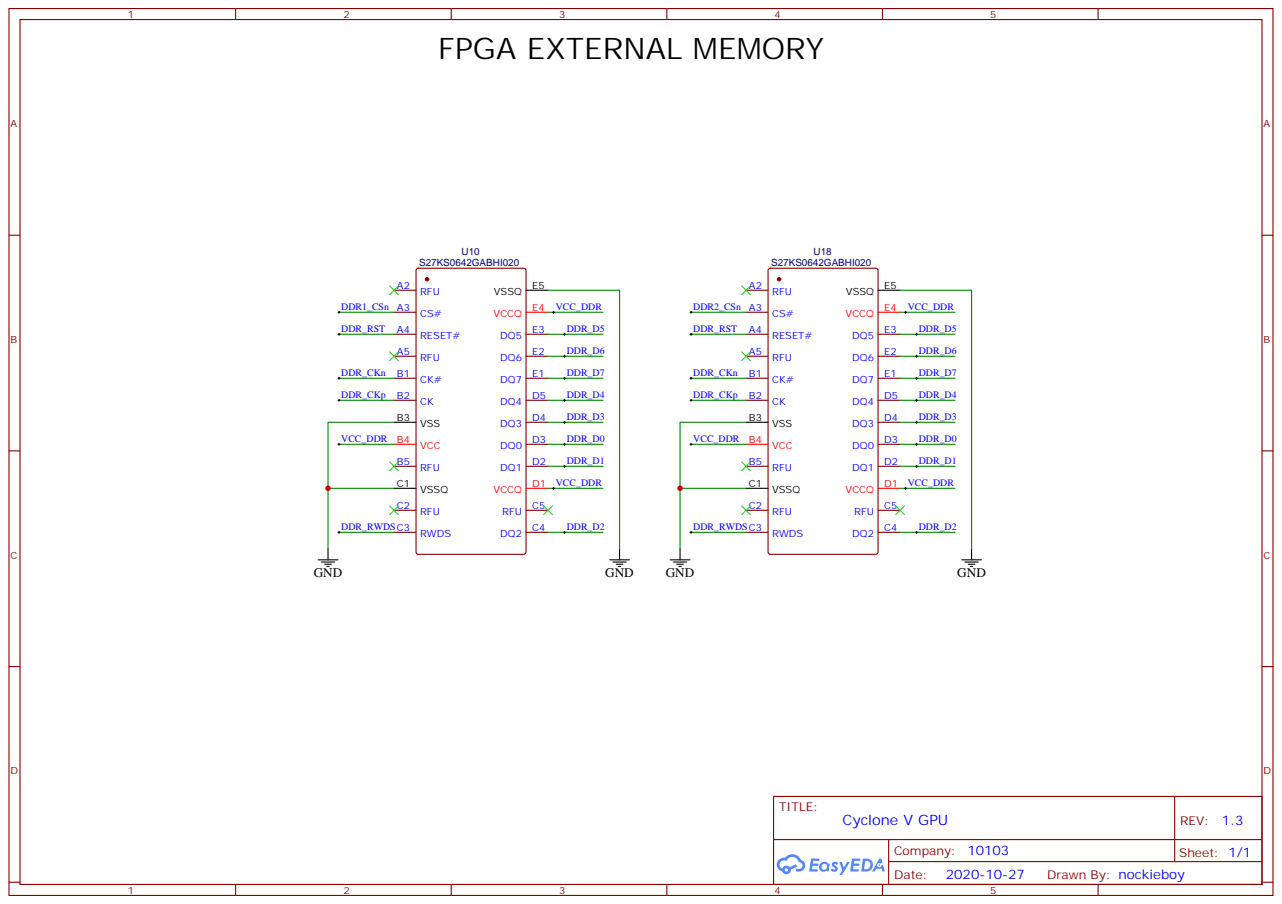
[picture p229: page 10]
