nockieboy/gpu/test/DVI Tester/Schematic_DVI Output Test_2020-11-17_11-43-32.pdf

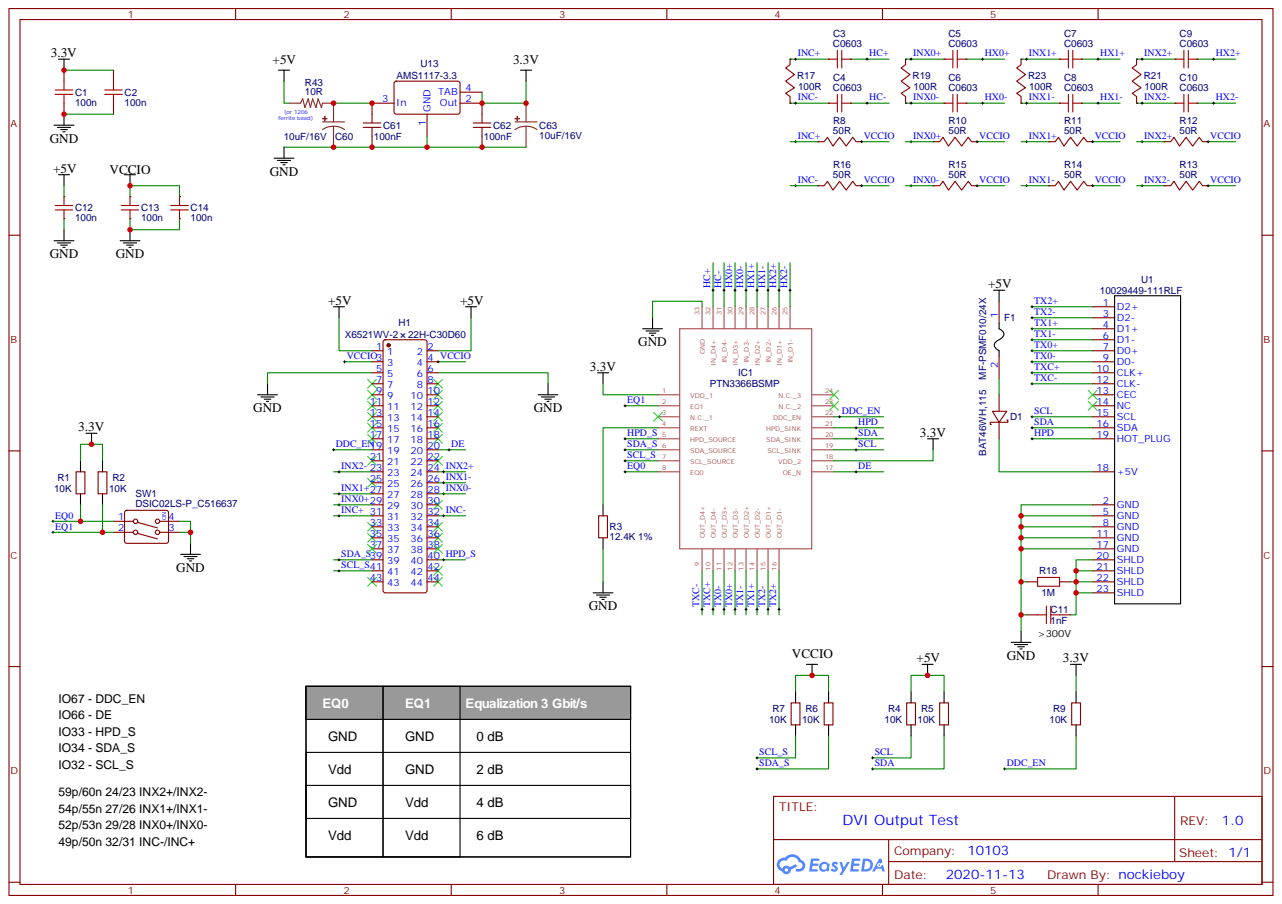
[picture p230: page 1]
