nockieboy/gpu/GPU_DECA_DDR3_version_16/FPU/ADD/ADD40/ADD40_0002.vhd

-- ------------------------------------------------------------------------- 
-- High Level Design Compiler for Intel(R) FPGAs Version 20.1 (Release Build #720)
-- Quartus Prime development tool and MATLAB/Simulink Interface
-- 
-- Legal Notice: Copyright 2020 Intel Corporation.  All rights reserved.
-- Your use of  Intel Corporation's design tools,  logic functions and other
-- software and  tools, and its AMPP partner logic functions, and any output
-- files any  of the foregoing (including  device programming  or simulation
-- files), and  any associated  documentation  or information  are expressly
-- subject  to the terms and  conditions of the  Intel FPGA Software License
-- Agreement, Intel MegaCore Function License Agreement, or other applicable
-- license agreement,  including,  without limitation,  that your use is for
-- the  sole  purpose of  programming  logic devices  manufactured by  Intel
-- and  sold by Intel  or its authorized  distributors. Please refer  to the
-- applicable agreement for further details.
-- ---------------------------------------------------------------------------

-- VHDL created from ADD40_0002
-- VHDL created on Thu Oct 20 17:16:45 2022


library IEEE;
use IEEE.std_logic_1164.all;
use IEEE.NUMERIC_STD.all;
use IEEE.MATH_REAL.all;
use std.TextIO.all;
use work.dspba_library_package.all;

LIBRARY altera_mf;
USE altera_mf.altera_mf_components.all;
LIBRARY lpm;
USE lpm.lpm_components.all;

entity ADD40_0002 is
    port (
        a : in std_logic_vector(39 downto 0);  -- float40_m31
        b : in std_logic_vector(39 downto 0);  -- float40_m31
        q : out std_logic_vector(39 downto 0);  -- float40_m31
        s : out std_logic_vector(39 downto 0);  -- float40_m31
        clk : in std_logic;
        areset : in std_logic
    );
end ADD40_0002;

architecture normal of ADD40_0002 is

    attribute altera_attribute : string;
    attribute altera_attribute of normal : architecture is "-name AUTO_SHIFT_REGISTER_RECOGNITION OFF; -name PHYSICAL_SYNTHESIS_REGISTER_DUPLICATION ON; -name MESSAGE_DISABLE 10036; -name MESSAGE_DISABLE 10037; -name MESSAGE_DISABLE 14130; -name MESSAGE_DISABLE 14320; -name MESSAGE_DISABLE 15400; -name MESSAGE_DISABLE 14130; -name MESSAGE_DISABLE 10036; -name MESSAGE_DISABLE 12020; -name MESSAGE_DISABLE 12030; -name MESSAGE_DISABLE 12010; -name MESSAGE_DISABLE 12110; -name MESSAGE_DISABLE 14320; -name MESSAGE_DISABLE 13410; -name MESSAGE_DISABLE 113007";
    
    signal GND_q : STD_LOGIC_VECTOR (0 downto 0);
    signal VCC_q : STD_LOGIC_VECTOR (0 downto 0);
    signal expFracX_uid6_fpFusedAddSubTest_b : STD_LOGIC_VECTOR (38 downto 0);
    signal expFracY_uid7_fpFusedAddSubTest_b : STD_LOGIC_VECTOR (38 downto 0);
    signal xGTEy_uid8_fpFusedAddSubTest_a : STD_LOGIC_VECTOR (40 downto 0);
    signal xGTEy_uid8_fpFusedAddSubTest_b : STD_LOGIC_VECTOR (40 downto 0);
    signal xGTEy_uid8_fpFusedAddSubTest_o : STD_LOGIC_VECTOR (40 downto 0);
    signal xGTEy_uid8_fpFusedAddSubTest_n : STD_LOGIC_VECTOR (0 downto 0);
    signal siga_uid9_fpFusedAddSubTest_s : STD_LOGIC_VECTOR (0 downto 0);
    signal siga_uid9_fpFusedAddSubTest_q : STD_LOGIC_VECTOR (39 downto 0);
    signal sigb_uid10_fpFusedAddSubTest_s : STD_LOGIC_VECTOR (0 downto 0);
    signal sigb_uid10_fpFusedAddSubTest_q : STD_LOGIC_VECTOR (39 downto 0);
    signal cstAllOWE_uid11_fpFusedAddSubTest_q : STD_LOGIC_VECTOR (7 downto 0);
    signal cstZeroWF_uid12_fpFusedAddSubTest_q : STD_LOGIC_VECTOR (30 downto 0);
    signal cstAllZWE_uid13_fpFusedAddSubTest_q : STD_LOGIC_VECTOR (7 downto 0);
    signal exp_siga_uid14_fpFusedAddSubTest_in : STD_LOGIC_VECTOR (38 downto 0);
    signal exp_siga_uid14_fpFusedAddSubTest_b : STD_LOGIC_VECTOR (7 downto 0);
    signal frac_siga_uid15_fpFusedAddSubTest_in : STD_LOGIC_VECTOR (30 downto 0);
    signal frac_siga_uid15_fpFusedAddSubTest_b : STD_LOGIC_VECTOR (30 downto 0);
    signal excZ_siga_uid9_uid16_fpFusedAddSubTest_qi : STD_LOGIC_VECTOR (0 downto 0);
    signal excZ_siga_uid9_uid16_fpFusedAddSubTest_q : STD_LOGIC_VECTOR (0 downto 0);
    signal expXIsMax_uid17_fpFusedAddSubTest_qi : STD_LOGIC_VECTOR (0 downto 0);
    signal expXIsMax_uid17_fpFusedAddSubTest_q : STD_LOGIC_VECTOR (0 downto 0);
    signal fracXIsZero_uid18_fpFusedAddSubTest_qi : STD_LOGIC_VECTOR (0 downto 0);
    signal fracXIsZero_uid18_fpFusedAddSubTest_q : STD_LOGIC_VECTOR (0 downto 0);
    signal fracXIsNotZero_uid19_fpFusedAddSubTest_q : STD_LOGIC_VECTOR (0 downto 0);
    signal excI_siga_uid20_fpFusedAddSubTest_q : STD_LOGIC_VECTOR (0 downto 0);
    signal excN_siga_uid21_fpFusedAddSubTest_q : STD_LOGIC_VECTOR (0 downto 0);
    signal invExpXIsMax_uid22_fpFusedAddSubTest_q : STD_LOGIC_VECTOR (0 downto 0);
    signal InvExpXIsZero_uid23_fpFusedAddSubTest_q : STD_LOGIC_VECTOR (0 downto 0);
    signal excR_siga_uid24_fpFusedAddSubTest_q : STD_LOGIC_VECTOR (0 downto 0);
    signal exp_sigb_uid28_fpFusedAddSubTest_in : STD_LOGIC_VECTOR (38 downto 0);
    signal exp_sigb_uid28_fpFusedAddSubTest_b : STD_LOGIC_VECTOR (7 downto 0);
    signal frac_sigb_uid29_fpFusedAddSubTest_in : STD_LOGIC_VECTOR (30 downto 0);
    signal frac_sigb_uid29_fpFusedAddSubTest_b : STD_LOGIC_VECTOR (30 downto 0);
    signal excZ_sigb_uid10_uid30_fpFusedAddSubTest_qi : STD_LOGIC_VECTOR (0 downto 0);
    signal excZ_sigb_uid10_uid30_fpFusedAddSubTest_q : STD_LOGIC_VECTOR (0 downto 0);
    signal expXIsMax_uid31_fpFusedAddSubTest_qi : STD_LOGIC_VECTOR (0 downto 0);
    signal expXIsMax_uid31_fpFusedAddSubTest_q : STD_LOGIC_VECTOR (0 downto 0);
    signal fracXIsZero_uid32_fpFusedAddSubTest_qi : STD_LOGIC_VECTOR (0 downto 0);
    signal fracXIsZero_uid32_fpFusedAddSubTest_q : STD_LOGIC_VECTOR (0 downto 0);
    signal fracXIsNotZero_uid33_fpFusedAddSubTest_q : STD_LOGIC_VECTOR (0 downto 0);
    signal excI_sigb_uid34_fpFusedAddSubTest_q : STD_LOGIC_VECTOR (0 downto 0);
    signal excN_sigb_uid35_fpFusedAddSubTest_q : STD_LOGIC_VECTOR (0 downto 0);
    signal invExpXIsMax_uid36_fpFusedAddSubTest_q : STD_LOGIC_VECTOR (0 downto 0);
    signal InvExpXIsZero_uid37_fpFusedAddSubTest_q : STD_LOGIC_VECTOR (0 downto 0);
    signal excR_sigb_uid38_fpFusedAddSubTest_qi : STD_LOGIC_VECTOR (0 downto 0);
    signal excR_sigb_uid38_fpFusedAddSubTest_q : STD_LOGIC_VECTOR (0 downto 0);
    signal sigA_uid43_fpFusedAddSubTest_b : STD_LOGIC_VECTOR (0 downto 0);
    signal sigB_uid44_fpFusedAddSubTest_b : STD_LOGIC_VECTOR (0 downto 0);
    signal effSub_uid45_fpFusedAddSubTest_q : STD_LOGIC_VECTOR (0 downto 0);
    signal expAmExpB_uid48_fpFusedAddSubTest_a : STD_LOGIC_VECTOR (8 downto 0);
    signal expAmExpB_uid48_fpFusedAddSubTest_b : STD_LOGIC_VECTOR (8 downto 0);
    signal expAmExpB_uid48_fpFusedAddSubTest_o : STD_LOGIC_VECTOR (8 downto 0);
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
