nockieboy/gpu/(commit log)

2019-11-21 RS232_Debugger & 8x16 font support
    [Pin_Assignments.xlsx]
2019-11-26 Added white noise. RS232 updated. Tests created for simulation.
    [SYNC_RS232_UART.v, Z80_bridge.v, gpu_dual_port_ram_INTEL.v, rs232_DEBUGGER.v, sync_gen.v]
2019-12-10 Enhanced bitplane_to_raster
    [HW_regs_assignments.xlsx]
2019-12-30 7 MAGGIEs implemented.
    [HW_regs_assignments.xlsx, Pin_Assignments.xlsx]
2020-07-07 Fixed Z80_bridge. PS2 keyboard.
    [SYNC_RS232_UART.v, Z80_bridge.v, bart.v, bitplane_to_raster.v]
2020-08-22 PS/2 keyboard CAPS LOCK LED support.
2020-08-22 PS/2 keyboard LED support (CAPSLOCK)
2020-11-20 Project update with CV GPU.
    [5ceba4_pinout.xls, c5_pin_model_dump.txt]
2020-11-20 Fix files after rebase.
    [geo_pixel_writer.sv]
2021-06-30 Branch update
    [DDR3_example.csv, TEST_DDR3_example.csv, c5_pin_model_dump.txt, params.txt]
2021-11-02 Latest update.
    [Connections.xlsx, Default_IO_Pinout.xlsx, c5_pin_model_dump.txt]
2022-02-16 GPU MMU added.
    [SignalTap.stp]
2022-05-19 SD sector reader.
    [80P_FPGA_PINS.ods, Assignation_Pin.xlsx, SDI.stp, SD_Interface_Commands.xlsx, port80p.ods, sd_analysis.stp, wb_analysis.stp, z80_analysis.stp]
2022-06-23 Working SD write. MMU shadowing.
    [SDI.stp, z80_analysis.stp]
2022-06-29 Optional 4-bit SD READ mode.
    [SDI.stp]
2022-08-07 YM2149 PSG initial commit.
    [SDI.stp, jt49_analysis.stp, ym2149_analysis.stp, yt49_analysis.stp, z80_analysis.stp]
2022-08-23 Remove YM2149 project folder.
    [SDI.stp, jt49_analysis.stp, sd_analysis.stp, wb_analysis.stp, ym2149_analysis.stp, yt49_analysis.stp]
2022-08-23 Dual PSG update.
    [Frequency Response.xlsx, SDI.stp, jt49_analysis.stp, sd_analysis.stp, wb_analysis.stp, ym2149_analysis.stp, yt49_analysis.stp, z80_analysis.stp]
2023-02-26 Basic FPU & project update.
    [z80_analysis.stp]
